isystemsautomation/HOMEMASTER/partner-kit/ENM-223-R1/specs.csv

characteristic | value
Specification Details Microcontroller | RP2350A dual-core microcontroller
Metering IC | ATM90E32AS (3-phase energy metering / power quality)
Storage | External QSPI Flash (W25Q32JV)
Power Input | 24 V DC nominal (V+ / 0V) with protection (reverse polarity diode, TVS, EMI filtering)
Voltage Inputs | 3 × L1/L2/L3-N + PE sensing, 85–265 V AC (mains measurement inputs)
Current Inputs | 3 × CT channels (external current-output CTs); secondary ≤ 60 mA RMS into a 6 Ω on-board burden. Full scale 120 / 60 / 30 mA at PGA ×1 / ×2 / ×4 (default ×2). Do not use 1 A or 5 A secondary CTs.
Measured quantities | RMS voltage L1/L2/L3 (V), RMS current L1/L2/L3 and neutral (A), active / reactive / apparent power per phase and total (W, var, VA), power factor per phase and total, line frequency (Hz), voltage–current angle L1/L2/L3 (°), THD L1/L2/L3 (%), active and reactive energy import/export per phase and total (Wh, varh), temperature (°C), sag / overvoltage / phase-loss / overcurrent / frequency / reverse-phase-sequence flags
Relay Outputs | 2 × SPDT dry-contact relays (NO / COM / NC). Rated load (system limit): 3 A @ 250 V AC (resistive contact rating). Max load: 750 VA @ 250 V AC, 90 W @ 30 V DC. Relay outputs are not internally fused ; external overcurrent protection is required.
RS-485 | RS-485 Modbus RTU (MAX485, half-duplex), non-isolated; TVS surge protection, PTC fuses, common-mode choke, fail-safe biasing
USB | USB-C (ESD protected), configuration and firmware upload
File System | LittleFS persistent configuration storage
User Interface | 4 buttons; 9 LEDs (power, 4 user LEDs, RX, TX, relay status)
Modbus Address Range | 1–247 (default is configurable; typically 3)
Modbus Baud Rate | 9600–115200 (default: 19200, 8N1)
Category Specification Details Terminal Specifications | Terminal type Pluggable screw terminal blocks, 5.08 mm pitch
Environmental Ratings | Operating temperature 0 °C to +40 °C
Mechanical &amp; Packaging | Product dimensions 71.5 × 90 × 59 mm (L × W × H)
File Description Link Field Board Schematic | Voltage sensing and CT front-end ENM-223-R1-FieldBoard.pdf
MCU Board Schematic | Controller, RS-485, USB, power conversion ENM-223-R1-MCUBoard.pdf
Relay Board Schematic | Relay output stage ENM-223-R1-RelayBoard.pdf
File Description Link EU Declaration of Conformity (DoC) | Signed EU Declaration of Conformity per Reg. (EC) 765/2008 and Decision 768/2008/EC DoC_ENM-223-R1.pdf
Datasheet | Technical specifications and electrical characteristics ENM-223-R1_Datasheet.pdf
