isystemsautomation/HOMEMASTER/partner-kit/MicroPLC/specs.csv

characteristic | value
Specification Details Microcontroller | ESP32-WROOM-32U-N16 (dual-core)
Flash Memory | 16 MB SPI flash
SRAM | 536 KB SRAM
Power Input | 24 V DC nominal (24VDC)
Digital Inputs | 1 × IEC 61131-2 compliant 24 V digital input (ISO1212 front-end), dry-contact (module-wetted), with PTC fuse, TVS surge and reverse-polarity protection
Relay Outputs | 1 × relay (HF115F-005-1ZS3), C and NC only (no NO) — functionally SPST-NC; closed when de-energised
Temperature Inputs | 1-Wire interface supported
User Interface | 1 button, status LEDs
Wi-Fi | Integrated Wi-Fi (ESP32)
Wi-Fi standard | IEEE 802.11 b/g/n (2.4 GHz)
RS-485 | RS-485 Modbus RTU (MAX485, half-duplex), non-isolated; TVS surge protection, PTC fuses, common-mode choke, fail-safe biasing
Storage | Internal ESP32 flash
USB | USB-C programming interface via CP2102N USB-UART bridge
RTC | PCF8563 RTC with CR2032 battery backup
Category Specification Details Terminal Specifications | Terminal type Pluggable screw terminal blocks, 5.08 mm pitch
Environmental Ratings | Operating temperature 0 °C to +40 °C
Mechanical &amp; Packaging | Product dimensions 35.5 × 91 × 67.3 mm (L × W × H)
File Description Link Schematic (MCU Board) | Main controller board schematic MCUBoard.pdf
Schematic (Relay Board) | Relay and power section schematic RelayBoard.pdf
File Description Link EU Declaration of Conformity (DoC) | Signed EU Declaration of Conformity per Reg. (EC) 765/2008 and Decision 768/2008/EC DoC_MicroPLC.pdf
Datasheet | Technical specifications and electrical characteristics MicroPLC_Datasheet.pdf
Resource Description Link Default ESPHome Config | Pre-configured YAML for Home Assistant microplc.yaml
