isystemsautomation/HOMEMASTER/AIO-422-R1/Images/AIO-FieldBoard.png

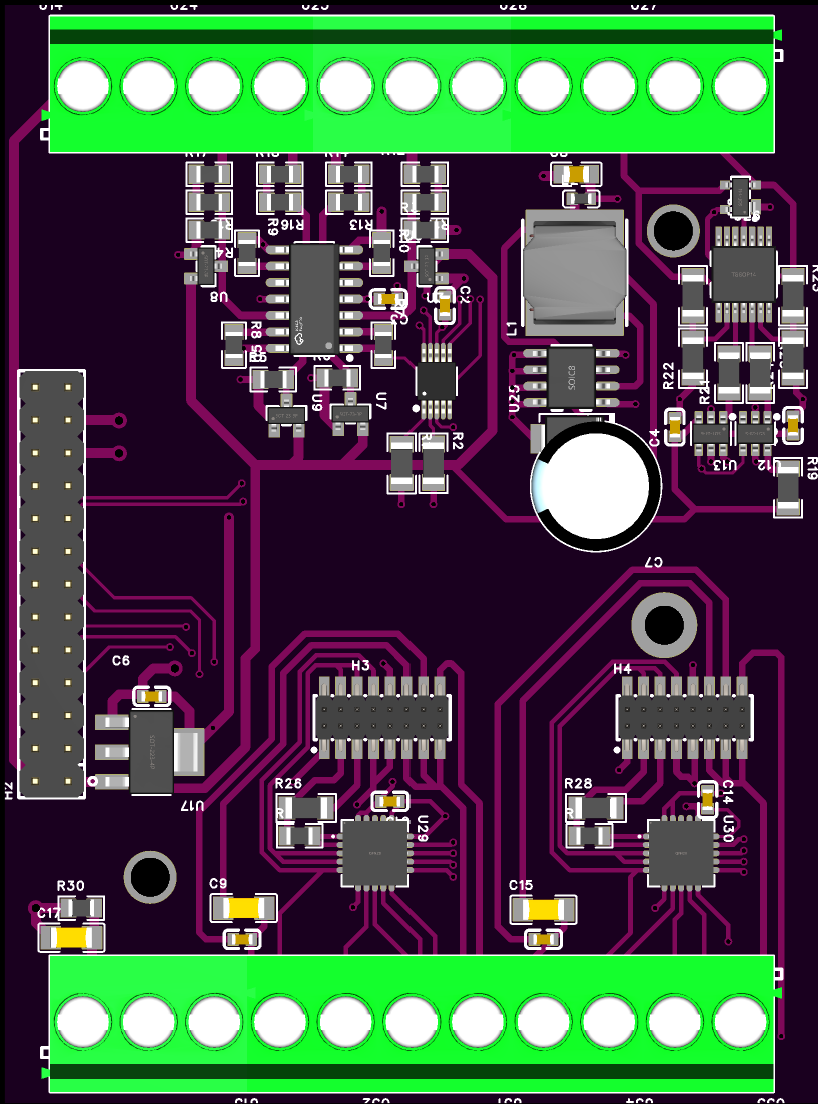
AIO-422-R1/Images/AIO-FieldBoard.png
