isystemsautomation/HOMEMASTER/AIO-422-R1/Images/AIO-MCUBoard.png

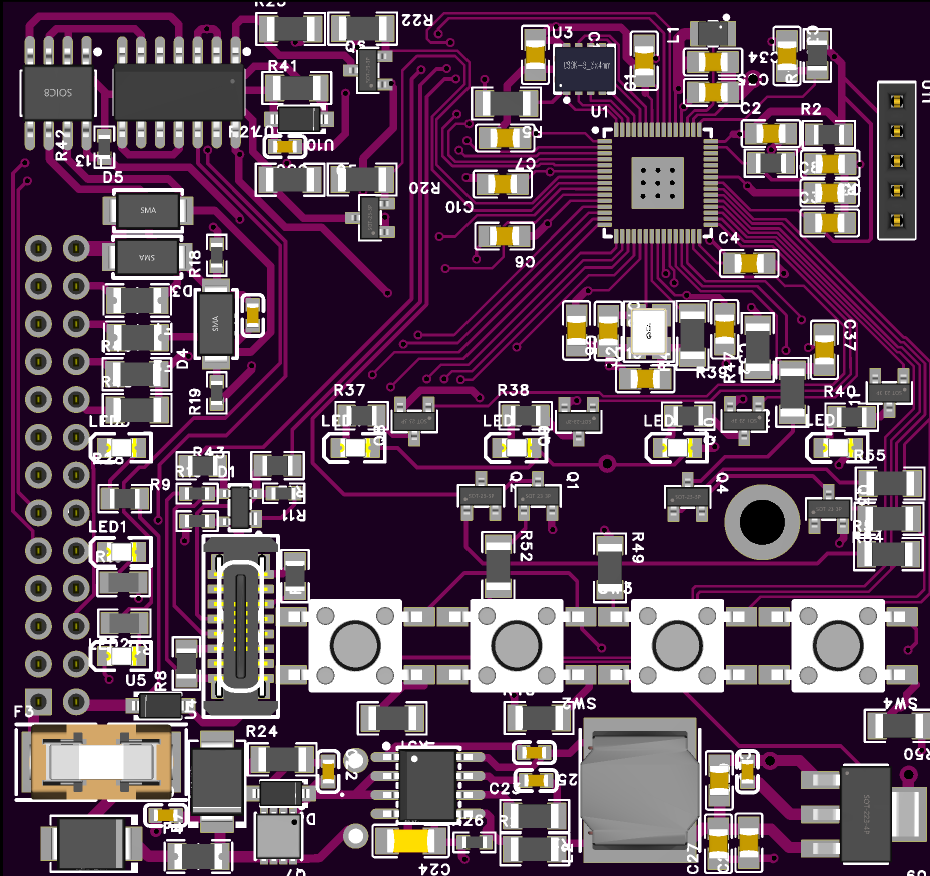
AIO-422-R1/Images/AIO-MCUBoard.png
