isystemsautomation/HOMEMASTER/AIO-422-R1/Images/AIO_AnalogInputs.png

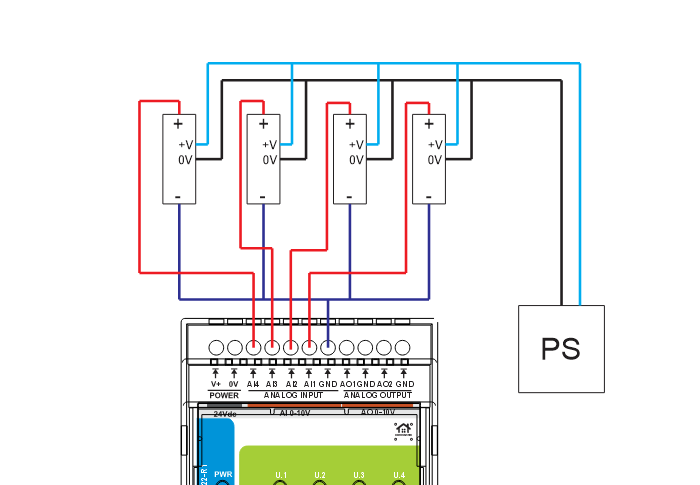
AIO-422-R1/Images/AIO_AnalogInputs.png
