isystemsautomation/HOMEMASTER/AIO-422-R1/Images/AIO_PowerSupply_Connection.png

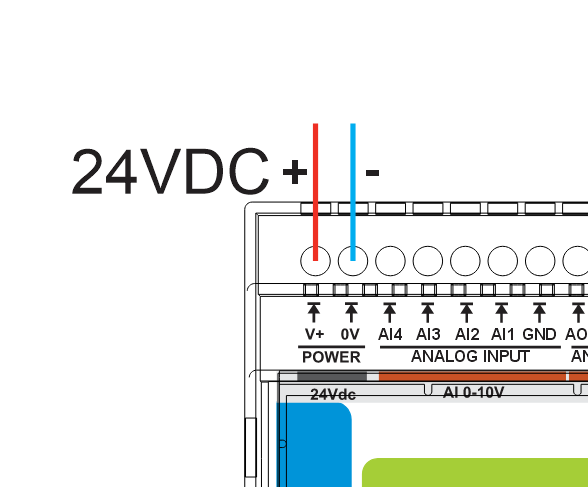
AIO-422-R1/Images/AIO_PowerSupply_Connection.png
