isystemsautomation/HOMEMASTER/AIO-422-R1/Images/AIO_RS485Connection.png

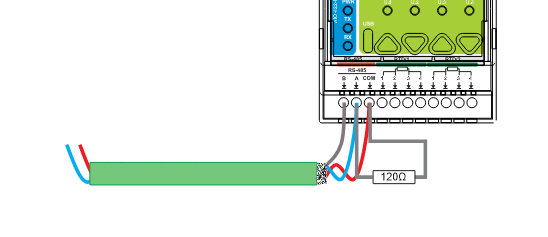
AIO-422-R1/Images/AIO_RS485Connection.png
