isystemsautomation/HOMEMASTER/AIO-422-R1/Images/AIO_RTD_Connection.png

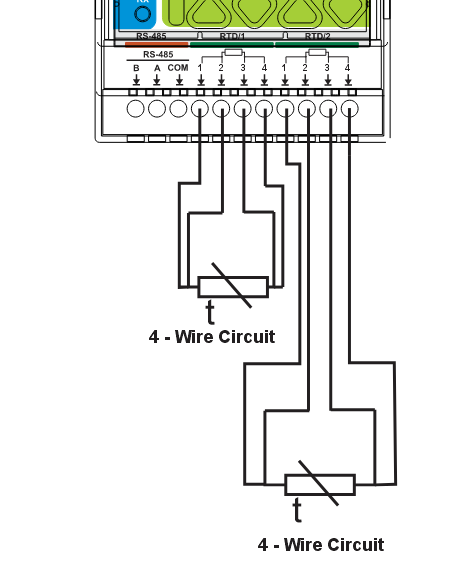
AIO-422-R1/Images/AIO_RTD_Connection.png
