isystemsautomation/HOMEMASTER/AIO-422-R1/Images/AIO_SystemBlockDiagram.png

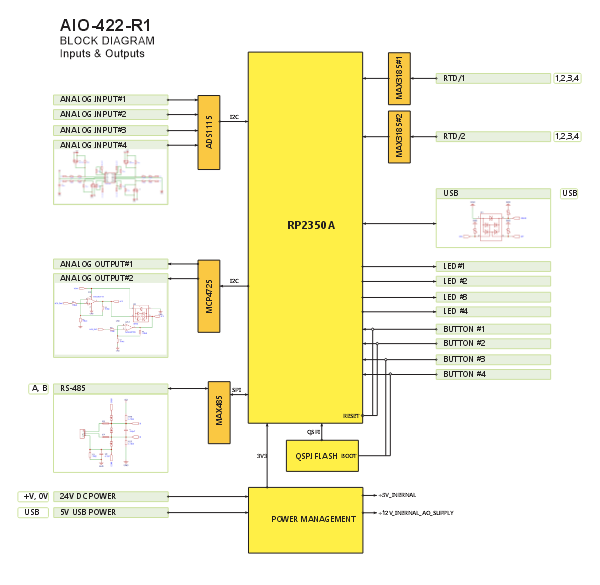
AIO-422-R1/Images/AIO_SystemBlockDiagram.png
