isystemsautomation/HOMEMASTER/AIO-422-R1/Images/DIO Dimensions.png

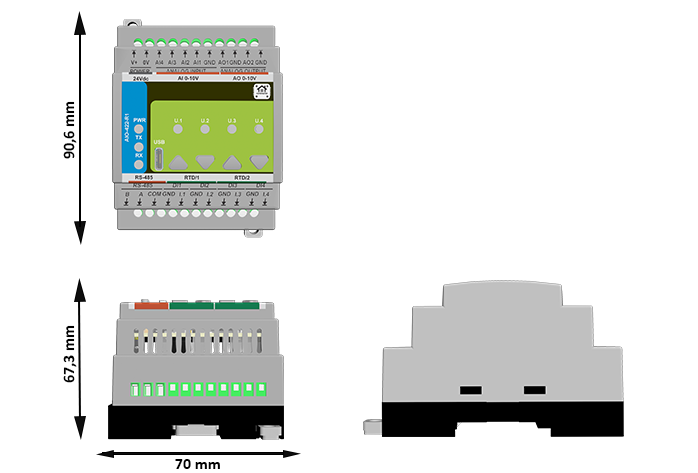
AIO-422-R1/Images/DIO Dimensions.png
