isystemsautomation/HOMEMASTER/AIO-422-R1/Images/FieldBoard_Diagram.png

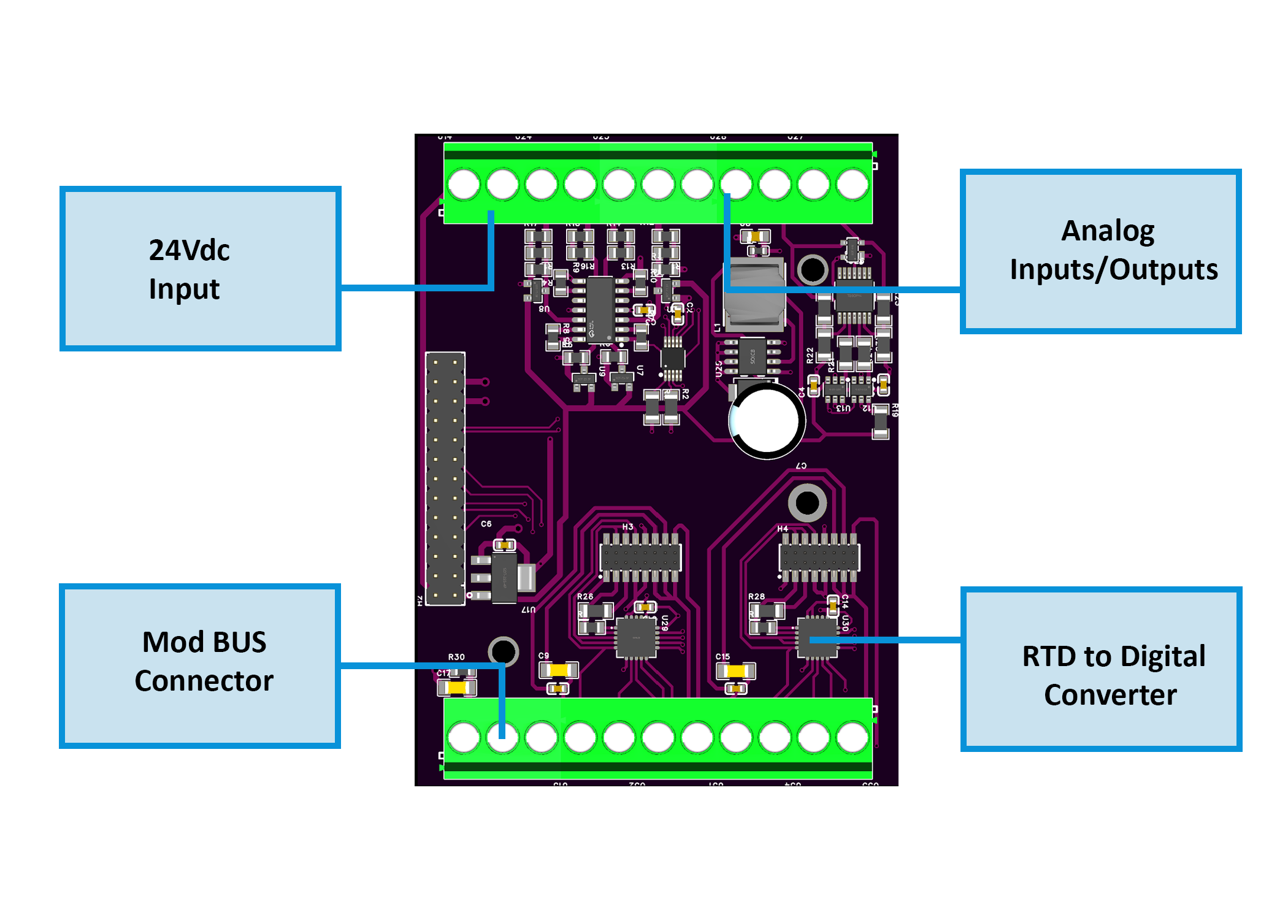
AIO-422-R1/Images/FieldBoard_Diagram.png
