isystemsautomation/HOMEMASTER/AIO-422-R1/Images/photo3.png

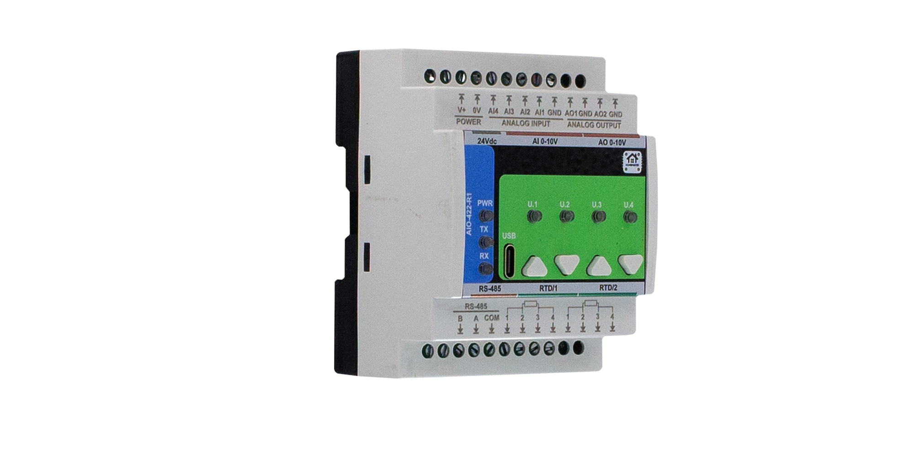
AIO-422-R1/Images/photo3.png
