isystemsautomation/HOMEMASTER/AIO-422-R1/Images/RS-485 Connection.png

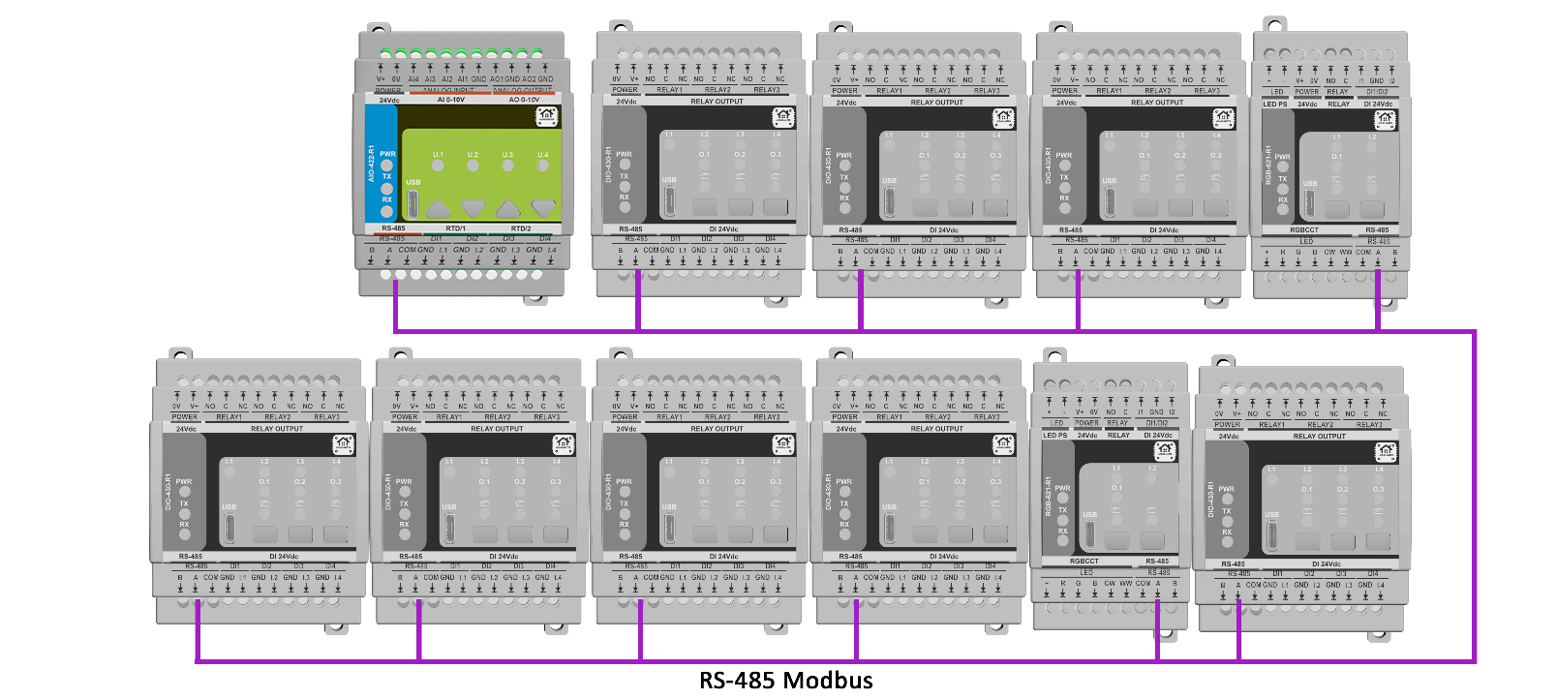
AIO-422-R1/Images/RS-485 Connection.png
