isystemsautomation/HOMEMASTER/ALM-173-R1/Images/photo3.png

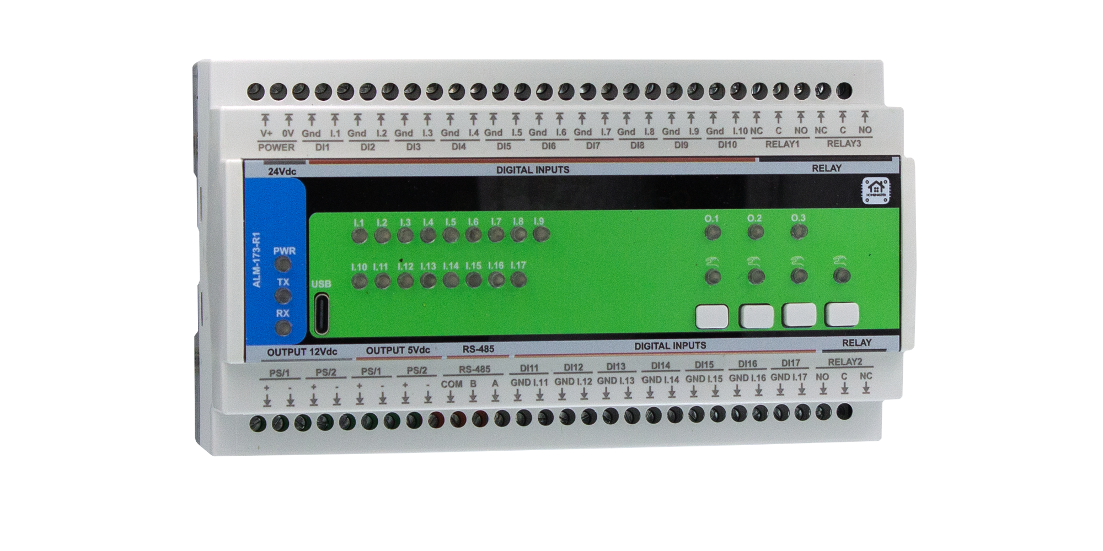
ALM-173-R1/Images/photo3.png
