isystemsautomation/HOMEMASTER/DIM-420-R1/Images/DIM_LN_Connection.png

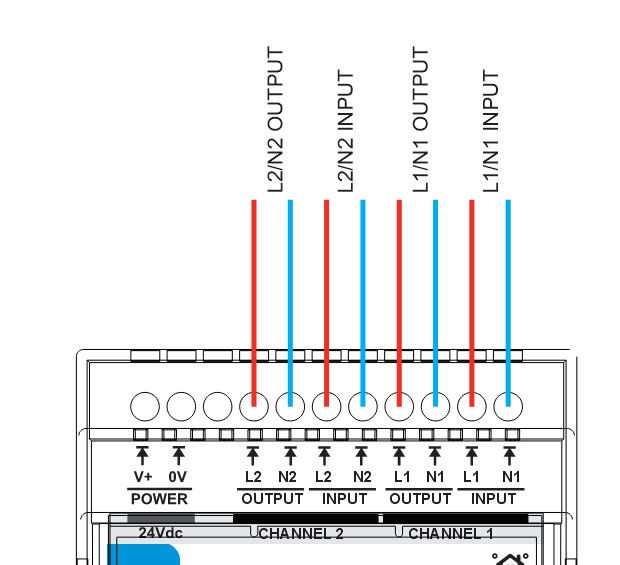
DIM-420-R1/Images/DIM_LN_Connection.png
