isystemsautomation/HOMEMASTER/DIM-420-R1/Images/DIM_SystemBlockDiagram.png

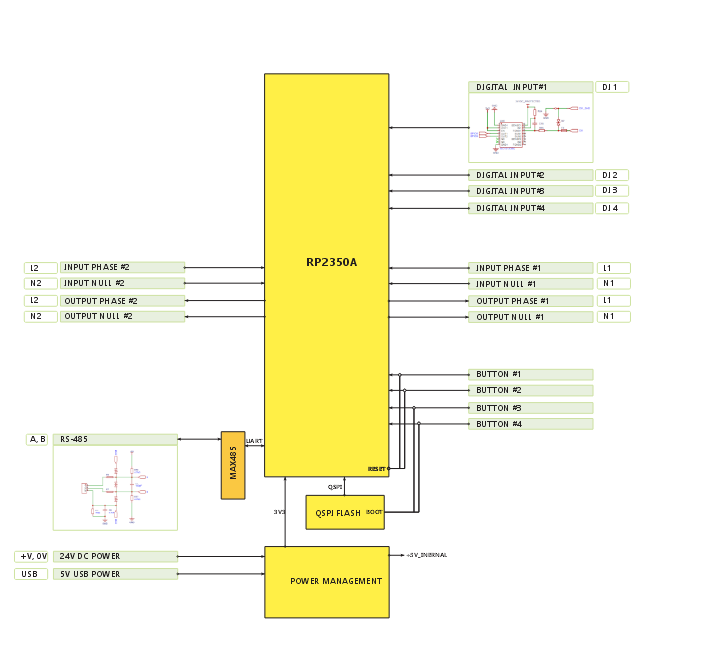
DIM-420-R1/Images/DIM_SystemBlockDiagram.png
