isystemsautomation/HOMEMASTER/ENM-223-R1/Images/ENM_24Vdc.png

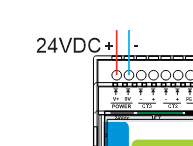
ENM-223-R1/Images/ENM_24Vdc.png
