isystemsautomation/HOMEMASTER/ENM-223-R1/Images/ENM_CTConnection.png

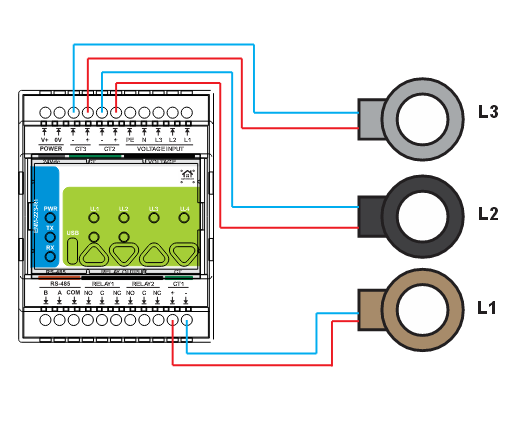
ENM-223-R1/Images/ENM_CTConnection.png
