isystemsautomation/HOMEMASTER/ENM-223-R1/Images/ENM_PhaseConnection.png

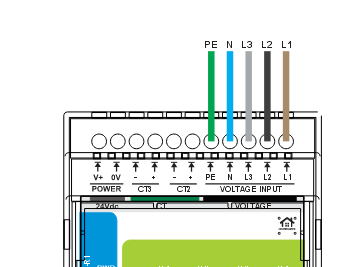
ENM-223-R1/Images/ENM_PhaseConnection.png
