isystemsautomation/HOMEMASTER/ENM-223-R1/Images/ENM_RelayConnection.png

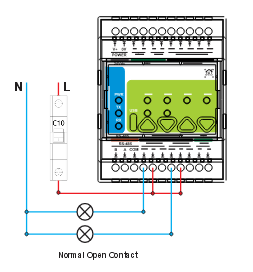
ENM-223-R1/Images/ENM_RelayConnection.png
