isystemsautomation/HOMEMASTER/ENM-223-R1/Images/photo3.png

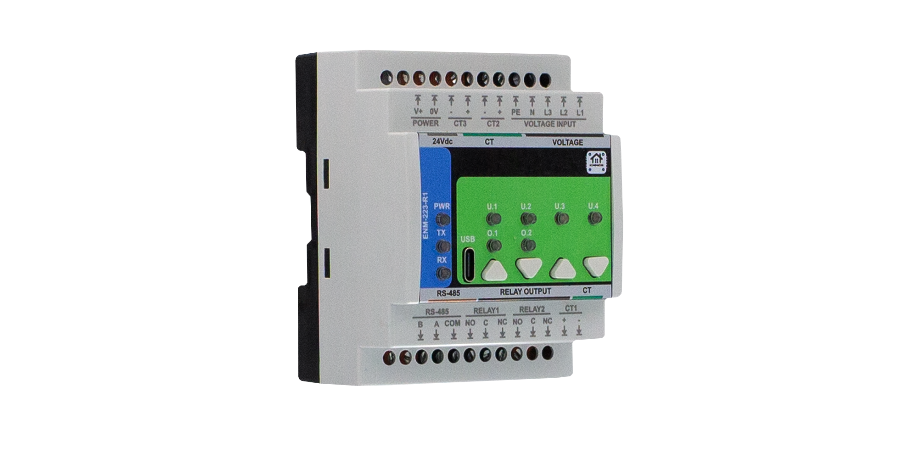
ENM-223-R1/Images/photo3.png
