isystemsautomation/HOMEMASTER/MicroPLC/Images/dimensions.png

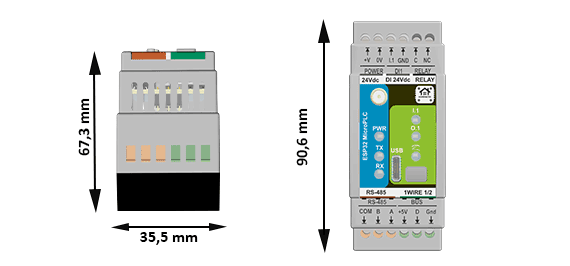
MicroPLC/Images/dimensions.png
