isystemsautomation/HOMEMASTER/MiniPLC/Images/Photo1.png

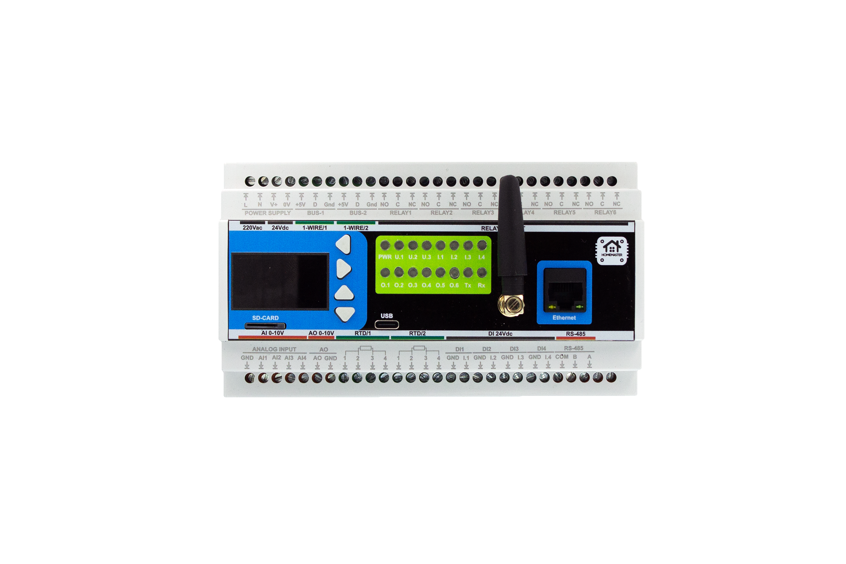
MiniPLC/Images/Photo1.png
