isystemsautomation/HOMEMASTER/OpenthermGateway/Images/description3.png

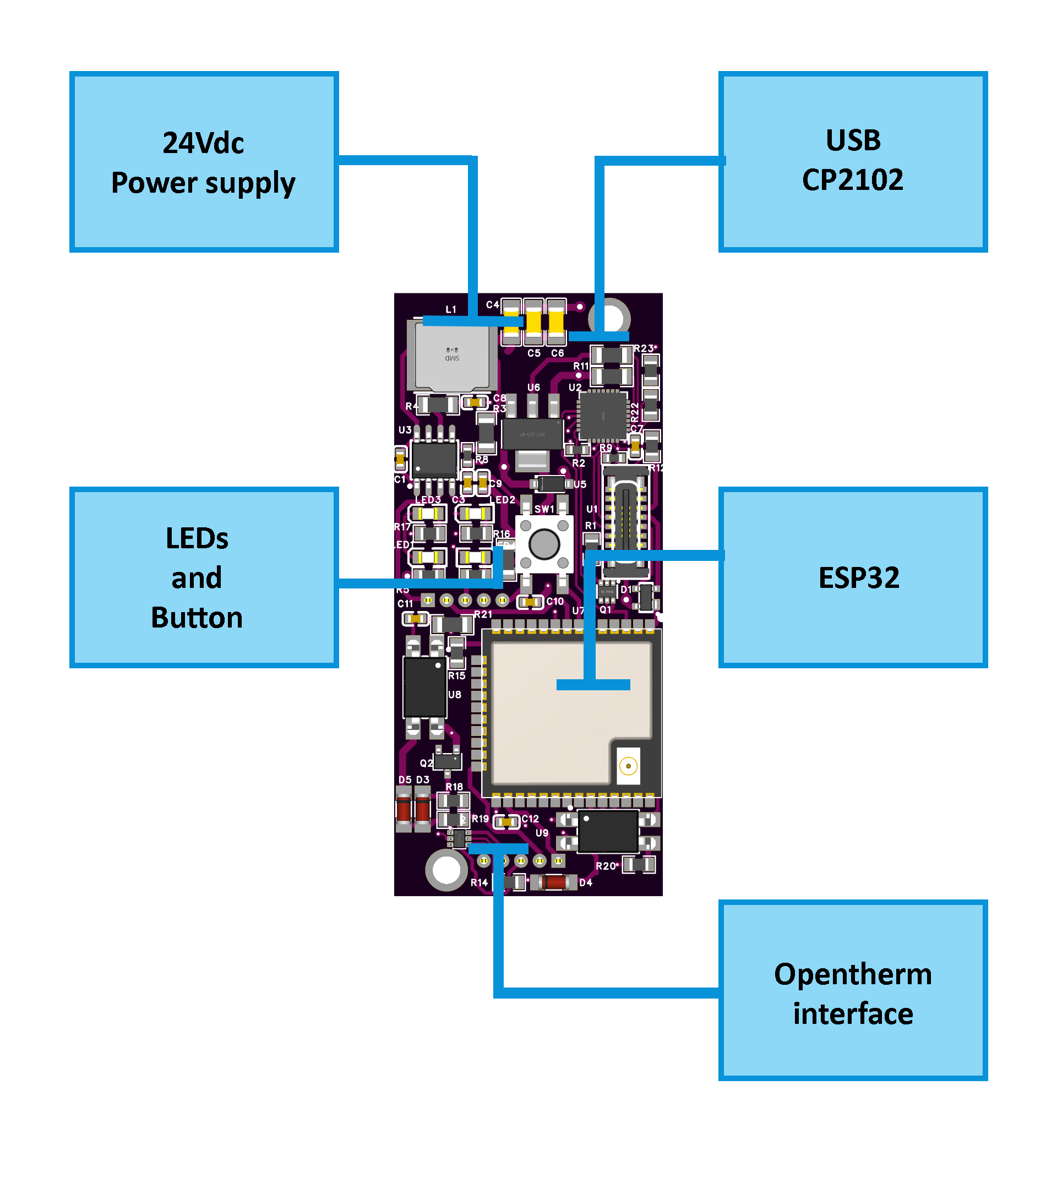
OpenthermGateway/Images/description3.png
