isystemsautomation/HOMEMASTER/OpenthermGateway/Images/description4.png

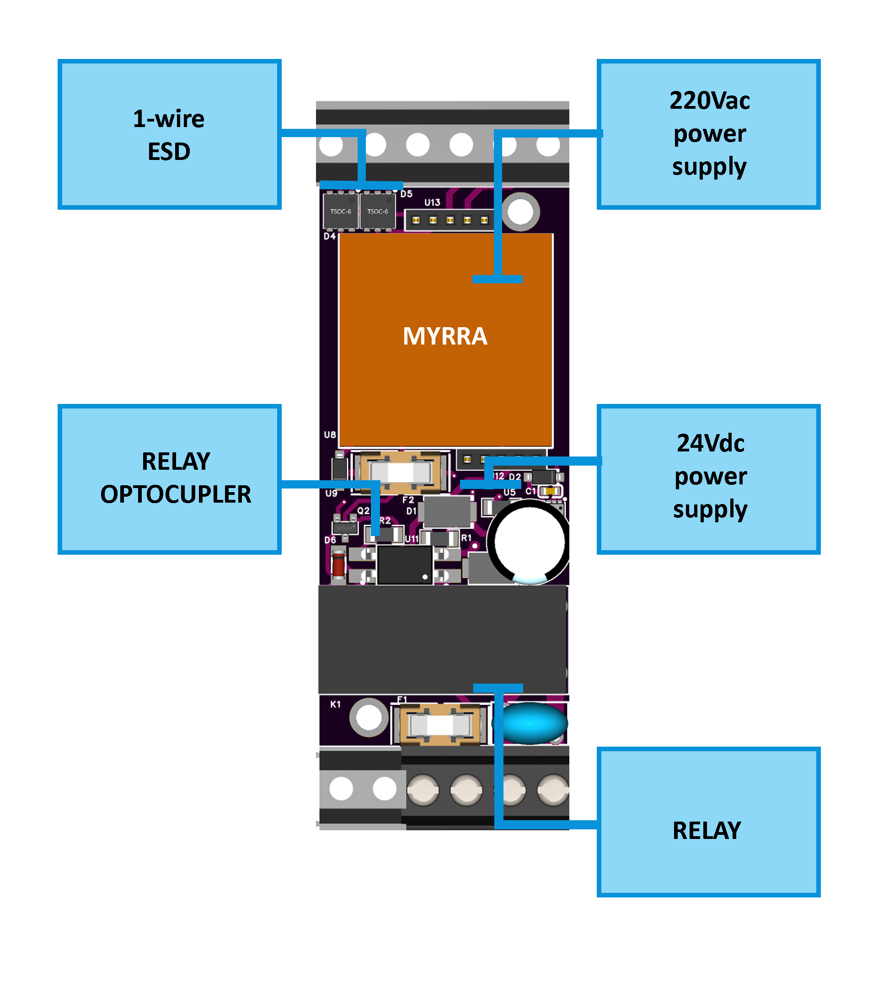
OpenthermGateway/Images/description4.png
