isystemsautomation/HOMEMASTER/OpenthermGateway/Images/OpenTherm_SystemBlock.png

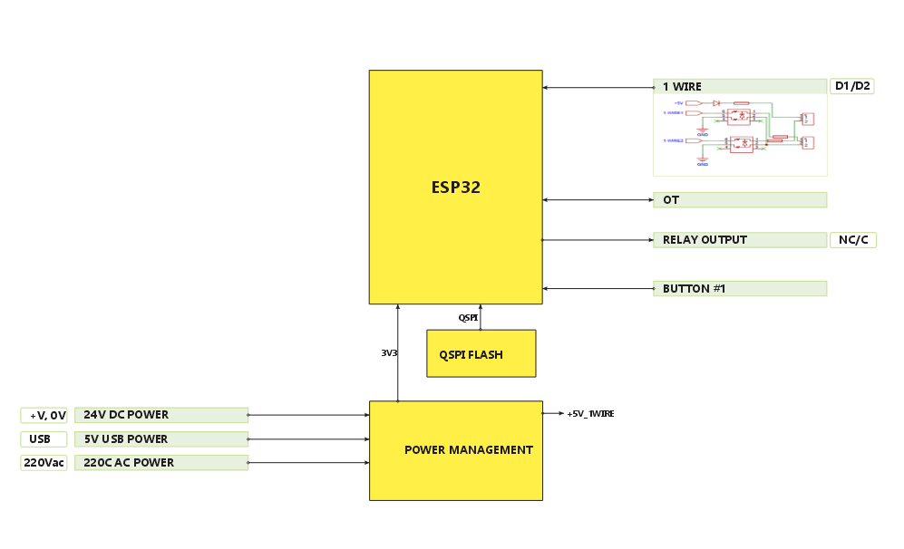
OpenthermGateway/Images/OpenTherm_SystemBlock.png
