isystemsautomation/HOMEMASTER/OpenthermGateway/photo2.png

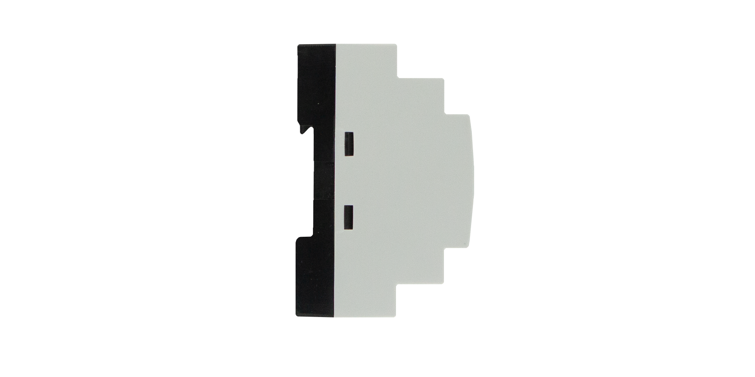
OpenthermGateway/photo2.png
