isystemsautomation/HOMEMASTER/partner-kit/AIO-422-R1/images/01-main.webp

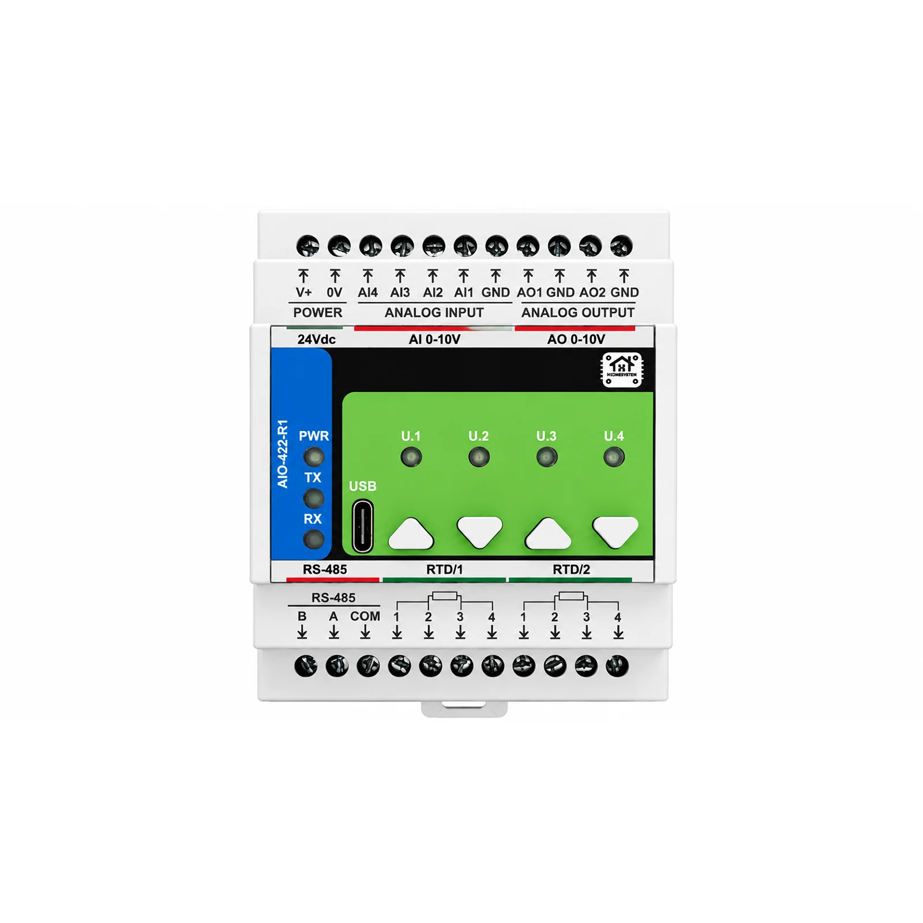
partner-kit/AIO-422-R1/images/01-main.webp
