isystemsautomation/HOMEMASTER/partner-kit/AIO-422-R1/images/02-listing-1.webp

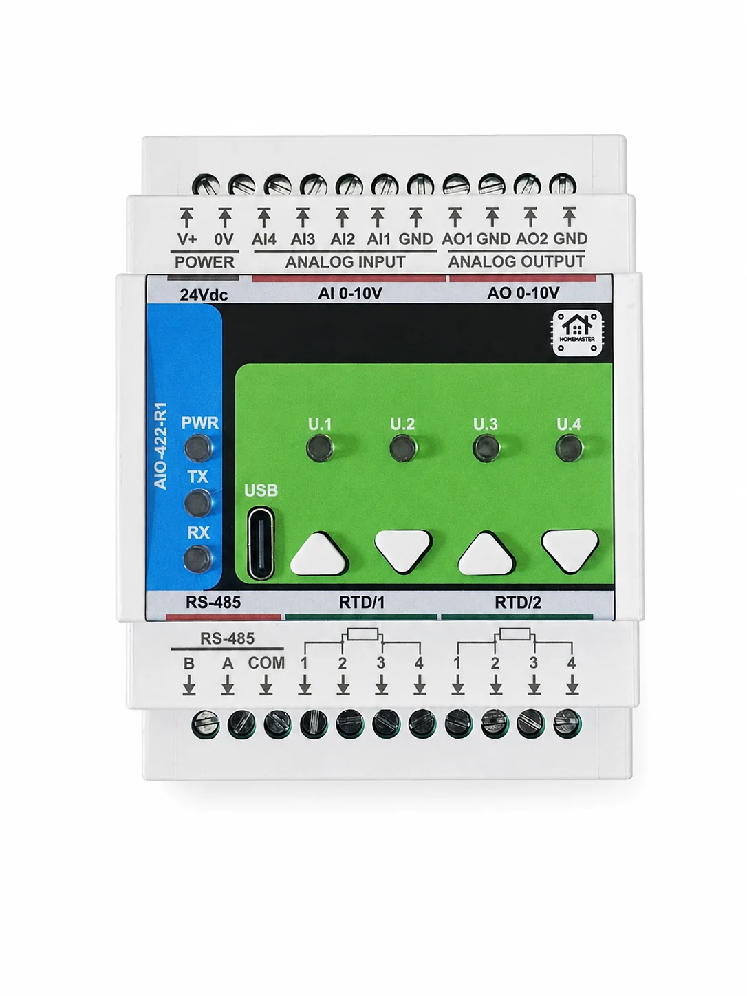
partner-kit/AIO-422-R1/images/02-listing-1.webp
