isystemsautomation/HOMEMASTER/partner-kit/AIO-422-R1/images/03-listing-2.webp

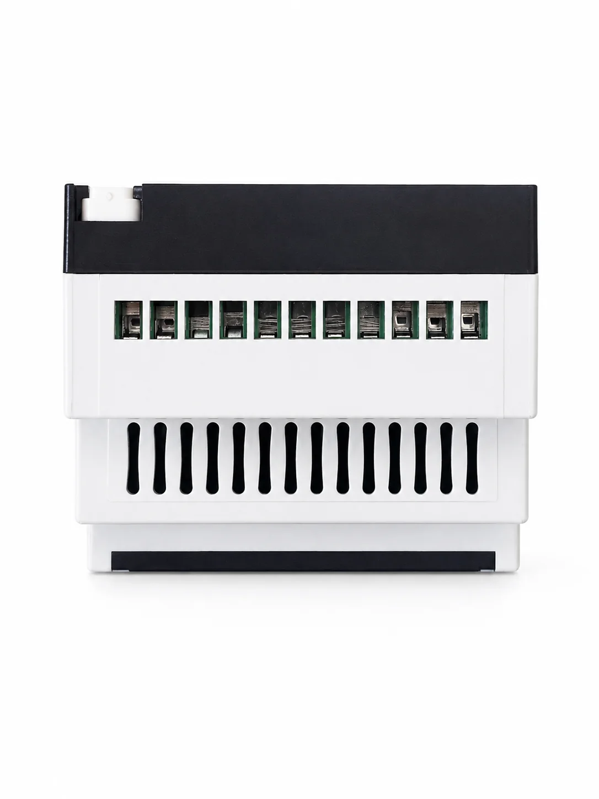
partner-kit/AIO-422-R1/images/03-listing-2.webp
