isystemsautomation/HOMEMASTER/partner-kit/AIO-422-R1/images/04-listing-3.webp

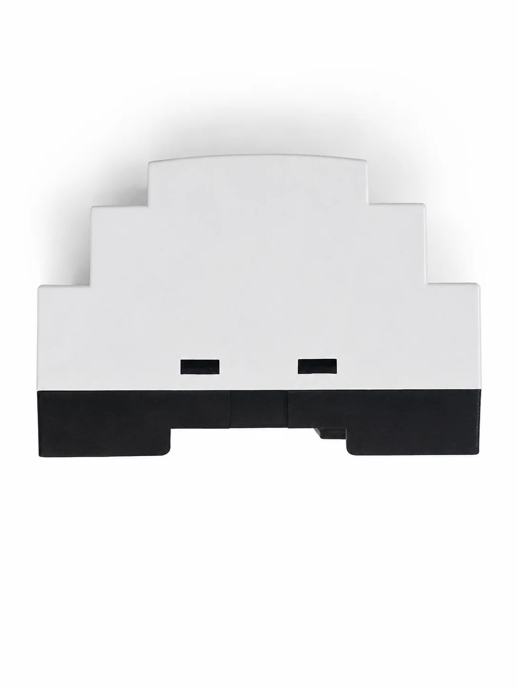
partner-kit/AIO-422-R1/images/04-listing-3.webp
