isystemsautomation/HOMEMASTER/partner-kit/AIO-422-R1/images/05-package.webp

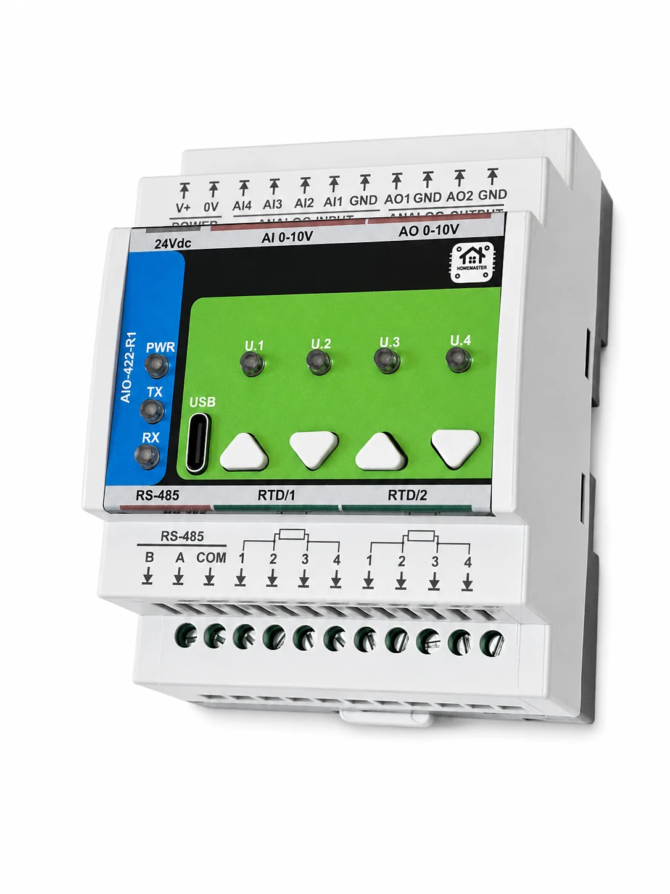
partner-kit/AIO-422-R1/images/05-package.webp
