isystemsautomation/HOMEMASTER/partner-kit/ALM-173-R1/images/01-main.webp

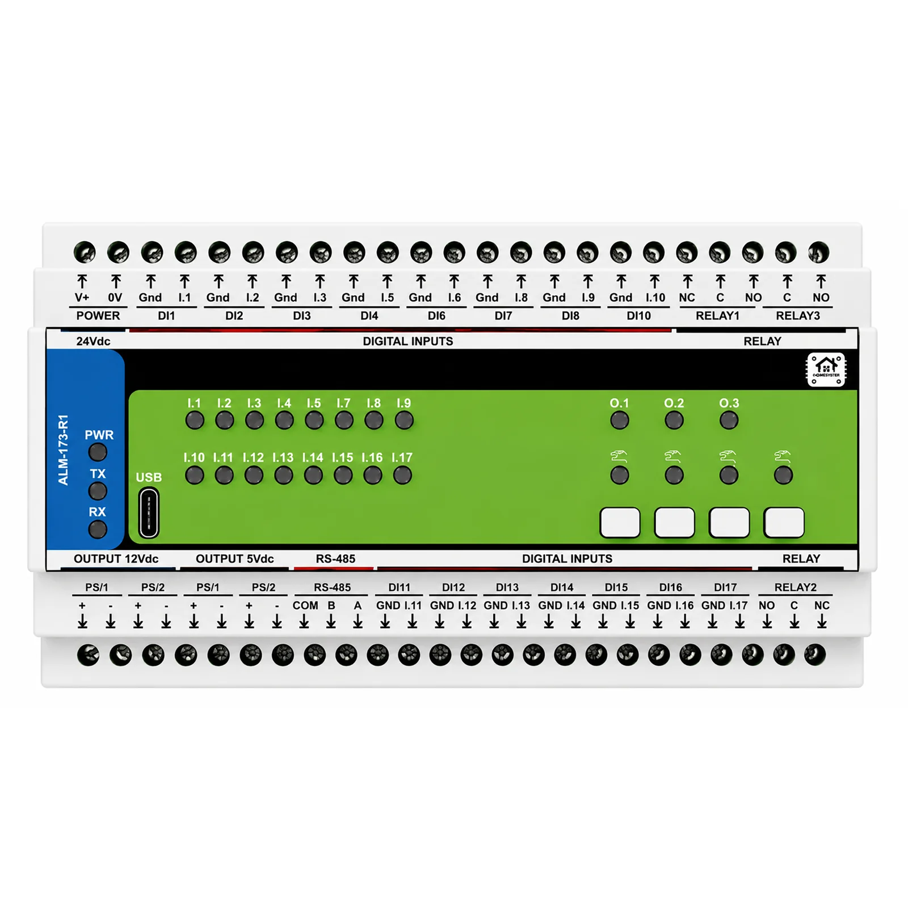
partner-kit/ALM-173-R1/images/01-main.webp
