isystemsautomation/HOMEMASTER/partner-kit/ALM-173-R1/images/02-listing-1.webp

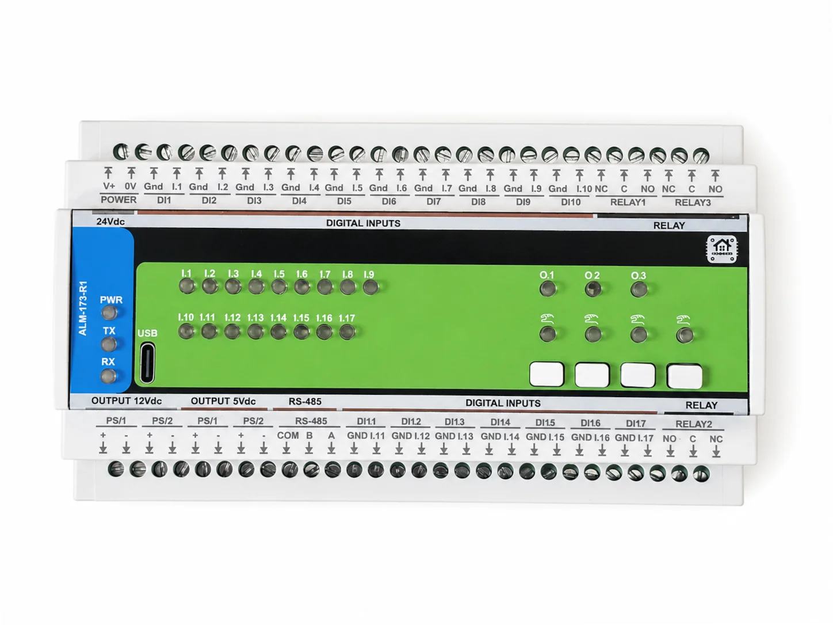
partner-kit/ALM-173-R1/images/02-listing-1.webp
