isystemsautomation/HOMEMASTER/partner-kit/ALM-173-R1/images/03-listing-2.webp

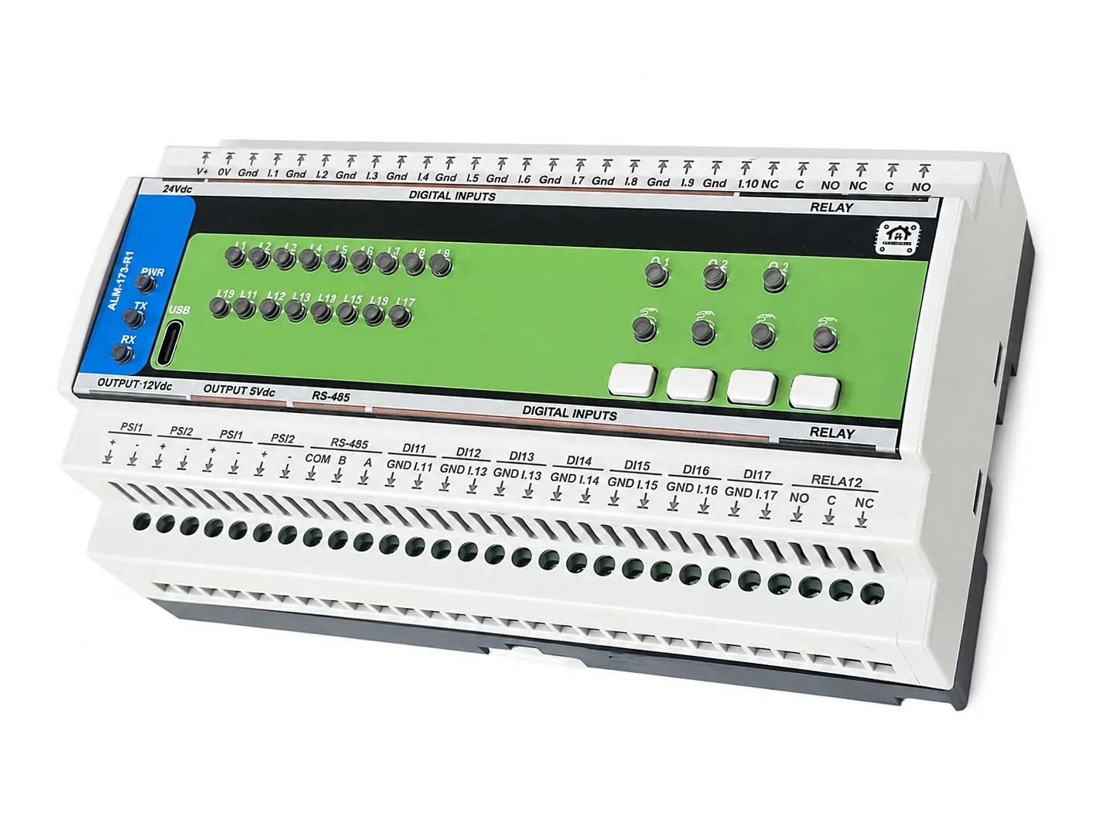
partner-kit/ALM-173-R1/images/03-listing-2.webp
