isystemsautomation/HOMEMASTER/partner-kit/ALM-173-R1/images/04-listing-3.webp

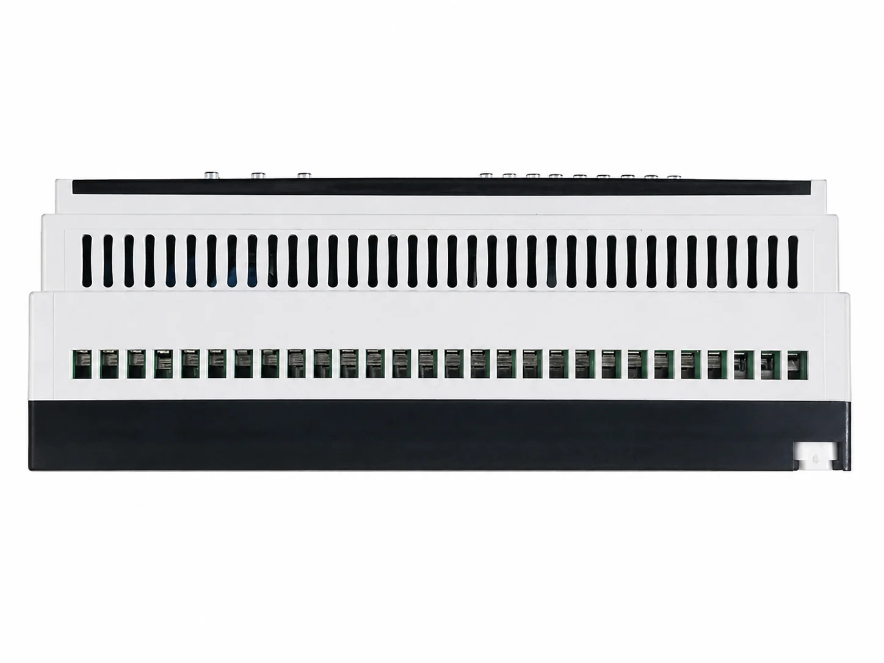
partner-kit/ALM-173-R1/images/04-listing-3.webp
