isystemsautomation/HOMEMASTER/partner-kit/DIM-420-R1/images/01-main.webp

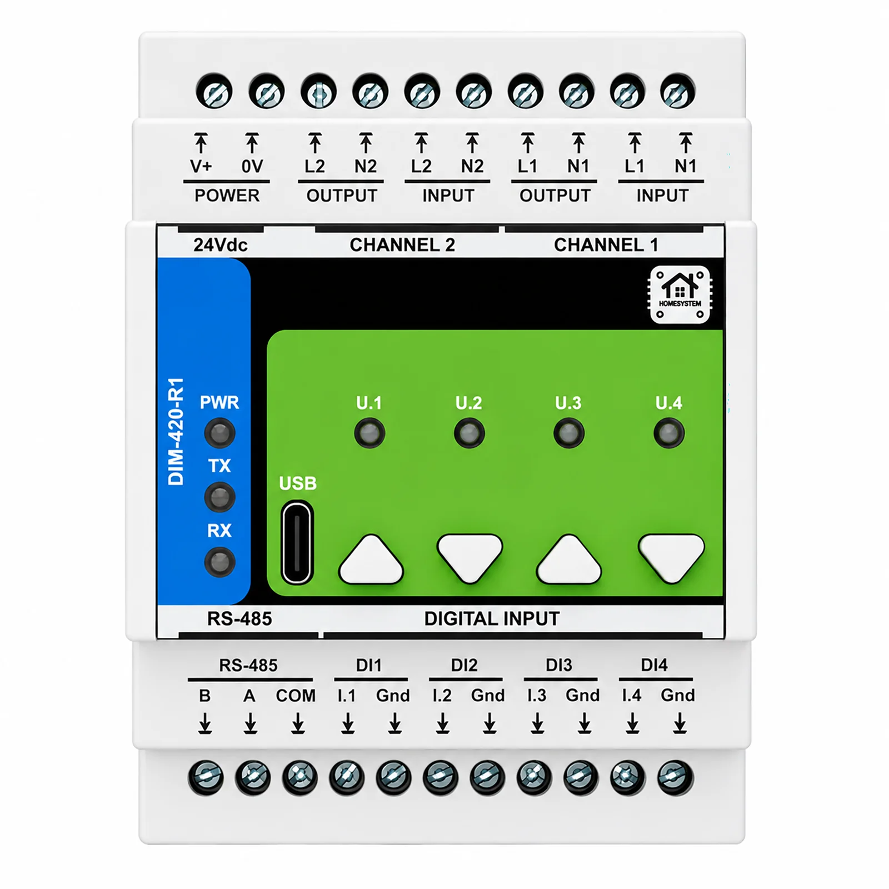
partner-kit/DIM-420-R1/images/01-main.webp
