isystemsautomation/HOMEMASTER/partner-kit/DIM-420-R1/images/06-dimensions.webp

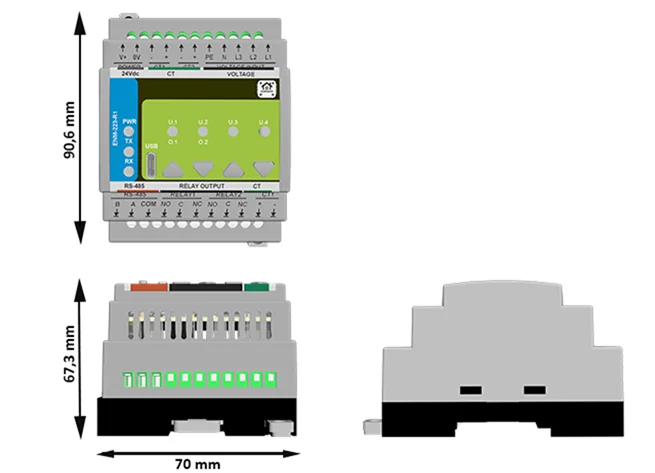
partner-kit/DIM-420-R1/images/06-dimensions.webp
