isystemsautomation/HOMEMASTER/partner-kit/DIO-430-R1/images/01-main.webp

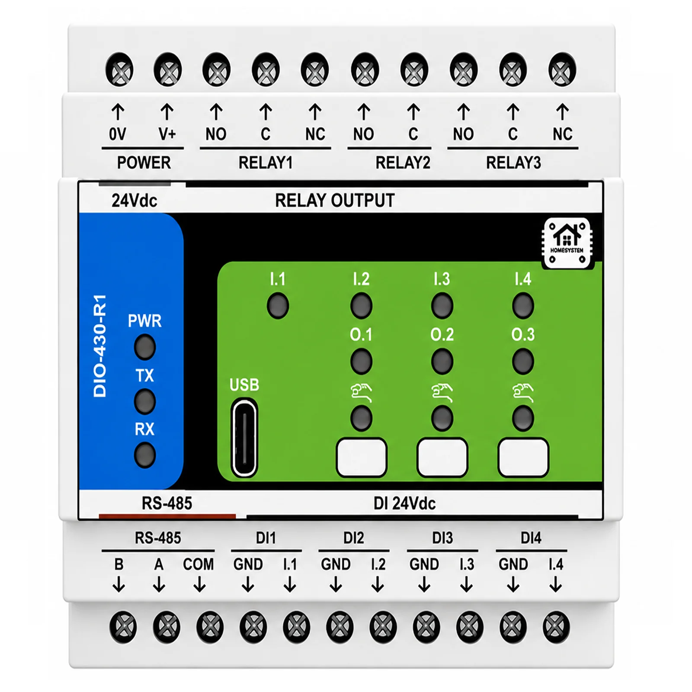
partner-kit/DIO-430-R1/images/01-main.webp
