isystemsautomation/HOMEMASTER/partner-kit/DIO-430-R1/images/02-listing-1.webp

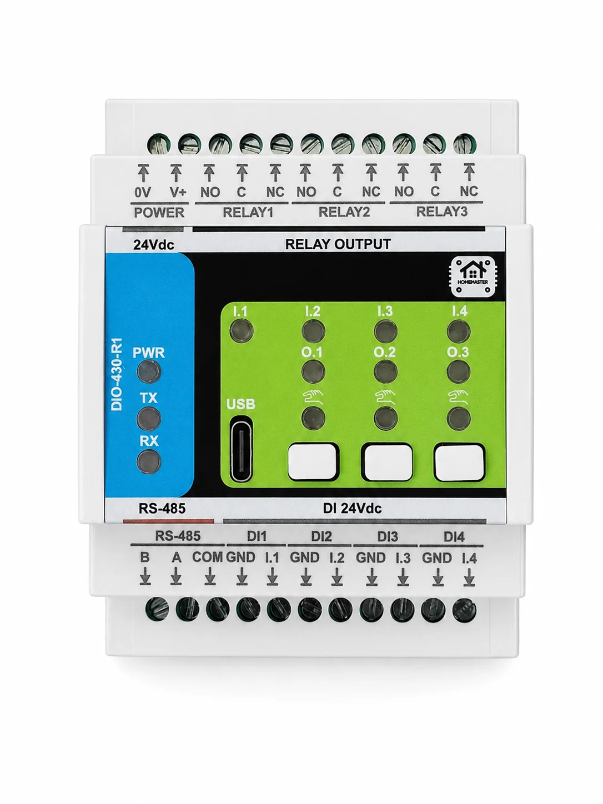
partner-kit/DIO-430-R1/images/02-listing-1.webp
