isystemsautomation/HOMEMASTER/partner-kit/DIO-430-R1/images/05-package.webp

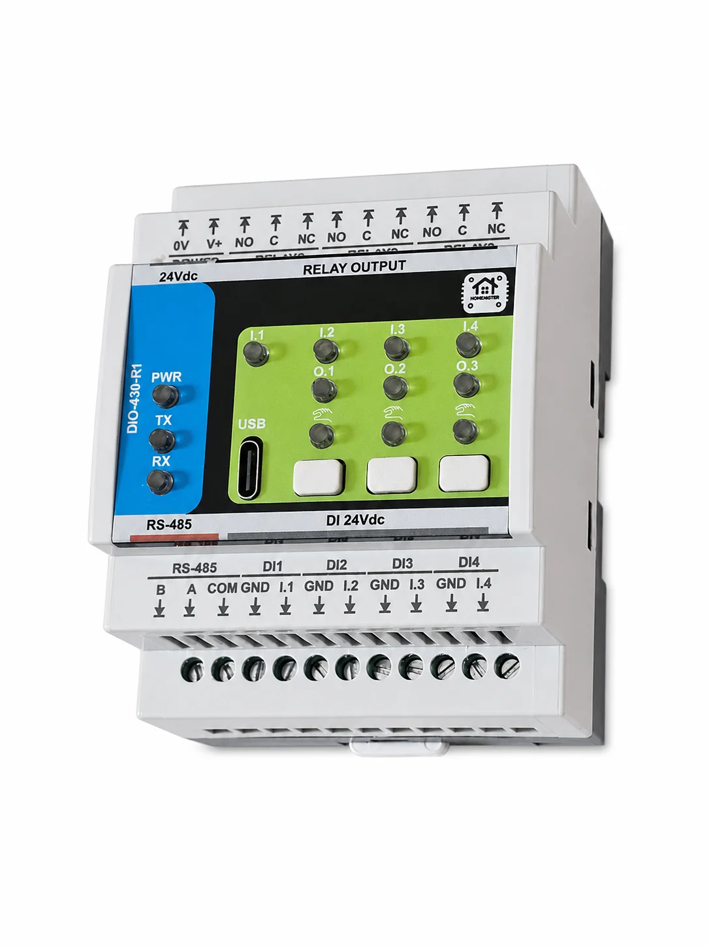
partner-kit/DIO-430-R1/images/05-package.webp
