isystemsautomation/HOMEMASTER/partner-kit/ENM-223-R1/images/01-main.webp

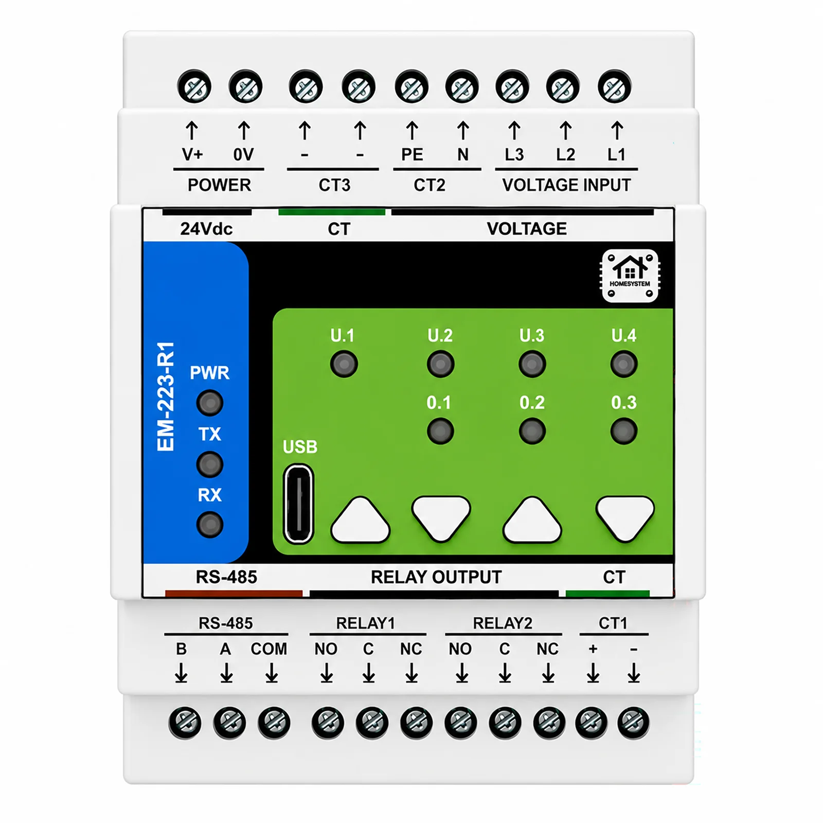
partner-kit/ENM-223-R1/images/01-main.webp
