isystemsautomation/HOMEMASTER/partner-kit/ENM-223-R1/images/02-listing-1.webp

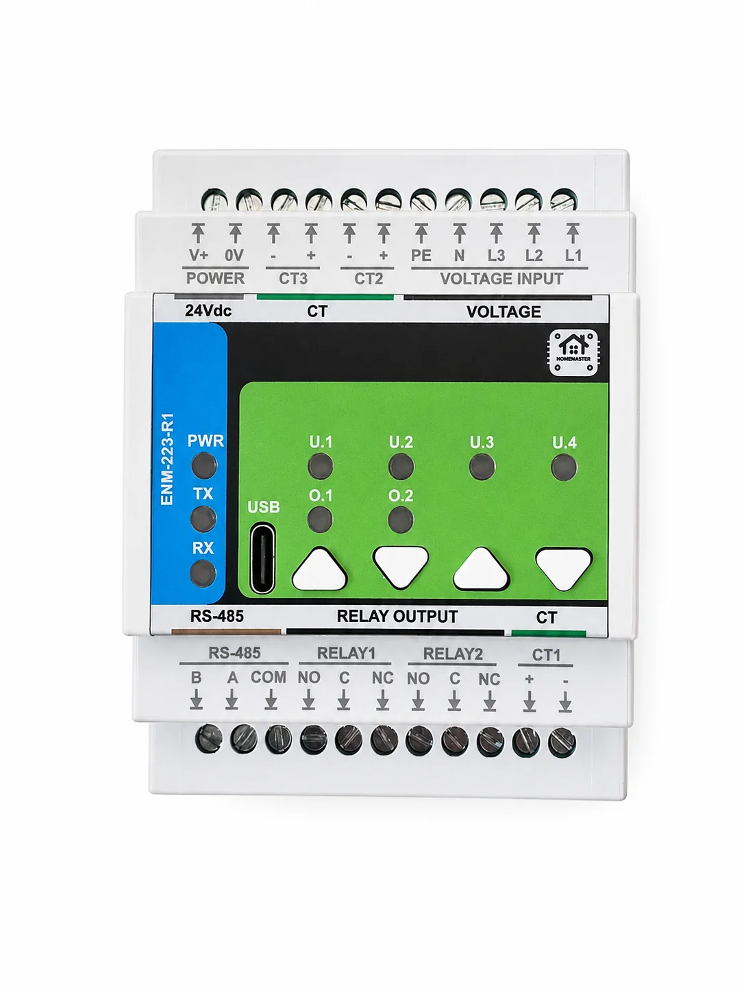
partner-kit/ENM-223-R1/images/02-listing-1.webp
