isystemsautomation/HOMEMASTER/partner-kit/ENM-223-R1/images/05-package.webp

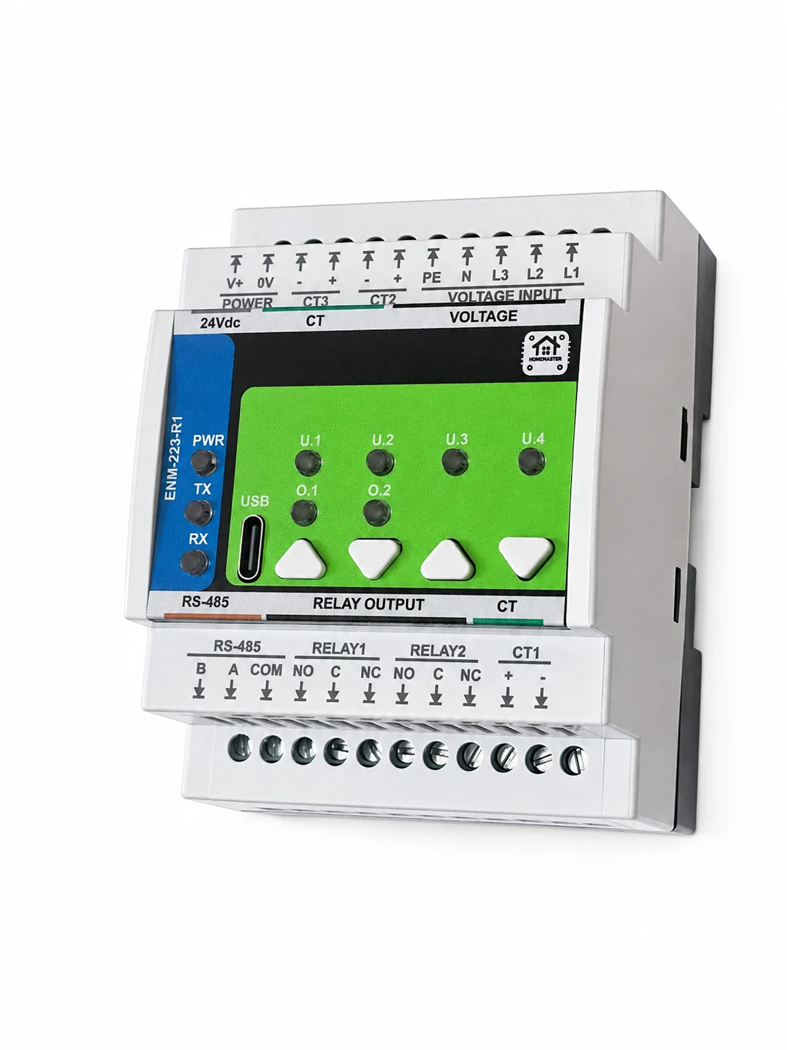
partner-kit/ENM-223-R1/images/05-package.webp
