isystemsautomation/HOMEMASTER/partner-kit/MicroPLC/images/01-main.webp

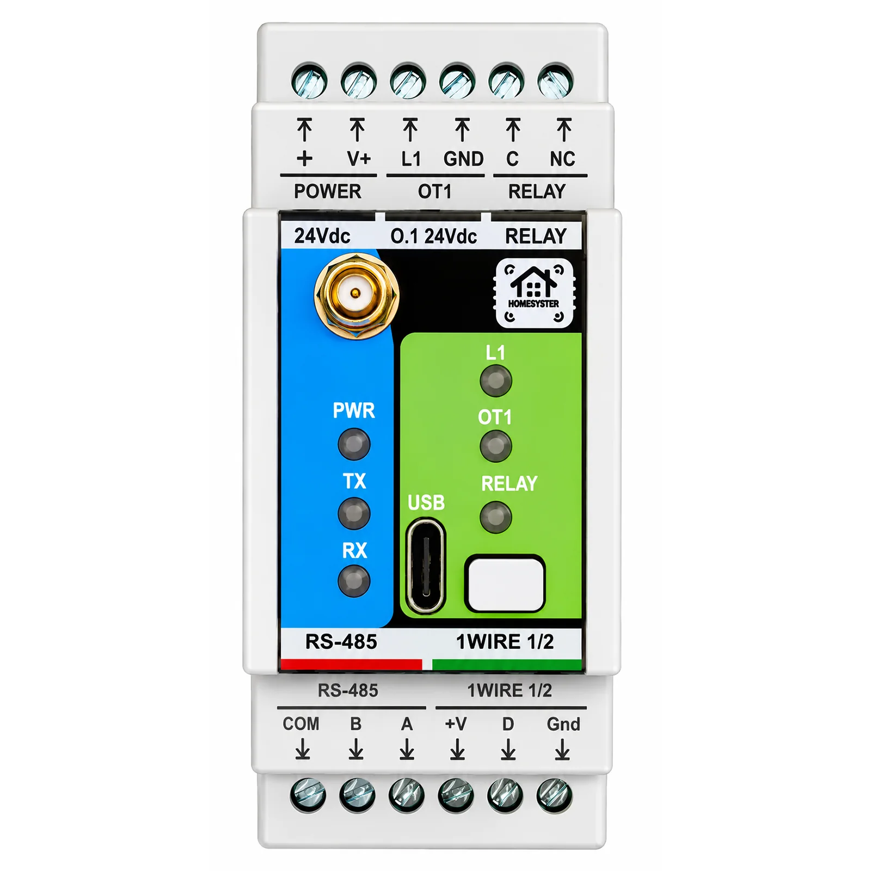
partner-kit/MicroPLC/images/01-main.webp
