isystemsautomation/HOMEMASTER/partner-kit/MicroPLC/images/02-listing-1.webp

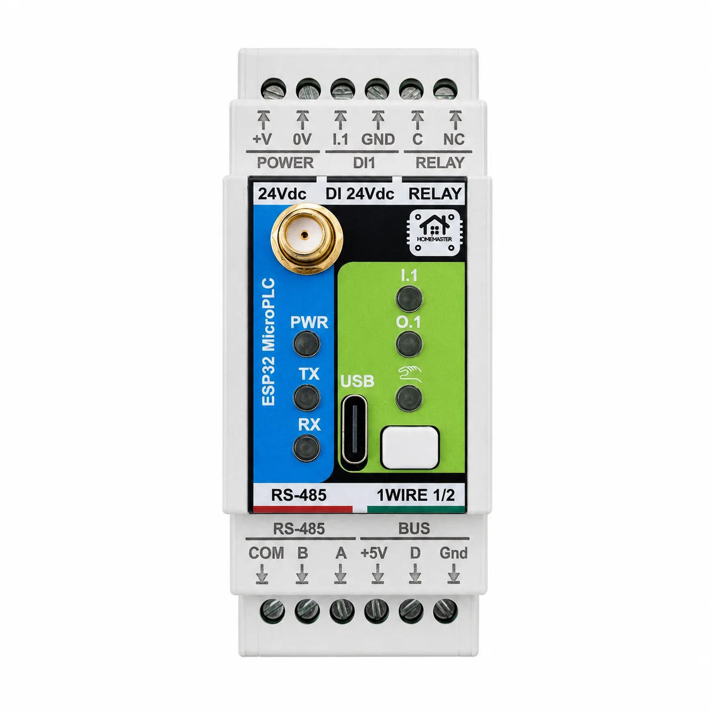
partner-kit/MicroPLC/images/02-listing-1.webp
