isystemsautomation/HOMEMASTER/partner-kit/MicroPLC/images/03-listing-2.webp

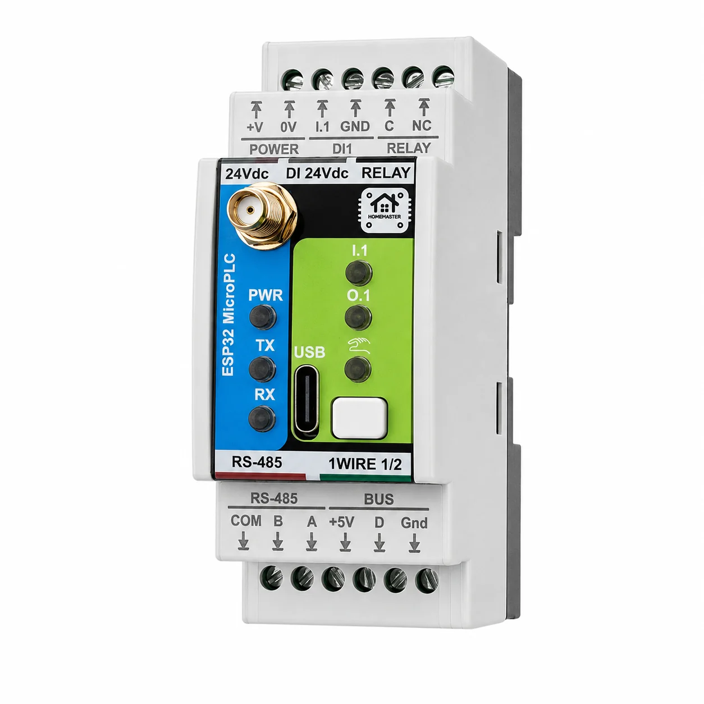
partner-kit/MicroPLC/images/03-listing-2.webp
