isystemsautomation/HOMEMASTER/partner-kit/MicroPLC/images/04-listing-3.webp

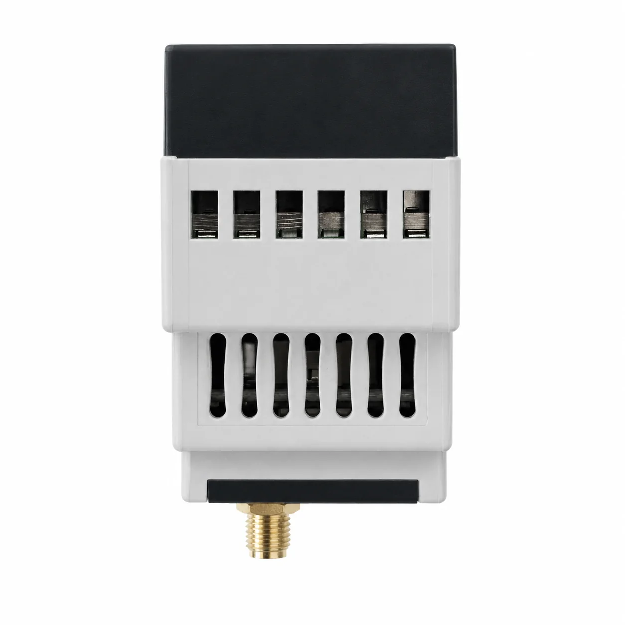
partner-kit/MicroPLC/images/04-listing-3.webp
