isystemsautomation/HOMEMASTER/partner-kit/MiniPLC/images/01-main.webp

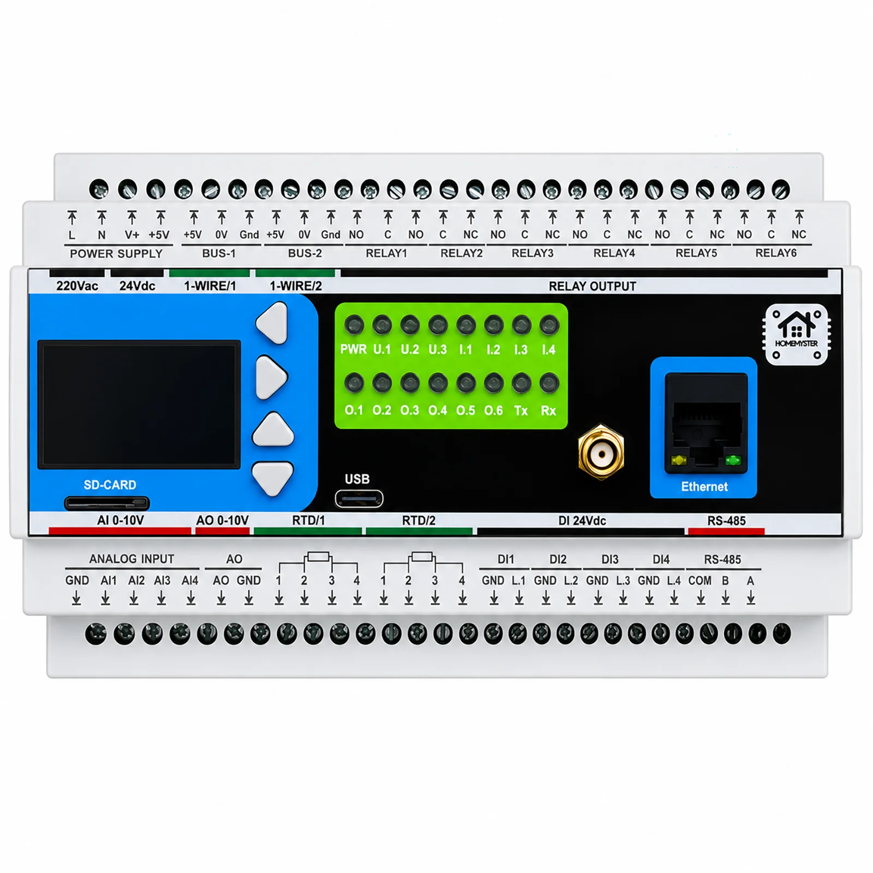
partner-kit/MiniPLC/images/01-main.webp
