isystemsautomation/HOMEMASTER/partner-kit/MiniPLC/images/02-listing-1.webp

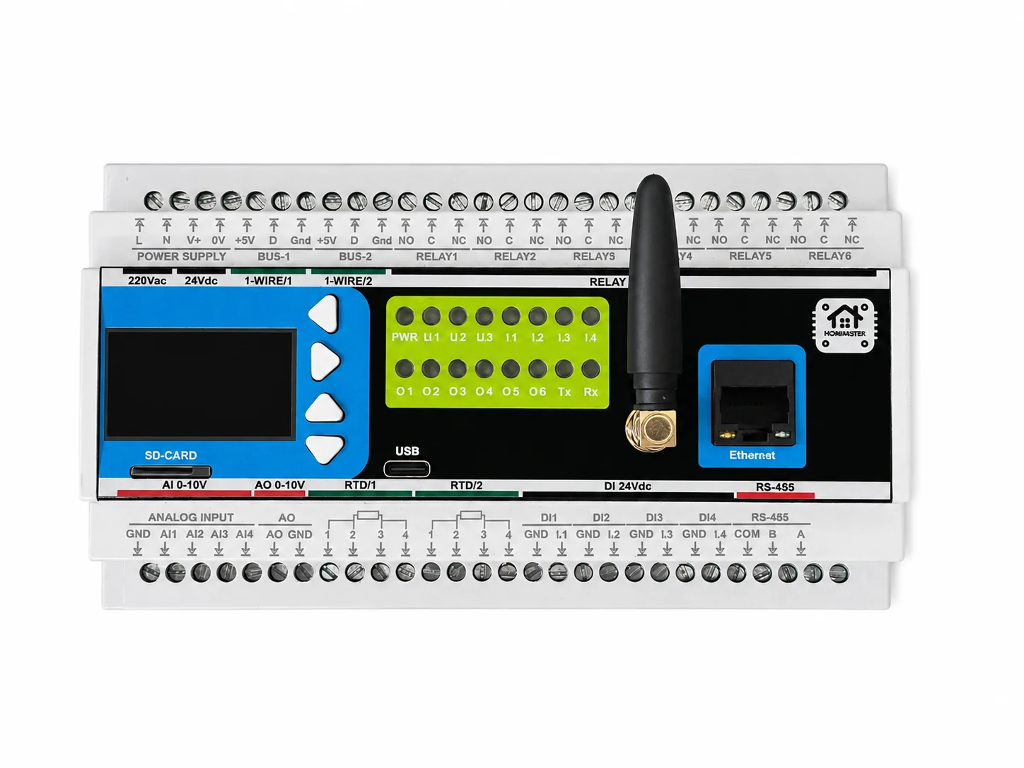
partner-kit/MiniPLC/images/02-listing-1.webp
