isystemsautomation/HOMEMASTER/partner-kit/MiniPLC/images/03-listing-2.webp

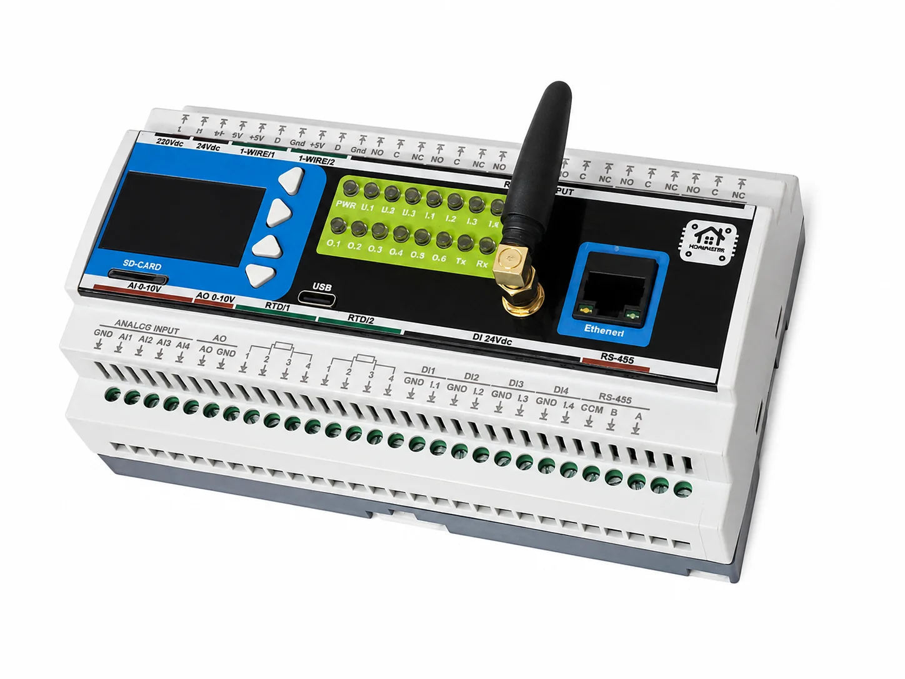
partner-kit/MiniPLC/images/03-listing-2.webp
