isystemsautomation/HOMEMASTER/partner-kit/MiniPLC/images/04-listing-3.webp

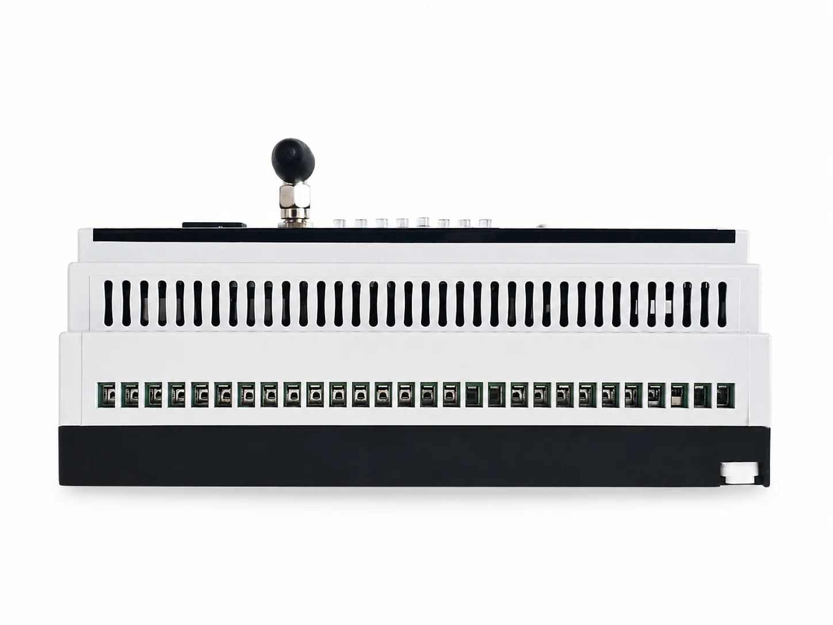
partner-kit/MiniPLC/images/04-listing-3.webp
