isystemsautomation/HOMEMASTER/partner-kit/OpenthermGateway/images/01-main.webp

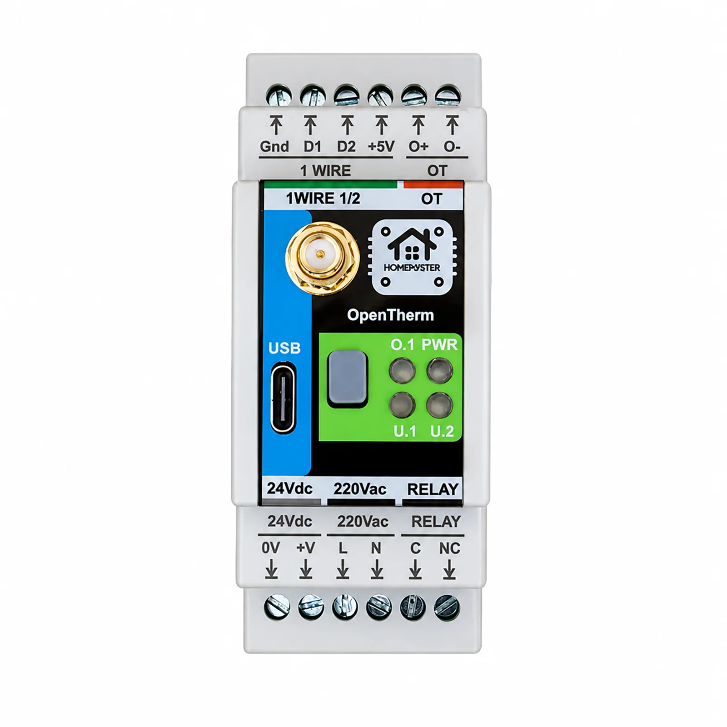
partner-kit/OpenthermGateway/images/01-main.webp
