isystemsautomation/HOMEMASTER/partner-kit/OpenthermGateway/images/02-listing-1.webp

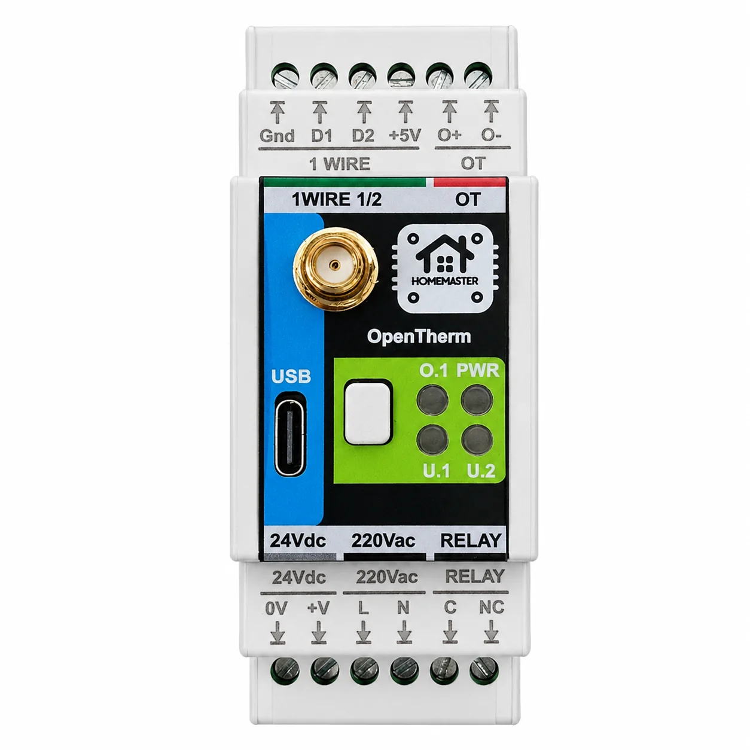
partner-kit/OpenthermGateway/images/02-listing-1.webp
