isystemsautomation/HOMEMASTER/partner-kit/OpenthermGateway/images/03-listing-2.webp

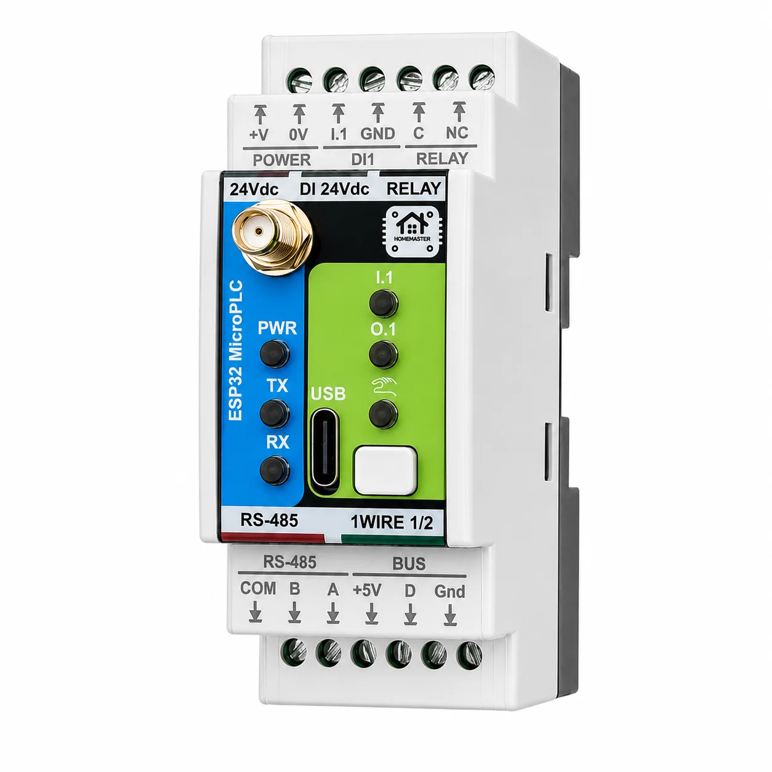
partner-kit/OpenthermGateway/images/03-listing-2.webp
