isystemsautomation/HOMEMASTER/partner-kit/OpenthermGateway/images/04-listing-3.webp

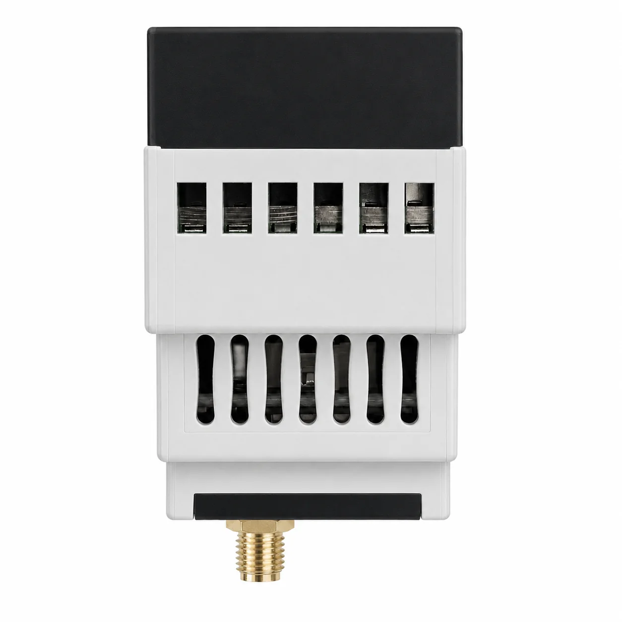
partner-kit/OpenthermGateway/images/04-listing-3.webp
