isystemsautomation/HOMEMASTER/partner-kit/RGB-621-R1/images/01-main.webp

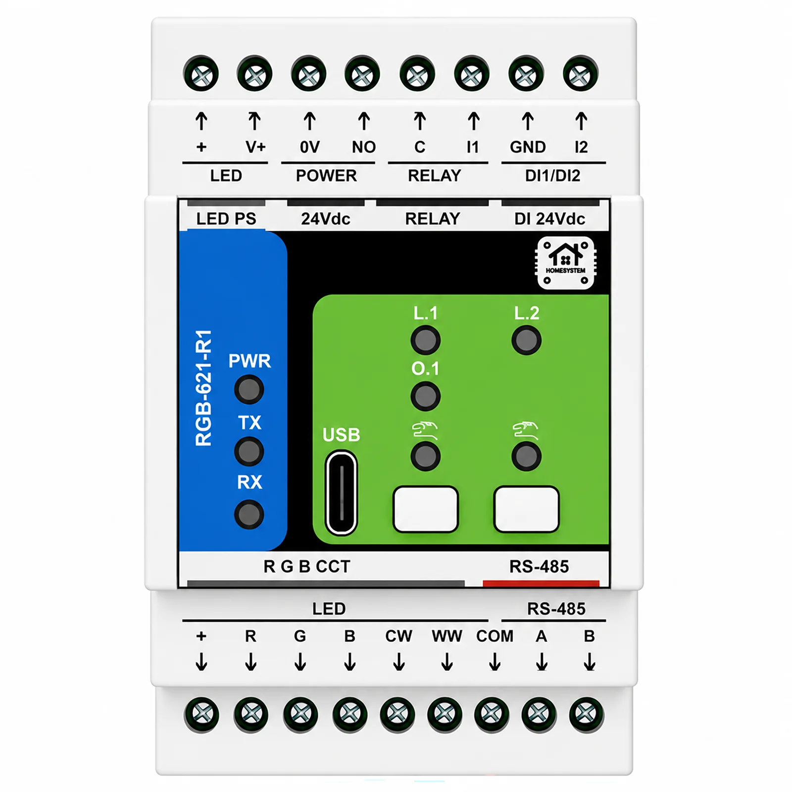
partner-kit/RGB-621-R1/images/01-main.webp
