isystemsautomation/HOMEMASTER/partner-kit/RGB-621-R1/images/06-dimensions.webp

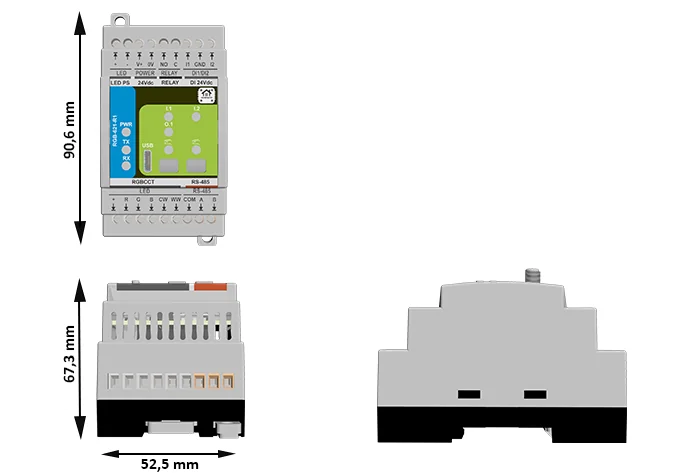
partner-kit/RGB-621-R1/images/06-dimensions.webp
