isystemsautomation/HOMEMASTER/partner-kit/STR-3221-R1/images/02-listing-1.webp

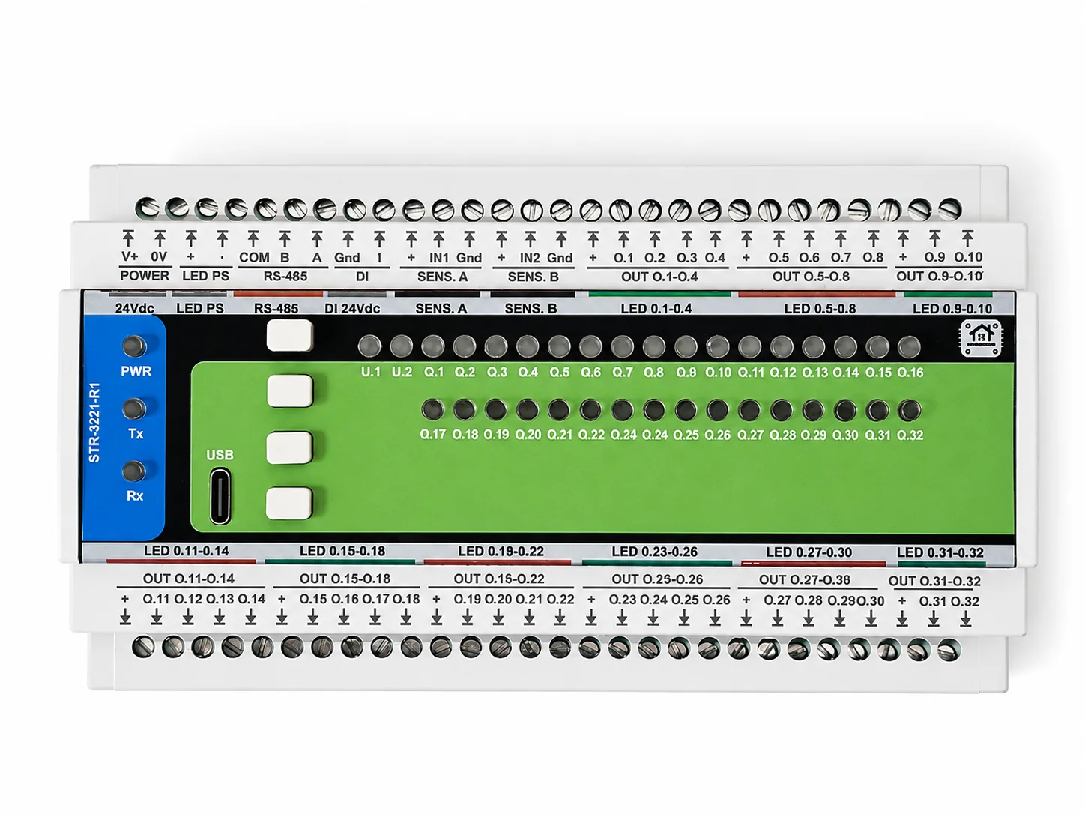
partner-kit/STR-3221-R1/images/02-listing-1.webp
