isystemsautomation/HOMEMASTER/partner-kit/STR-3221-R1/images/03-listing-2.webp

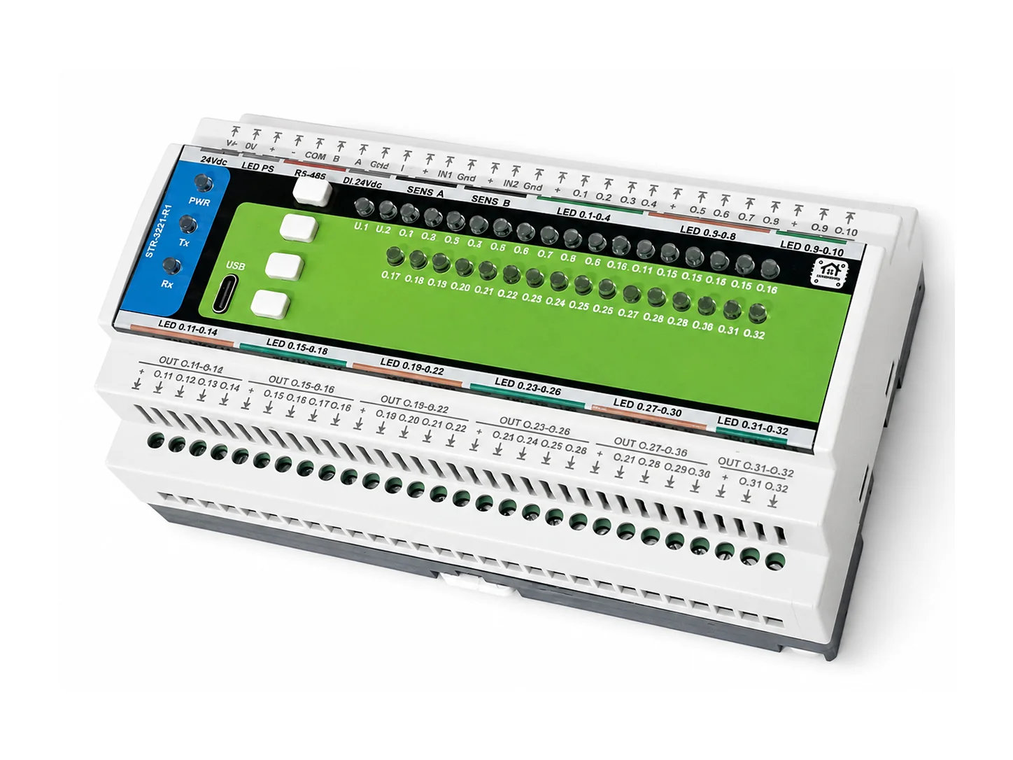
partner-kit/STR-3221-R1/images/03-listing-2.webp
