isystemsautomation/HOMEMASTER/partner-kit/STR-3221-R1/images/04-listing-3.webp

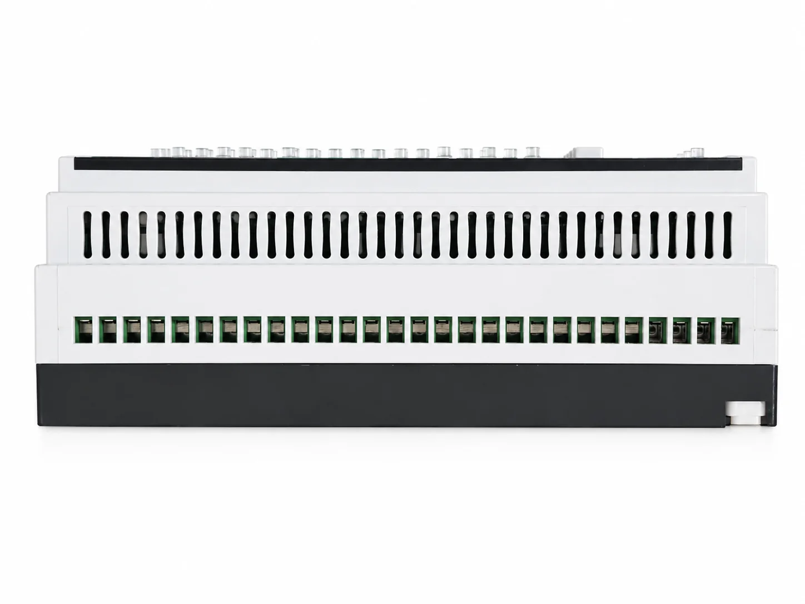
partner-kit/STR-3221-R1/images/04-listing-3.webp
