isystemsautomation/HOMEMASTER/partner-kit/STR-3221-R1/images/06-dimensions.webp

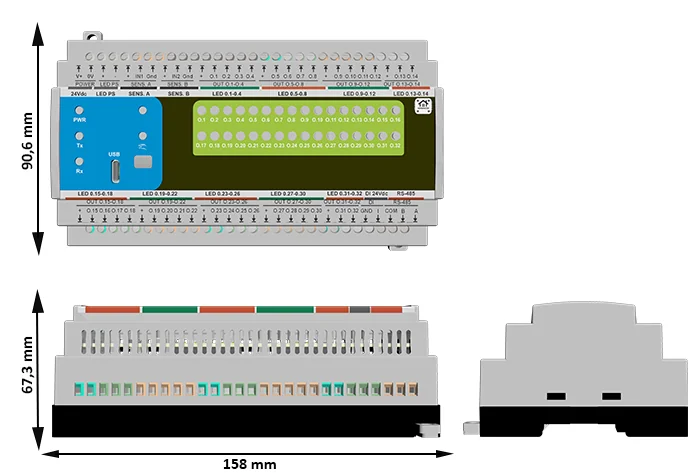
partner-kit/STR-3221-R1/images/06-dimensions.webp
