isystemsautomation/HOMEMASTER/partner-kit/WLD-521-R1/images/02-listing-1.webp

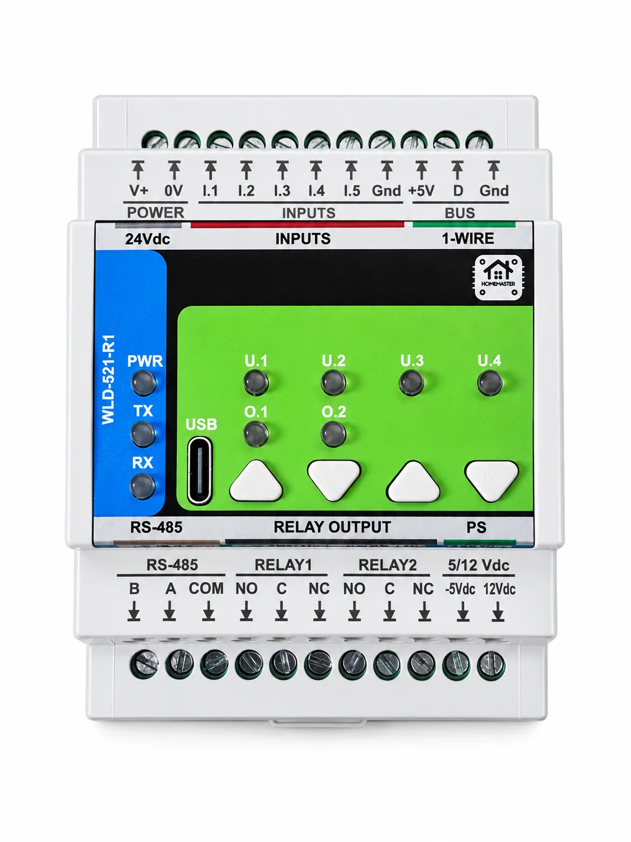
partner-kit/WLD-521-R1/images/02-listing-1.webp
