isystemsautomation/HOMEMASTER/partner-kit/WLD-521-R1/images/05-package.webp

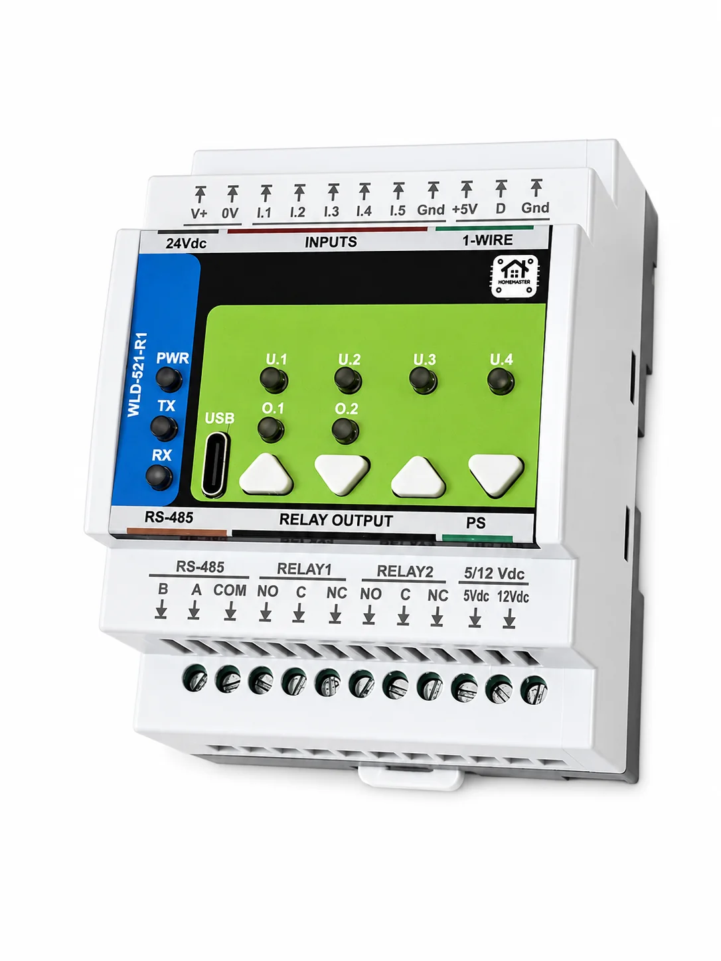
partner-kit/WLD-521-R1/images/05-package.webp
