isystemsautomation/HOMEMASTER/partner-kit/WLD-521-R1/images/07-block-diagram.webp

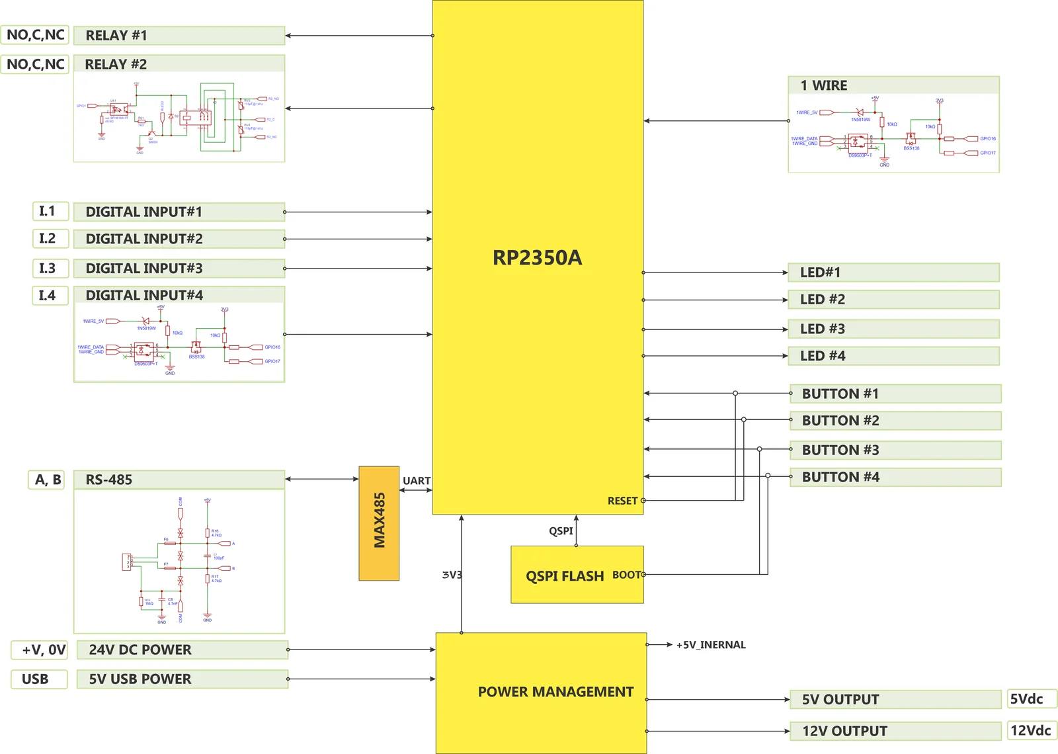
partner-kit/WLD-521-R1/images/07-block-diagram.webp
