isystemsautomation/HOMEMASTER/STR-3221-R1/Images/photo3.png

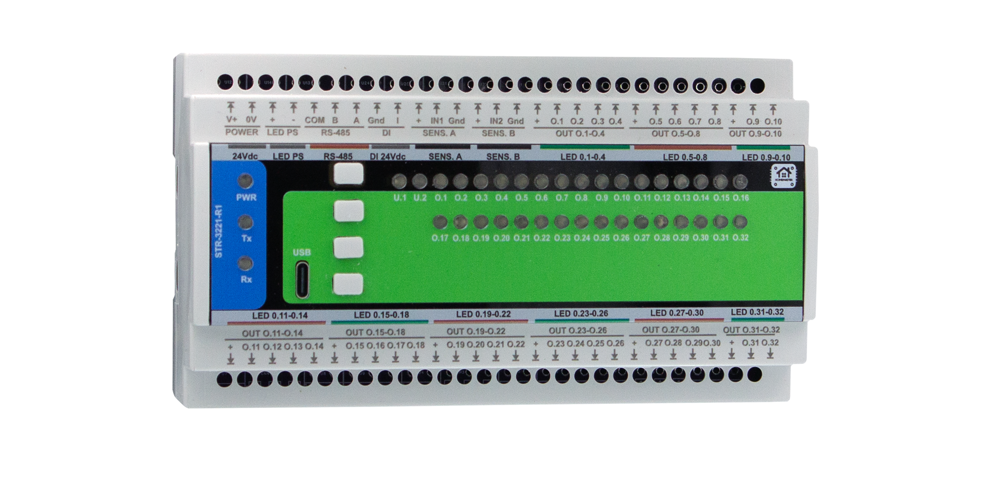
STR-3221-R1/Images/photo3.png
