isystemsautomation/HOMEMASTER/STR-3221-R1/Images/photo4.jpg

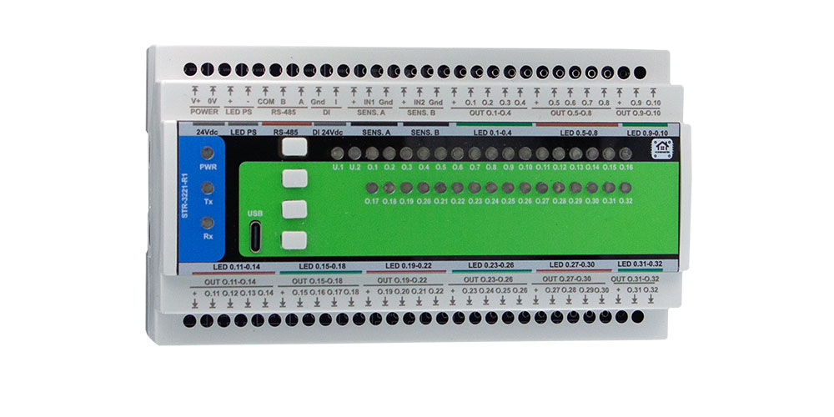
STR-3221-R1/Images/photo4.jpg
