isystemsautomation/HOMEMASTER/WLD-521-R1/Images/buttons1.png

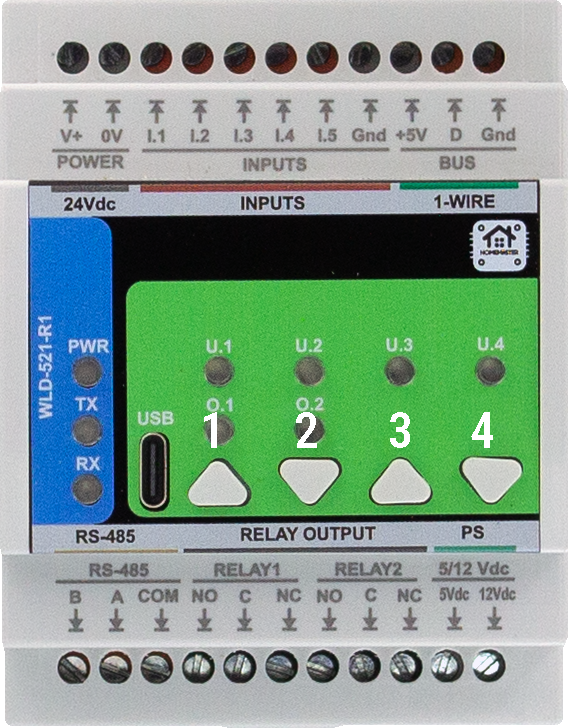
WLD-521-R1/Images/buttons1.png
