isystemsautomation/HOMEMASTER/WLD-521-R1/Images/photo3.png

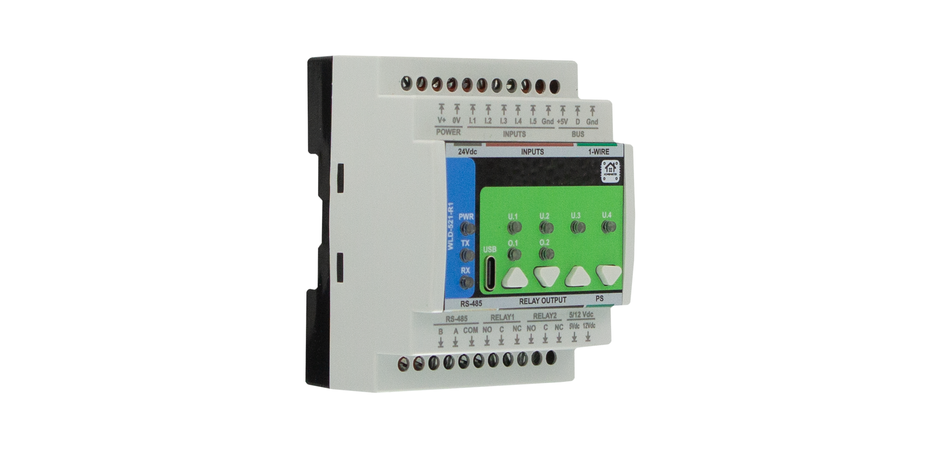
WLD-521-R1/Images/photo3.png
