isystemsautomation/HOMEMASTER/WLD-521-R1/Images/webconfig2.png

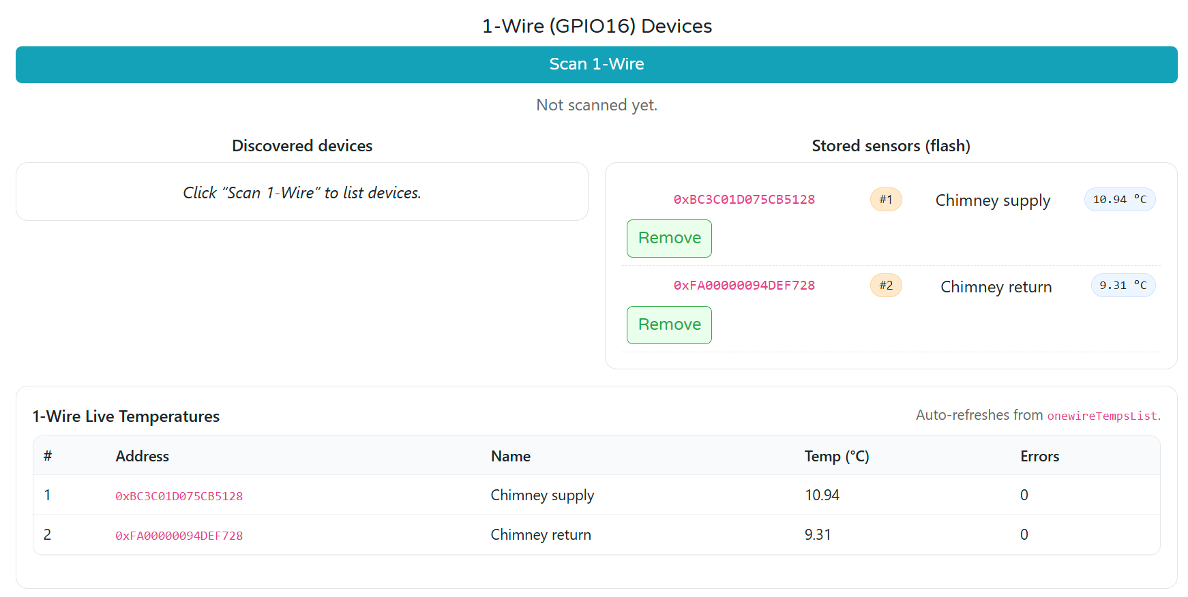
WLD-521-R1/Images/webconfig2.png
