isystemsautomation/HOMEMASTER/WLD-521-R1/Images/webconfig7.png

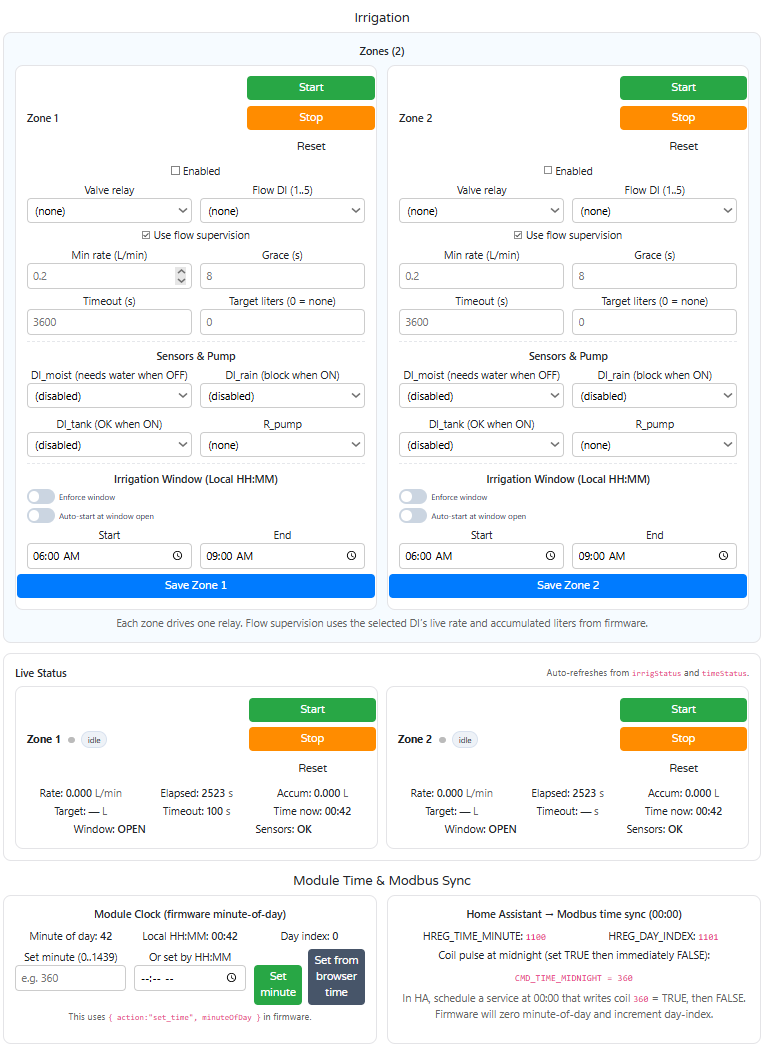
WLD-521-R1/Images/webconfig7.png
