isystemsautomation/HOMEMASTER/WLD-521-R1/Images/WLD_1WireConnection.png

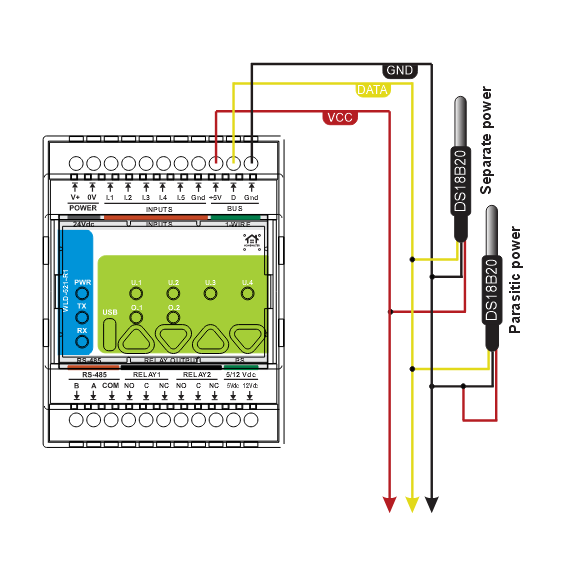
WLD-521-R1/Images/WLD_1WireConnection.png
