isystemsautomation/HOMEMASTER/WLD-521-R1/Images/WLD_24Vdc.png

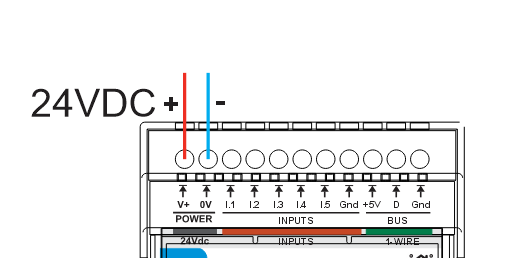
WLD-521-R1/Images/WLD_24Vdc.png
