isystemsautomation/HOMEMASTER/WLD-521-R1/Images/WLD_FlowmeterConnection.png

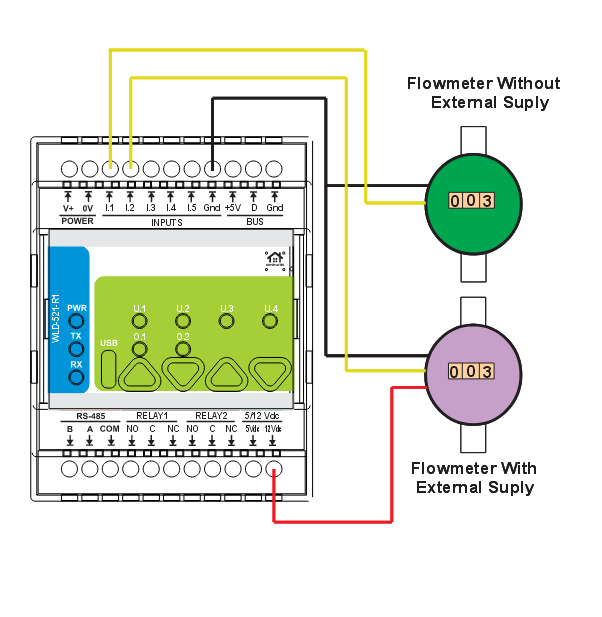
WLD-521-R1/Images/WLD_FlowmeterConnection.png
