isystemsautomation/HOMEMASTER/WLD-521-R1/Images/WLD_RelayConnections.png

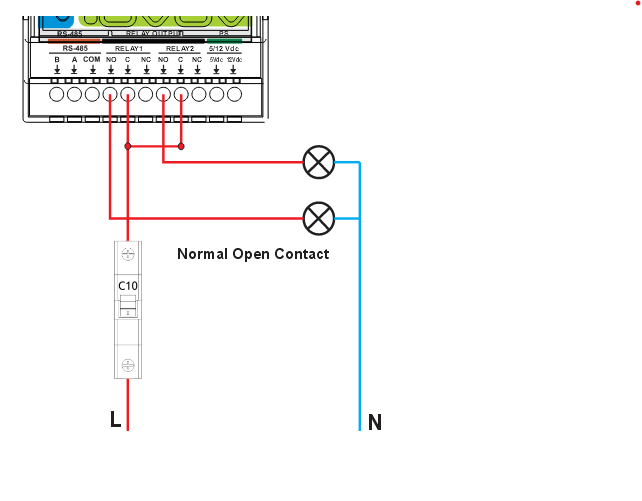
WLD-521-R1/Images/WLD_RelayConnections.png
