isystemsautomation/HOMEMASTER/MicroPLC/Images/wiring_1wire2.png

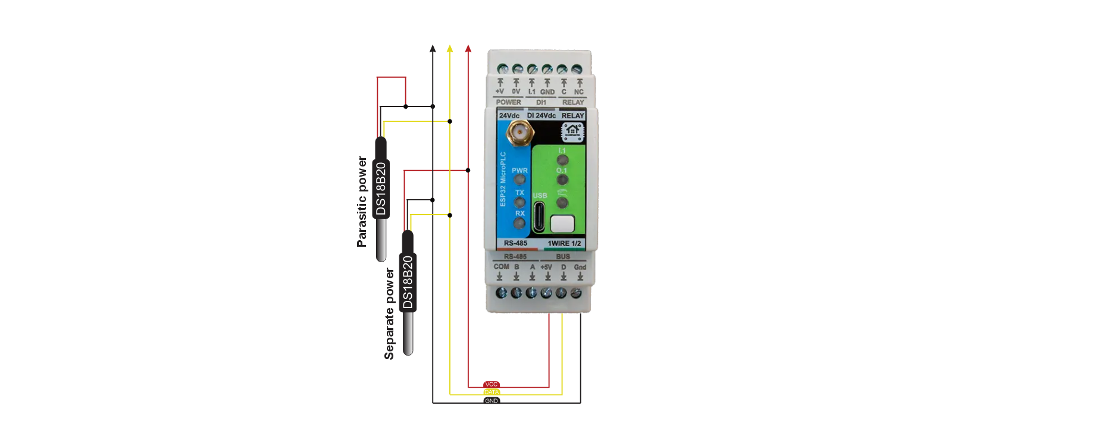
MicroPLC/Images/wiring_1wire2.png
