isystemsautomation/HOMEMASTER/MicroPLC/Images/wiring_relays1.png

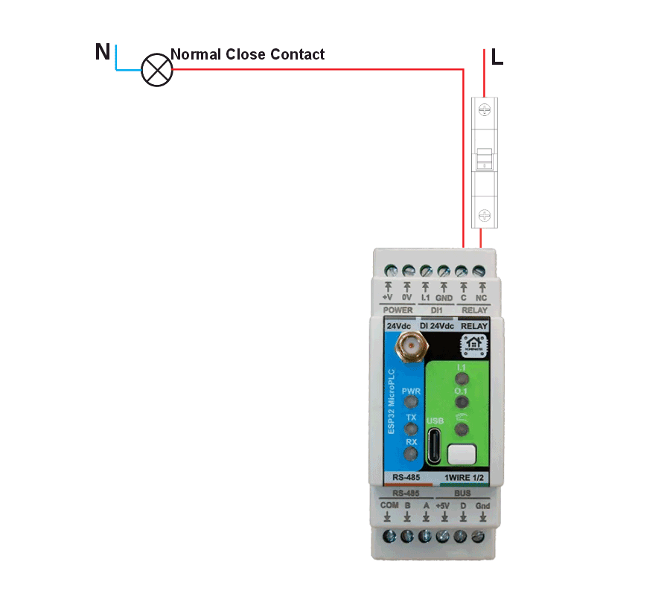
MicroPLC/Images/wiring_relays1.png
