isystemsautomation/HOMEMASTER/MicroPLC/Images/wiring_rs485_1.png

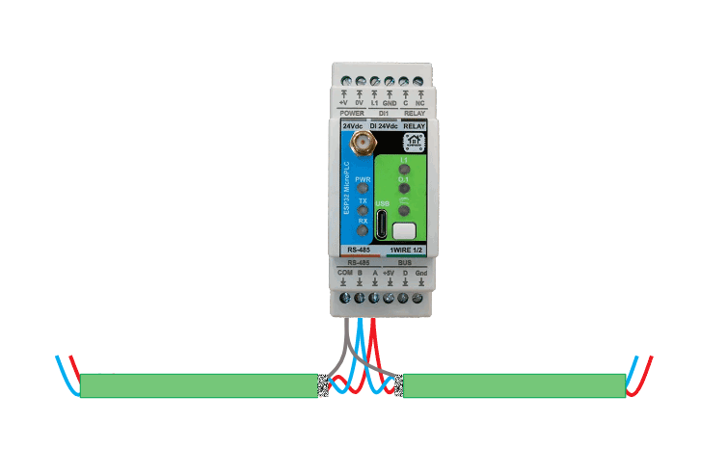
MicroPLC/Images/wiring_rs485_1.png
