isystemsautomation/HOMEMASTER/MicroPLC/Images/wiring_rs485_2.png

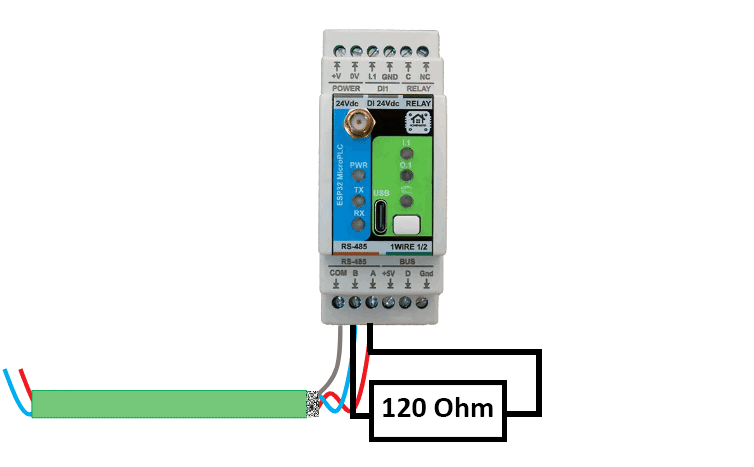
MicroPLC/Images/wiring_rs485_2.png
