isystemsautomation/HOMEMASTER/MiniPLC/Images/wiring_1wire1.png

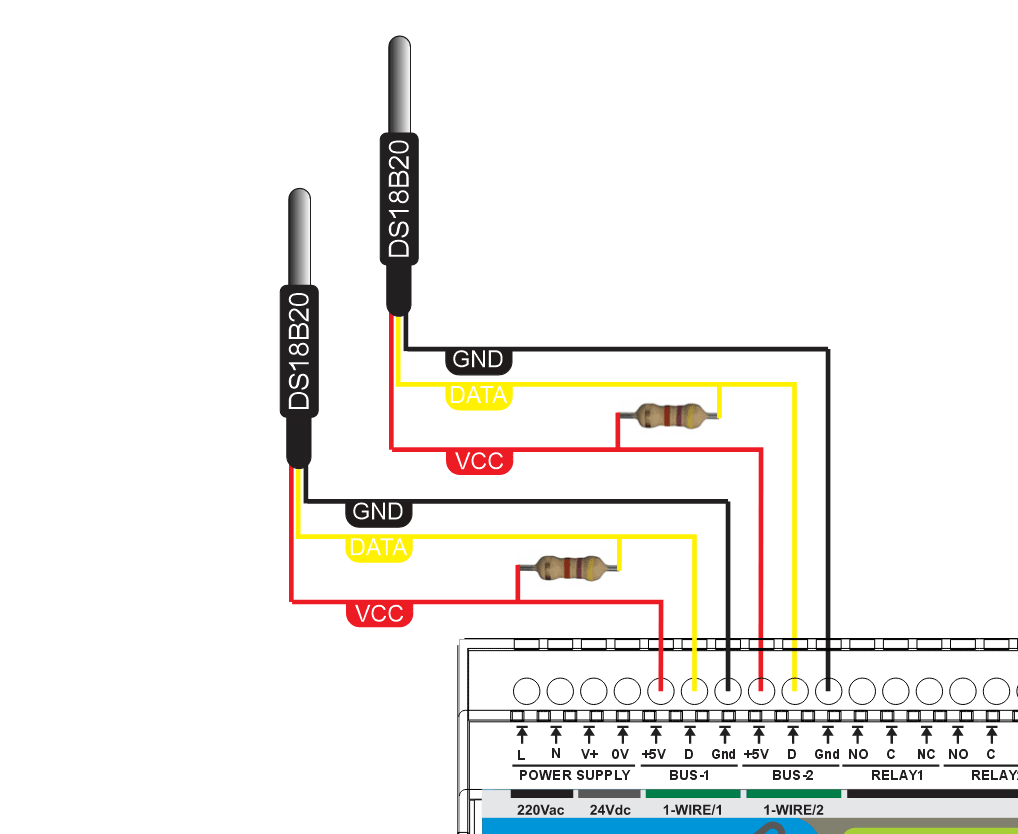
MiniPLC/Images/wiring_1wire1.png
