isystemsautomation/HOMEMASTER/WLD-521-R1/Images/WLD_FloodmeterWiringConnections.png

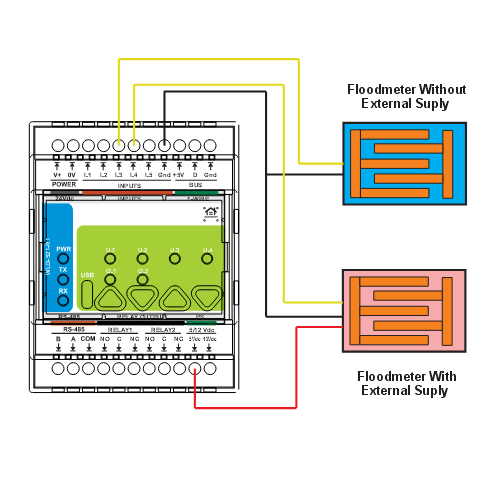
WLD-521-R1/Images/WLD_FloodmeterWiringConnections.png
