isystemsautomation/HOMEMASTER/partner-kit/CHANGELOG.md

# Partner kit changelog

## 2026.09

- Initial public partner kit: eleven HomeMaster modules.
- Product descriptions, specification tables, WebP images, EU DoC and datasheets.
- Download archive: `homemaster-partner-kit-2026.09.zip`.
