isystemsautomation/HOMEMASTER/AIO-422-R1/Schematics/AIO-422-R1-FieldBoard.pdf

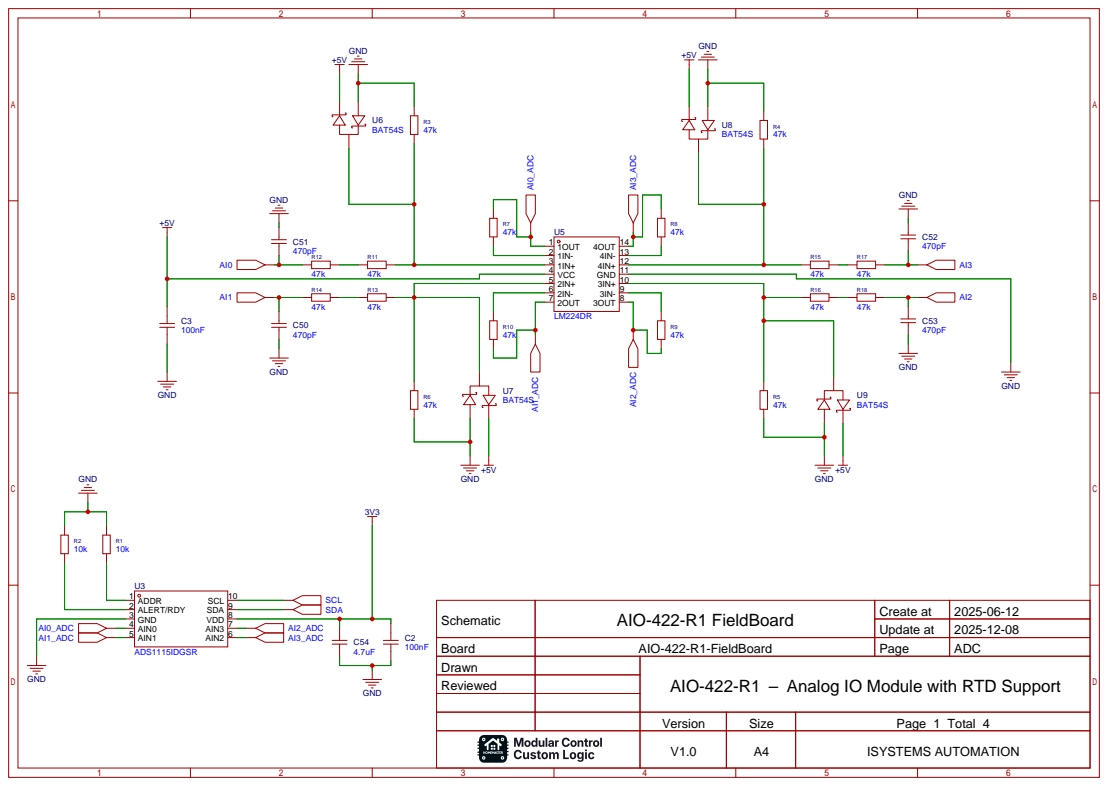
[picture p242: page 1]

Schematic | AIO-422-R1 FieldBoard | Create at | 2025-06-12

Update at | 2025-12-08

Board | AIO-422-R1-FieldBoard | Page | ADC
Drawn | | AIO-422-R1 Analog IO Module with RTD Support
Reviewed

Version | Size | Page 1 Total 4
V1.0 | A4 | ISYSTEMS AUTOMATION

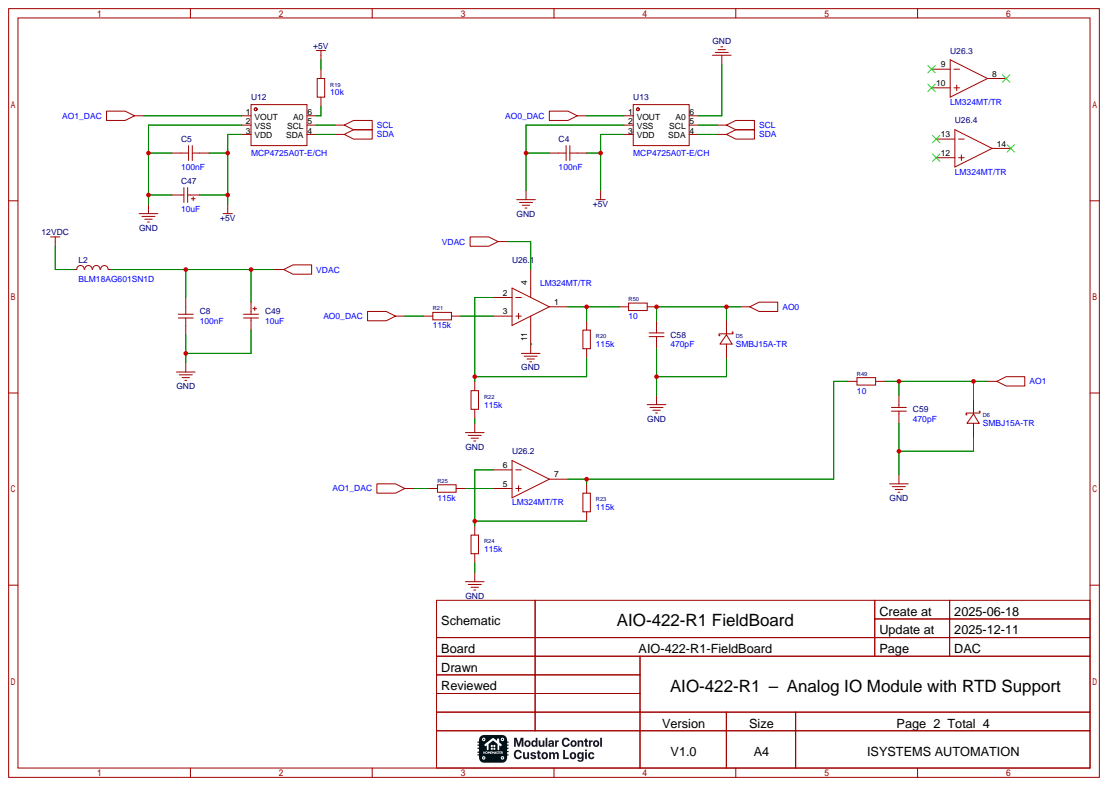
[picture p243: page 2]

Schematic | AIO-422-R1 FieldBoard | Create at | 2025-06-18

Update at | 2025-12-11

Board | AIO-422-R1-FieldBoard | Page | DAC
Drawn | | AIO-422-R1 Analog IO Module with RTD Support
Reviewed

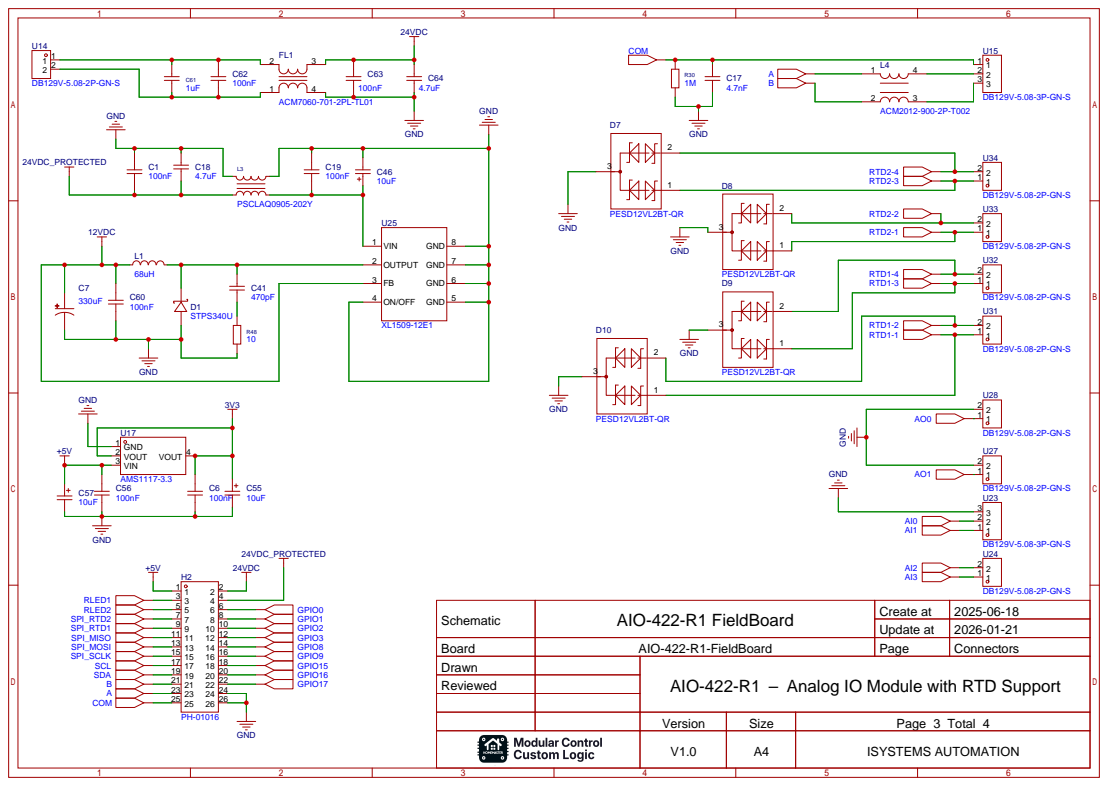
[picture p244: page 3]

Schematic | AIO-422-R1 FieldBoard | Create at | 2025-06-18

Update at | 2026-01-21

Board | AIO-422-R1-FieldBoard | Page | Connectors
Drawn | | AIO-422-R1 Analog IO Module with RTD Support
Reviewed

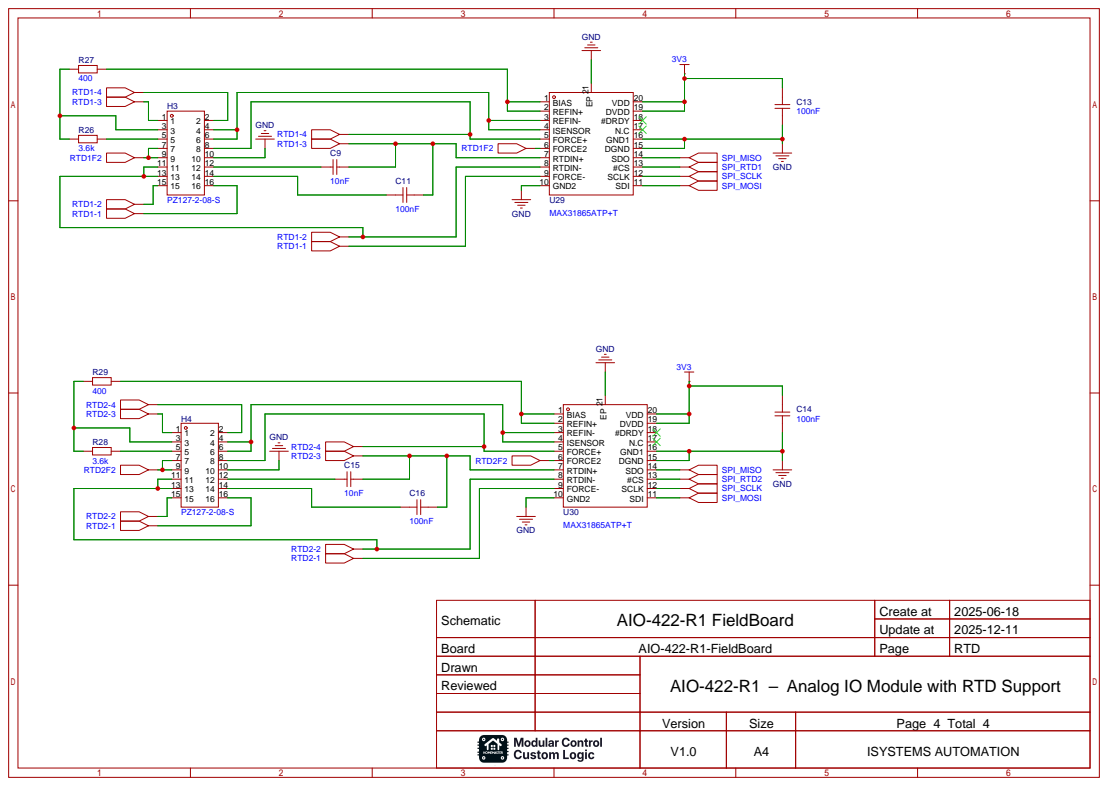
[picture p245: page 4]

Schematic | AIO-422-R1 FieldBoard | Create at | 2025-06-18

Update at | 2025-12-11

Board | AIO-422-R1-FieldBoard | Page | RTD
Drawn | | AIO-422-R1 Analog IO Module with RTD Support
Reviewed
