isystemsautomation/HOMEMASTER/AIO-422-R1/Schematics/AIO-422-R1-MCUBoard.pdf

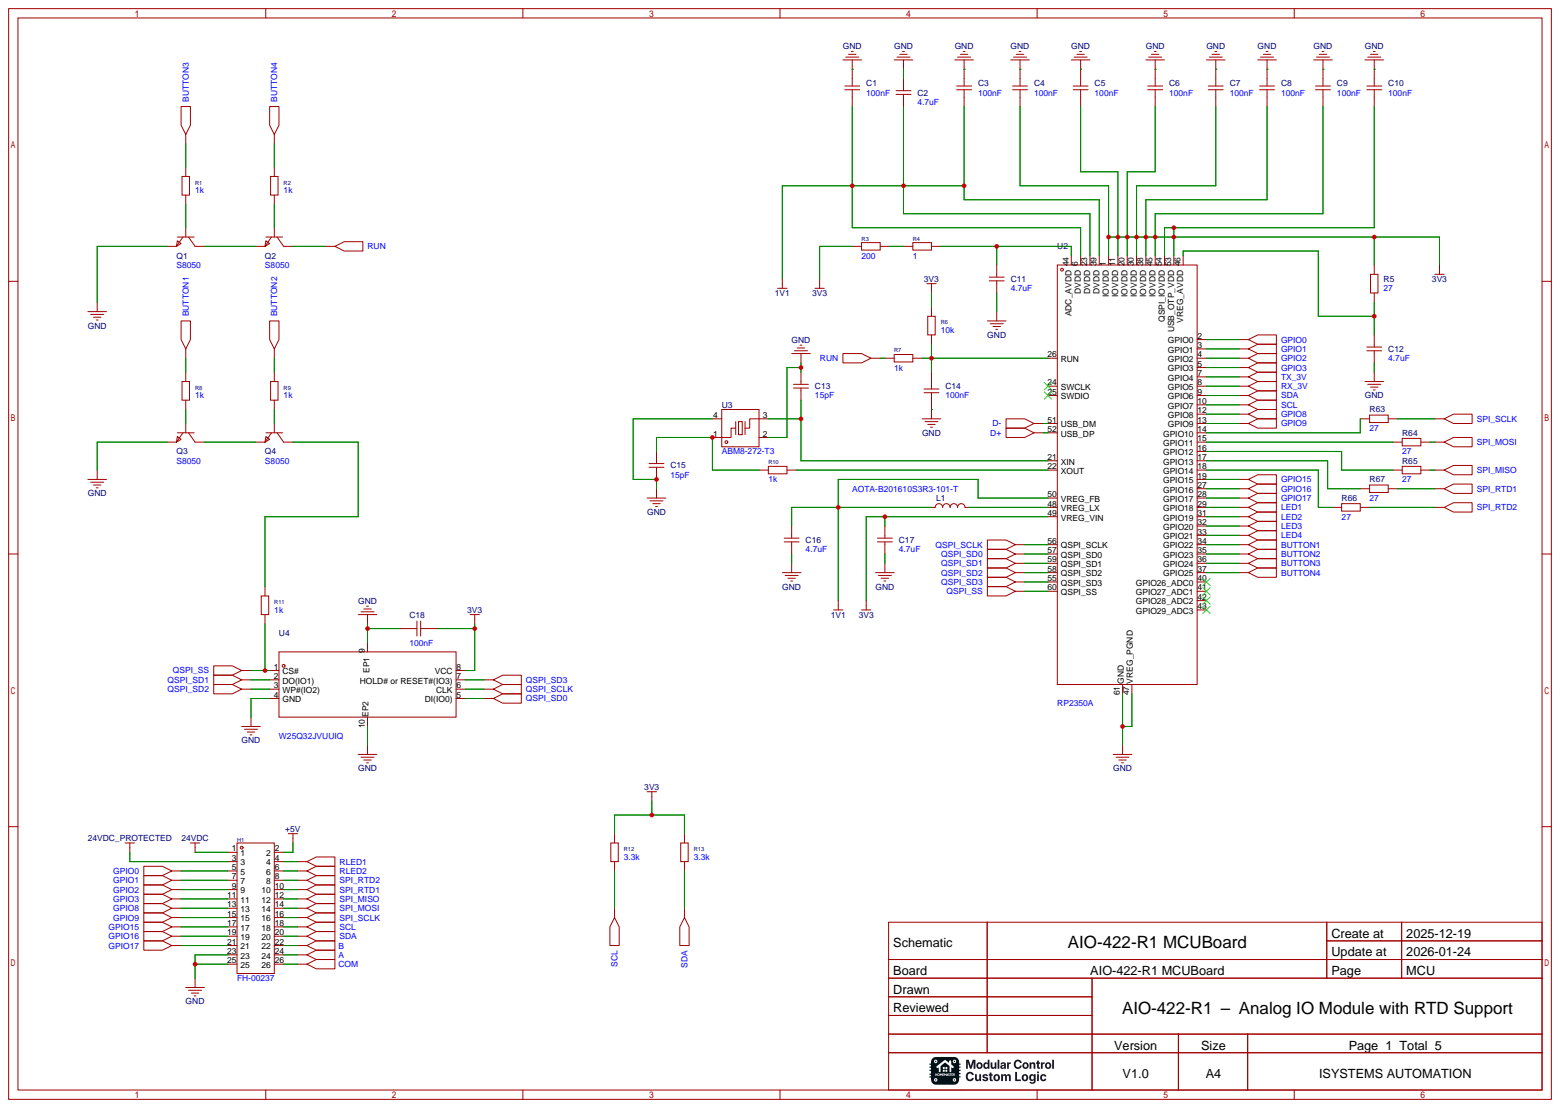
[picture p246: page 1]

Schematic | AIO-422-R1 MCUBoard | Create at | 2025-12-19

Update at | 2026-01-24

Board | AIO-422-R1 MCUBoard | Page | MCU
Drawn | | AIO-422-R1 Analog IO Module with RTD Support
Reviewed

Version | Size | Page 1 Total 5
V1.0 | A4 | ISYSTEMS AUTOMATION

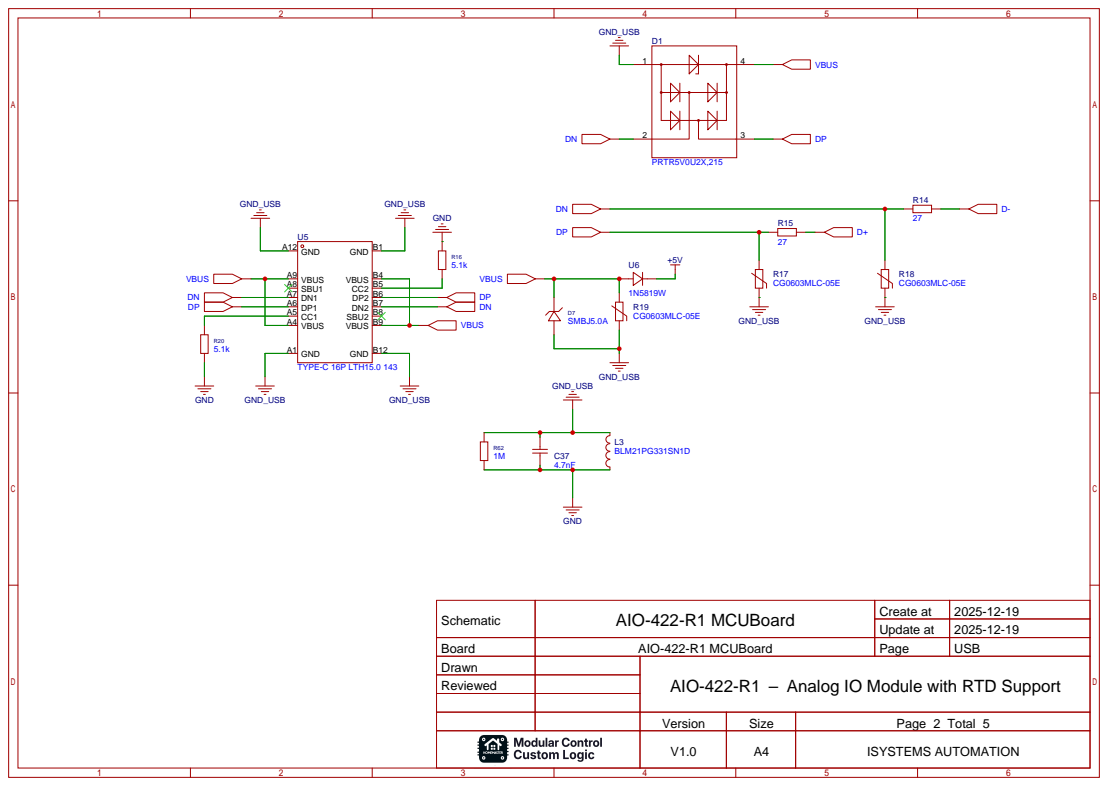
[picture p247: page 2]

Schematic | AIO-422-R1 MCUBoard | Create at | 2025-12-19

Update at | 2025-12-19

Board | AIO-422-R1 MCUBoard | Page | USB
Drawn | | AIO-422-R1 Analog IO Module with RTD Support
Reviewed

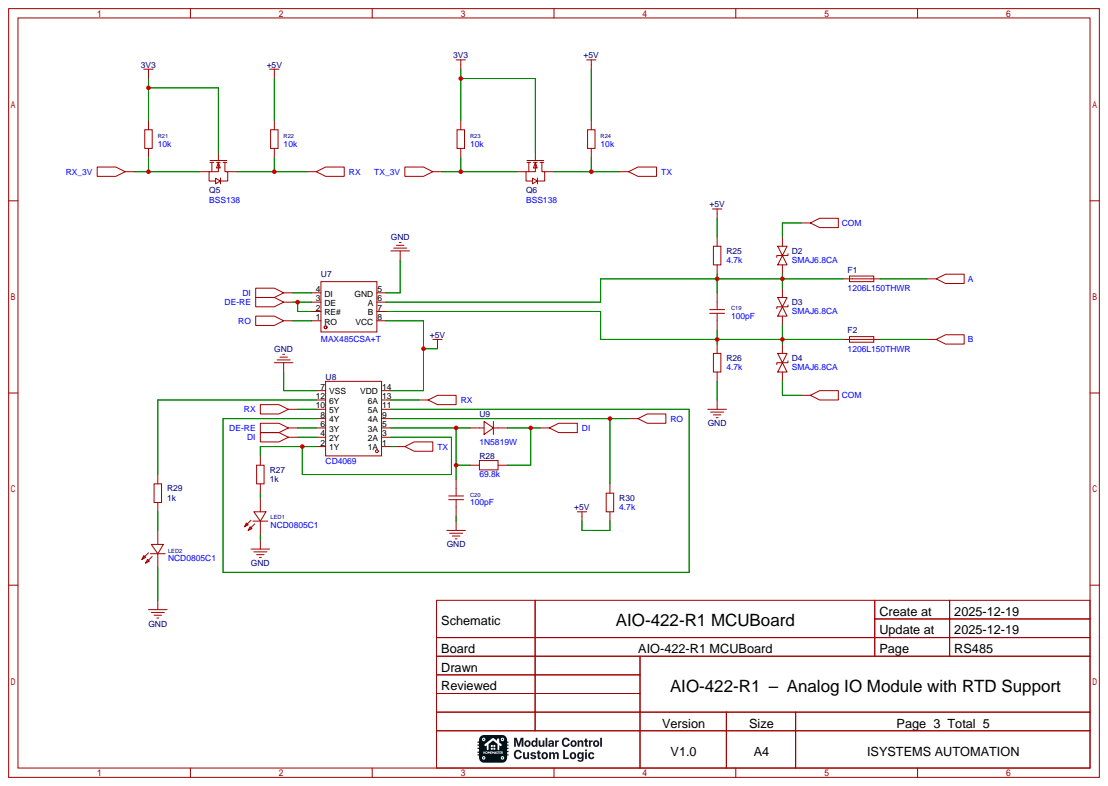
[picture p248: page 3]

Schematic | AIO-422-R1 MCUBoard | Create at | 2025-12-19

Update at | 2025-12-19

Board | AIO-422-R1 MCUBoard | Page | RS485
Drawn | | AIO-422-R1 Analog IO Module with RTD Support
Reviewed

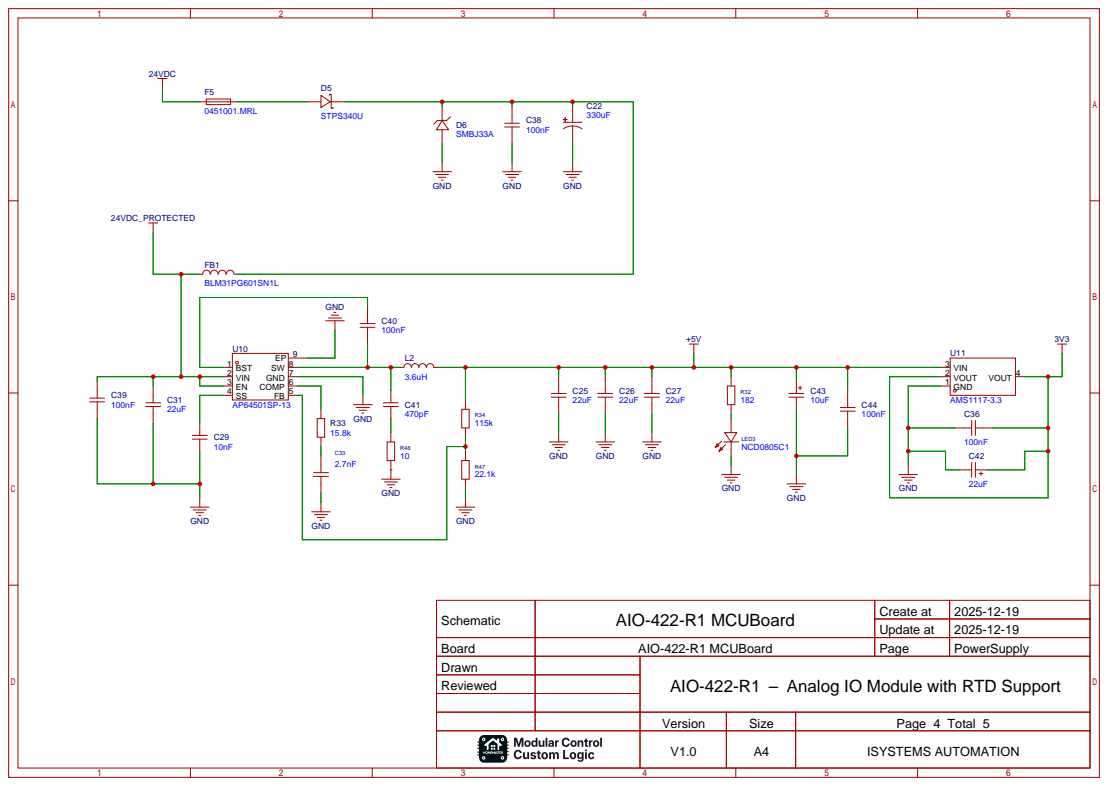
[picture p249: page 4]

Schematic | AIO-422-R1 MCUBoard | Create at | 2025-12-19

Update at | 2025-12-19

Board | AIO-422-R1 MCUBoard | Page | PowerSupply
Drawn | | AIO-422-R1 Analog IO Module with RTD Support
Reviewed

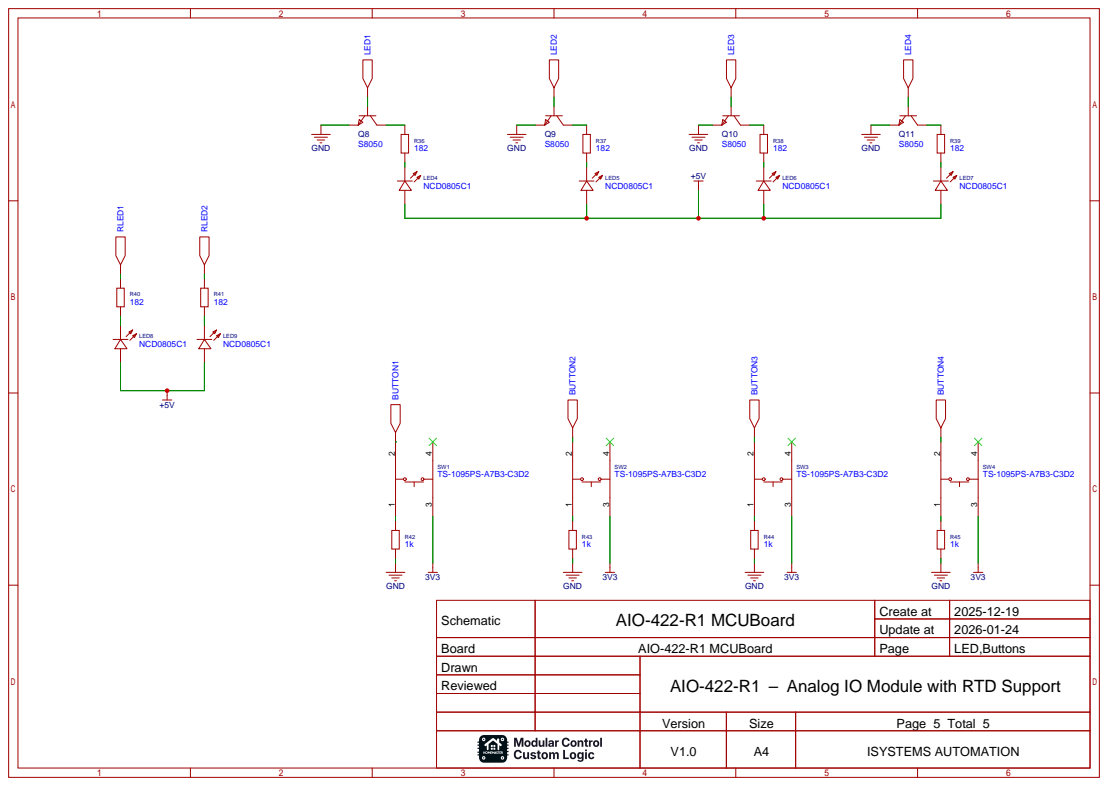
[picture p250: page 5]

Schematic | AIO-422-R1 MCUBoard | Create at | 2025-12-19

Update at | 2026-01-24

Board | AIO-422-R1 MCUBoard | Page | LED,Buttons
Drawn | | AIO-422-R1 Analog IO Module with RTD Support
Reviewed
