isystemsautomation/HOMEMASTER/ALM-173-R1/Schematics/ALM-173-R1-FieldBoard.pdf

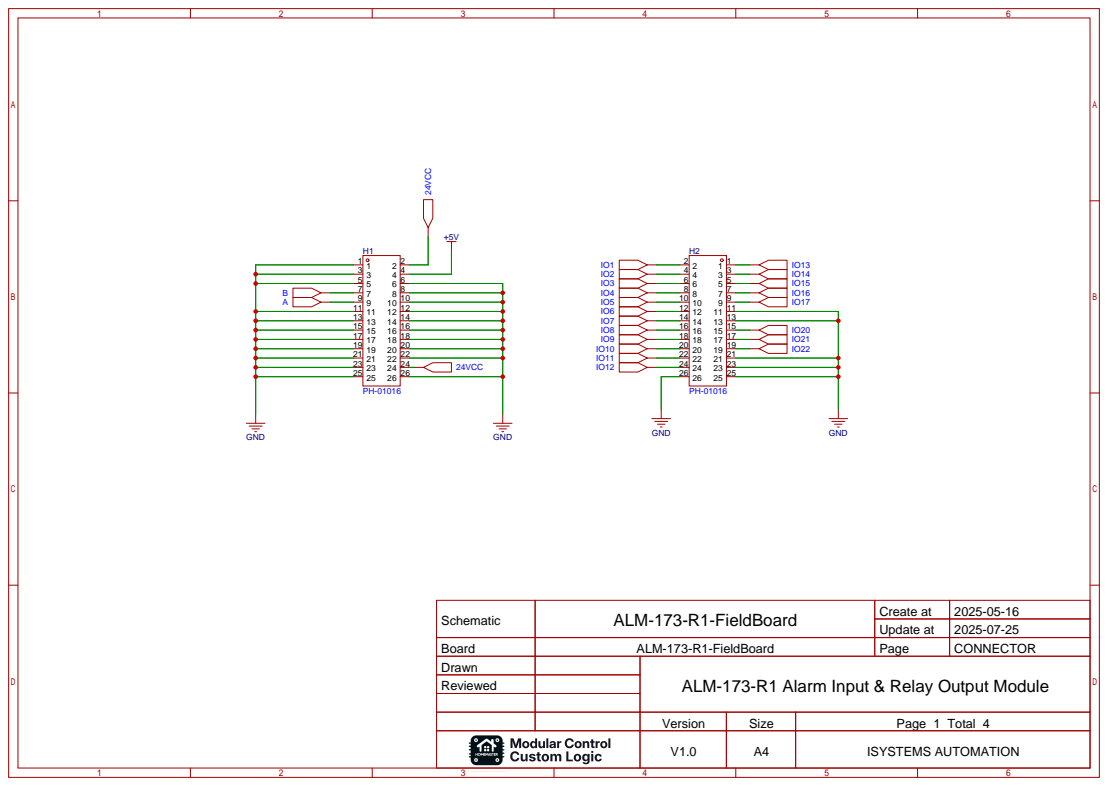
[picture p251: page 1]

Schematic | ALM-173-R1-FieldBoard | Create at | 2025-05-16

Update at | 2025-07-25

Board | ALM-173-R1-FieldBoard | Page | CONNECTOR
Drawn | | ALM-173-R1 Alarm Input & Relay Output Module
Reviewed

Version | Size | Page 1 Total 4
V1.0 | A4 | ISYSTEMS AUTOMATION

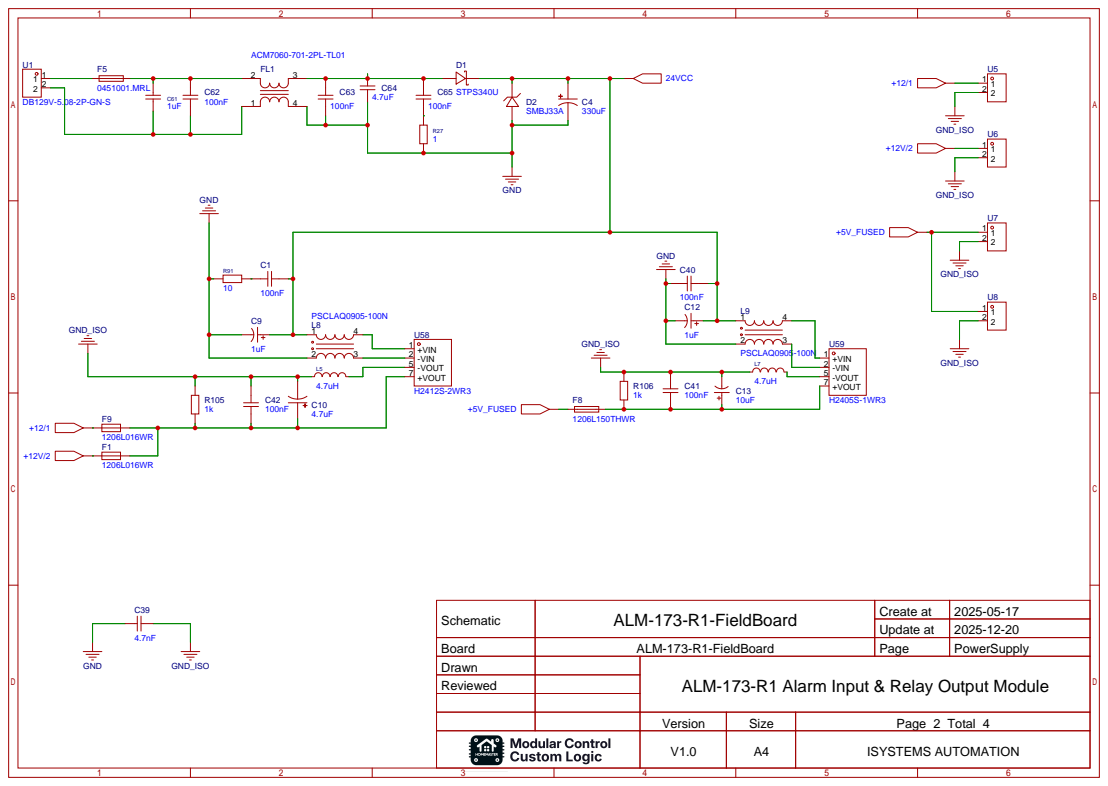
[picture p252: page 2]

Schematic | ALM-173-R1-FieldBoard | Create at | 2025-05-17

Update at | 2025-12-20

Board | ALM-173-R1-FieldBoard | Page | PowerSupply
Drawn | | ALM-173-R1 Alarm Input & Relay Output Module
Reviewed

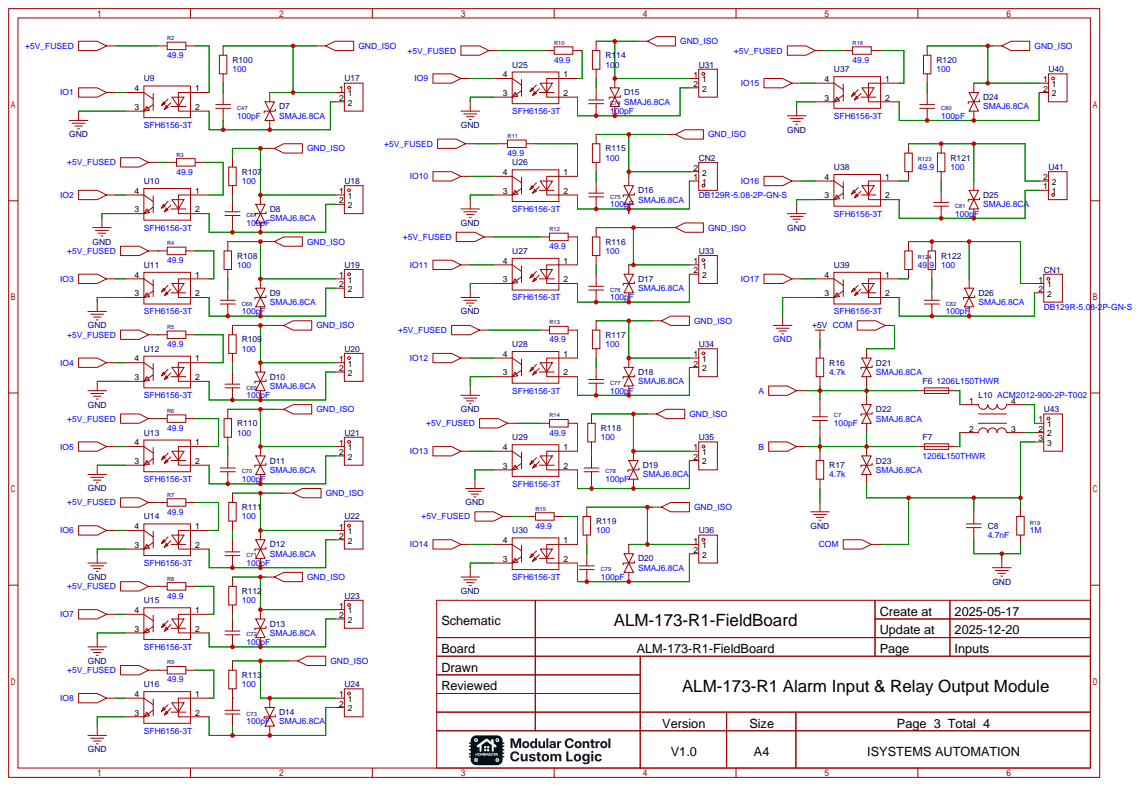
[picture p253: page 3]

Schematic | ALM-173-R1-FieldBoard | Create at | 2025-05-17

Update at | 2025-12-20

Board | ALM-173-R1-FieldBoard | Page | Inputs
Drawn | | ALM-173-R1 Alarm Input & Relay Output Module
Reviewed

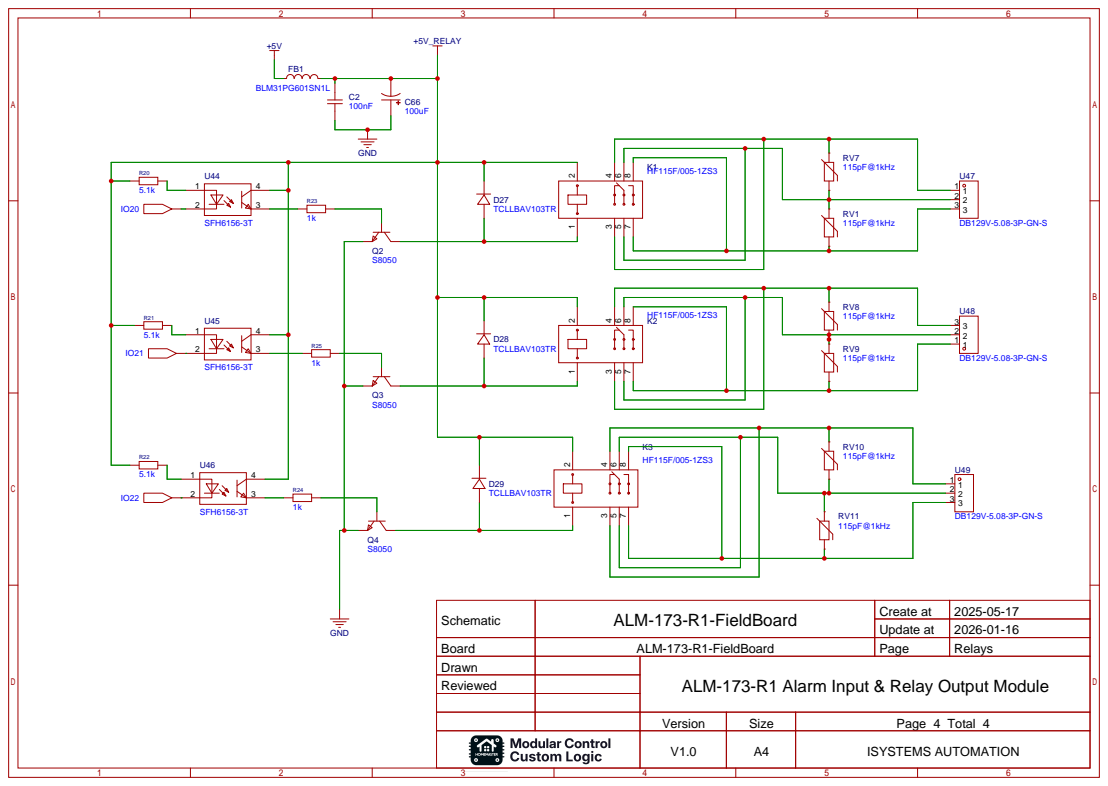
[picture p254: page 4]

Schematic | ALM-173-R1-FieldBoard | Create at | 2025-05-17

Update at | 2026-01-16

Board | ALM-173-R1-FieldBoard | Page | Relays
Drawn | | ALM-173-R1 Alarm Input & Relay Output Module
Reviewed
