isystemsautomation/HOMEMASTER/ALM-173-R1/Schematics/ALM-173-R1-MCUBoard.pdf

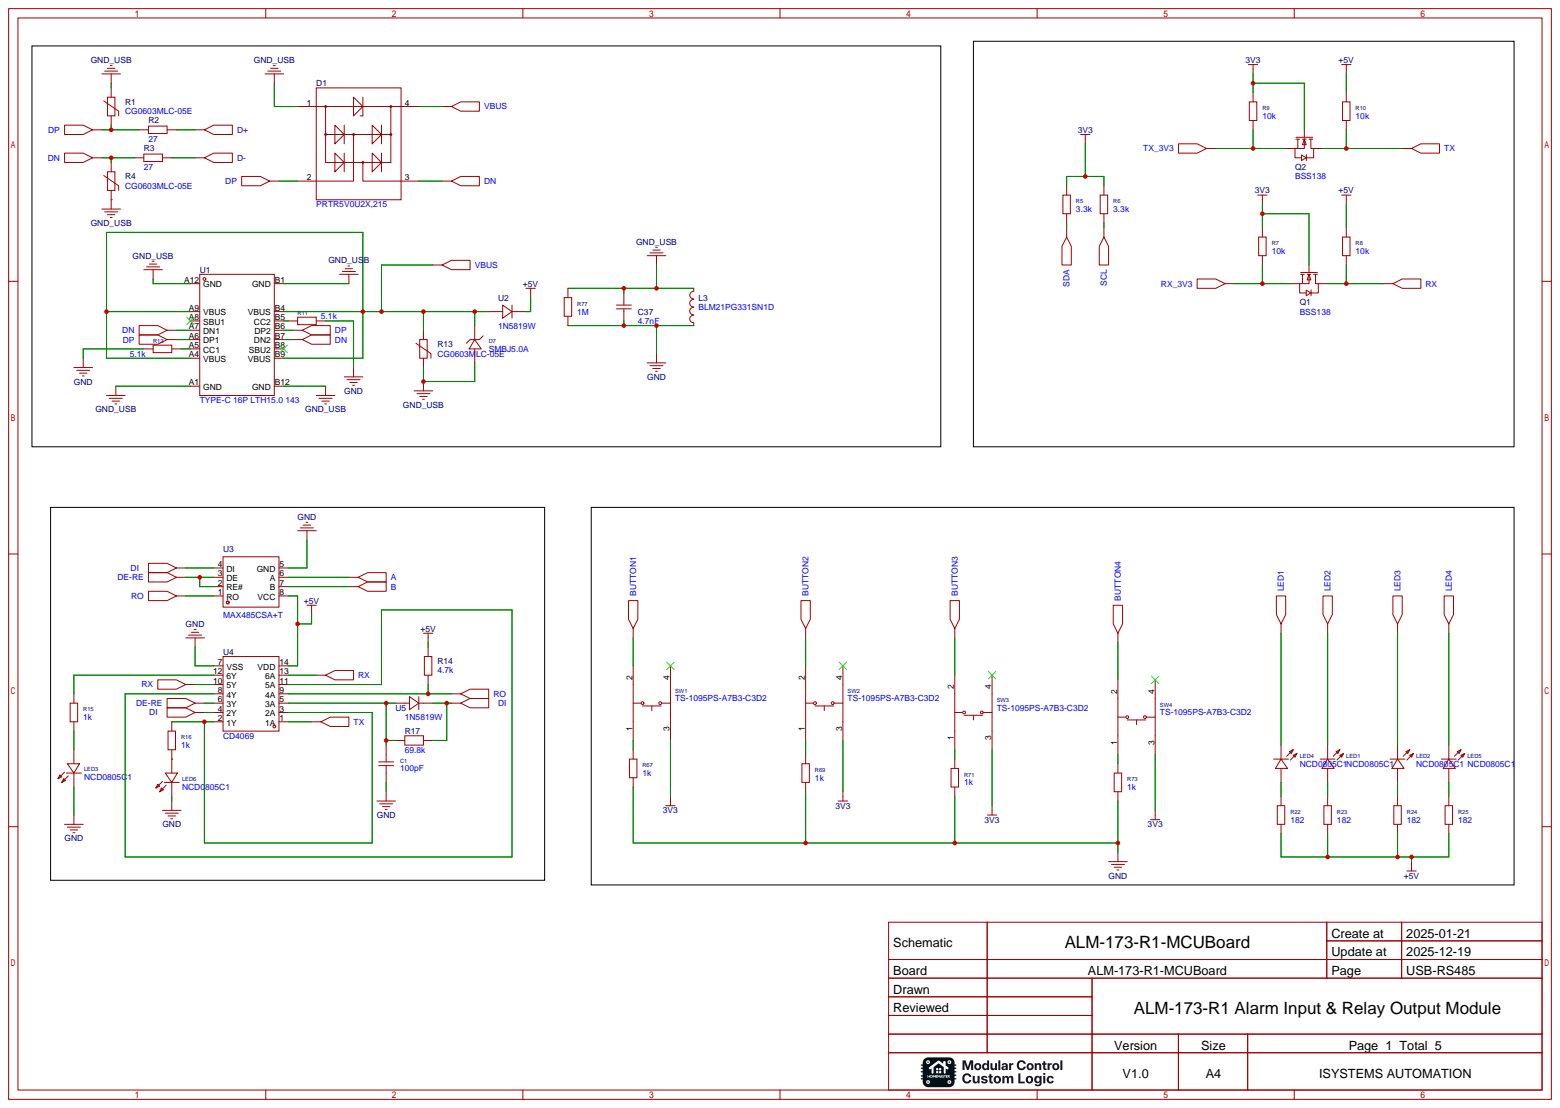
[picture p255: page 1]

Schematic | ALM-173-R1-MCUBoard | Create at | 2025-01-21

Update at | 2025-12-19

Board | ALM-173-R1-MCUBoard | Page | USB-RS485
Drawn | | ALM-173-R1 Alarm Input & Relay Output Module
Reviewed

Version | Size | Page 1 Total 5
V1.0 | A4 | ISYSTEMS AUTOMATION

# S8050 BUTTON³

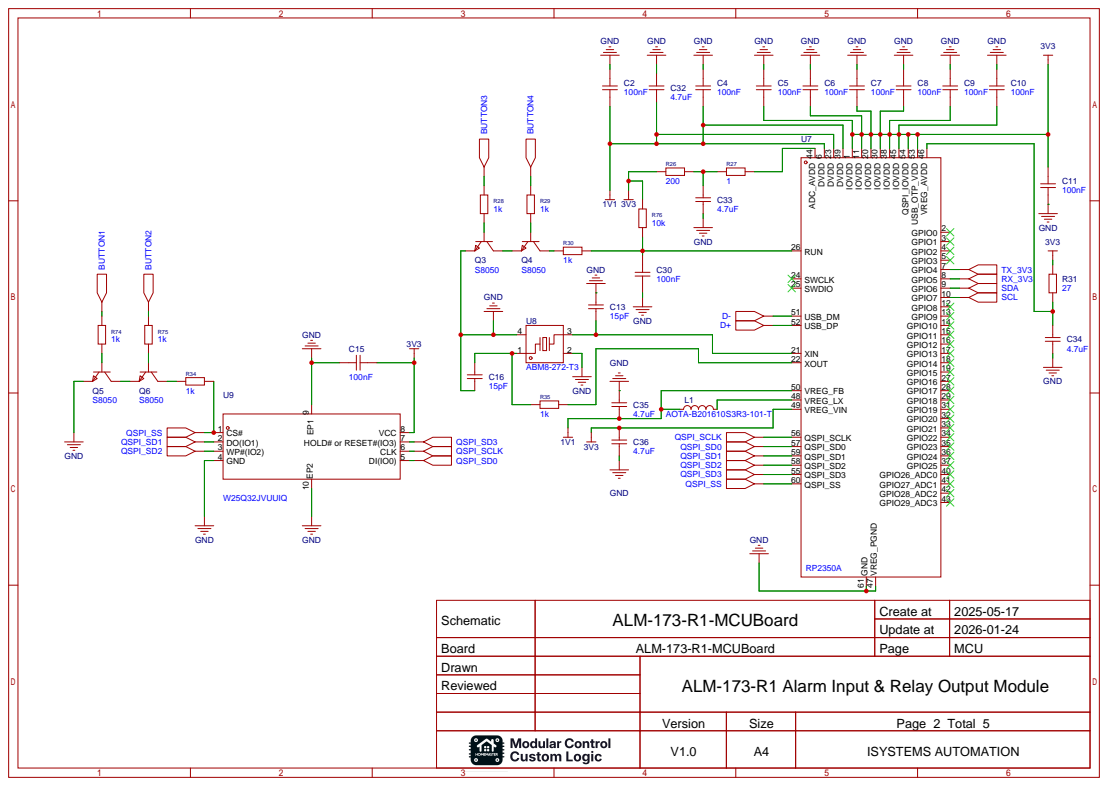
[picture p256: page 2]

Schematic | ALM-173-R1-MCUBoard | Create at | 2025-05-17

Update at | 2026-01-24

Board | ALM-173-R1-MCUBoard | Page | MCU
Drawn | | ALM-173-R1 Alarm Input & Relay Output Module
Reviewed

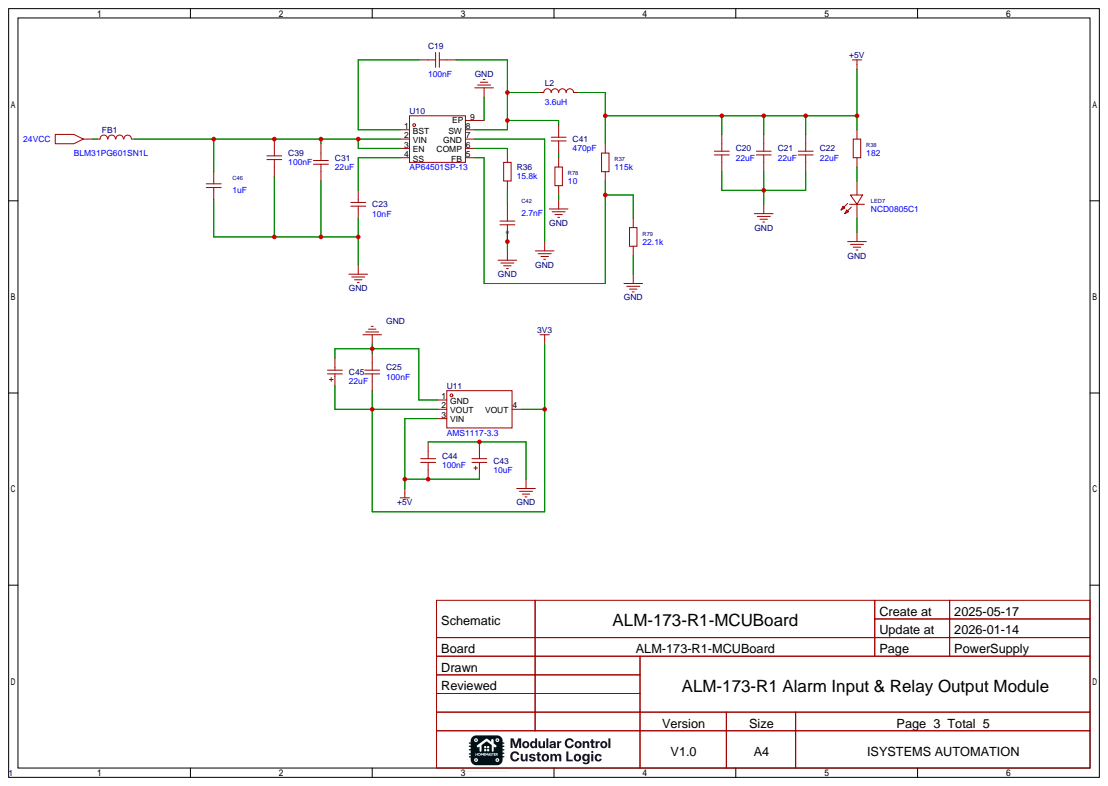
[picture p257: page 3]

Schematic | ALM-173-R1-MCUBoard | Create at | 2025-05-17

Update at | 2026-01-14

Board | ALM-173-R1-MCUBoard | Page | PowerSupply
Drawn | | ALM-173-R1 Alarm Input & Relay Output Module
Reviewed

# P5 10 P6 11 P7 12 INT# 13 SCL 14 SDA 15 VCC 16

# P5 10 P6 11 P7 12 INT# 13 SCL 14 SDA 15 VCC 16

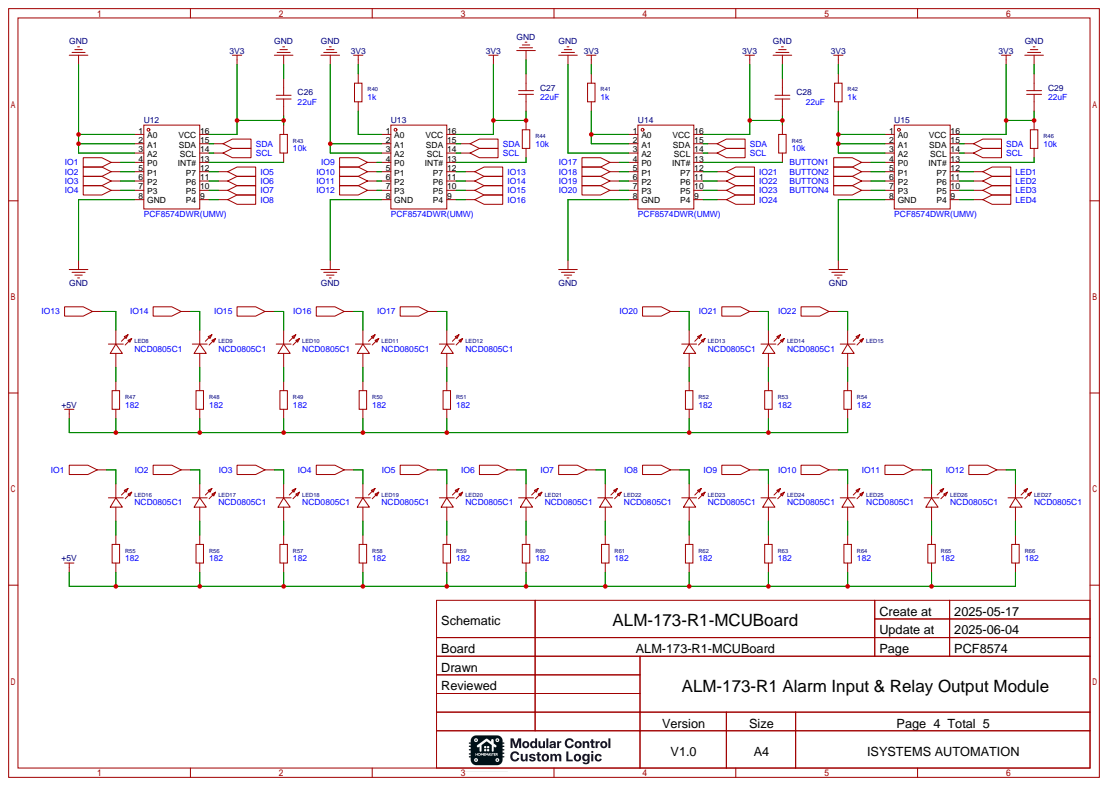
[picture p258: page 4]

Schematic | ALM-173-R1-MCUBoard | Create at | 2025-05-17

Update at | 2025-06-04

Board | ALM-173-R1-MCUBoard | Page | PCF8574
Drawn | | ALM-173-R1 Alarm Input & Relay Output Module
Reviewed

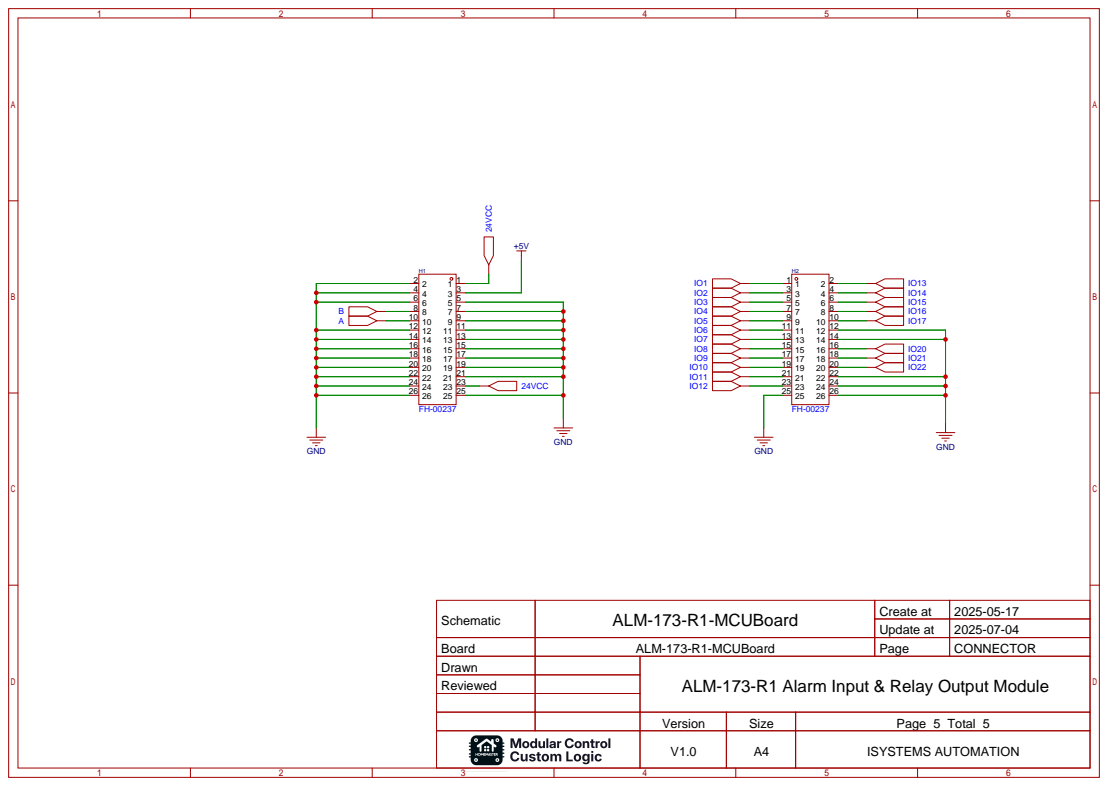
[picture p259: page 5]

Schematic | ALM-173-R1-MCUBoard | Create at | 2025-05-17

Update at | 2025-07-04

Board | ALM-173-R1-MCUBoard | Page | CONNECTOR
Drawn | | ALM-173-R1 Alarm Input & Relay Output Module
Reviewed
