isystemsautomation/HOMEMASTER/DIM-420-R1/Schematics/DIM-420-R1-FieldBoard.pdf

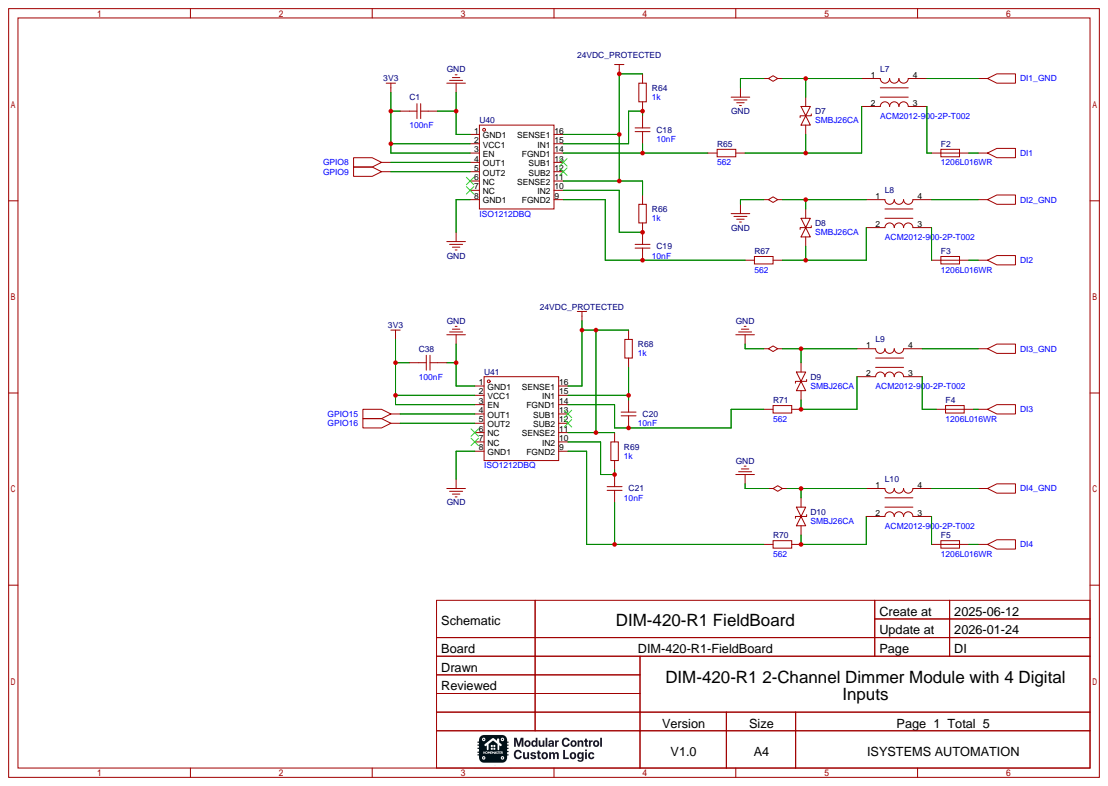
[picture p260: page 1]

Schematic | DIM-420-R1 FieldBoard | Create at | 2025-06-12

Update at | 2026-01-24

Board | DIM-420-R1-FieldBoard | Page | DI
Drawn | | DIM-420-R1 2-Channel Dimmer Module with 4 Digital Inputs Reviewed

Version | Size | Page 1 Total 5
V1.0 | A4 | ISYSTEMS AUTOMATION

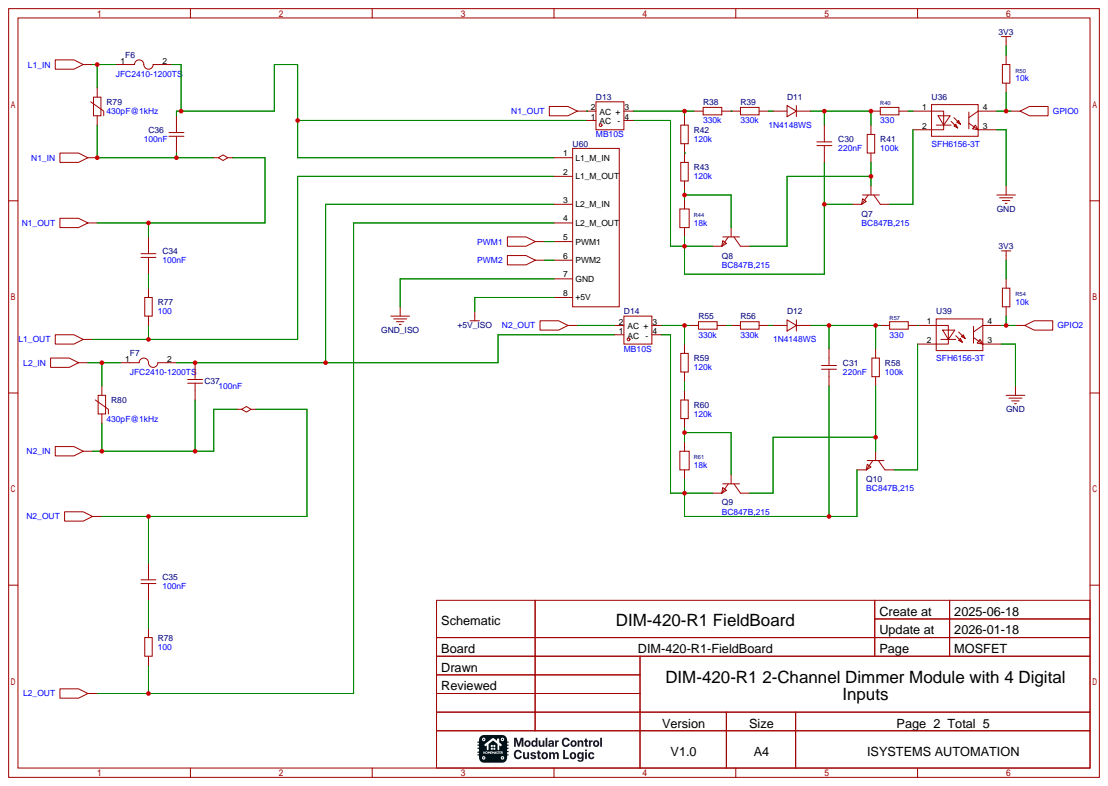
[picture p261: page 2]

Schematic | DIM-420-R1 FieldBoard | Create at | 2025-06-18

Update at | 2026-01-18

Board | DIM-420-R1-FieldBoard | Page | MOSFET
Drawn | | DIM-420-R1 2-Channel Dimmer Module with 4 Digital Inputs Reviewed

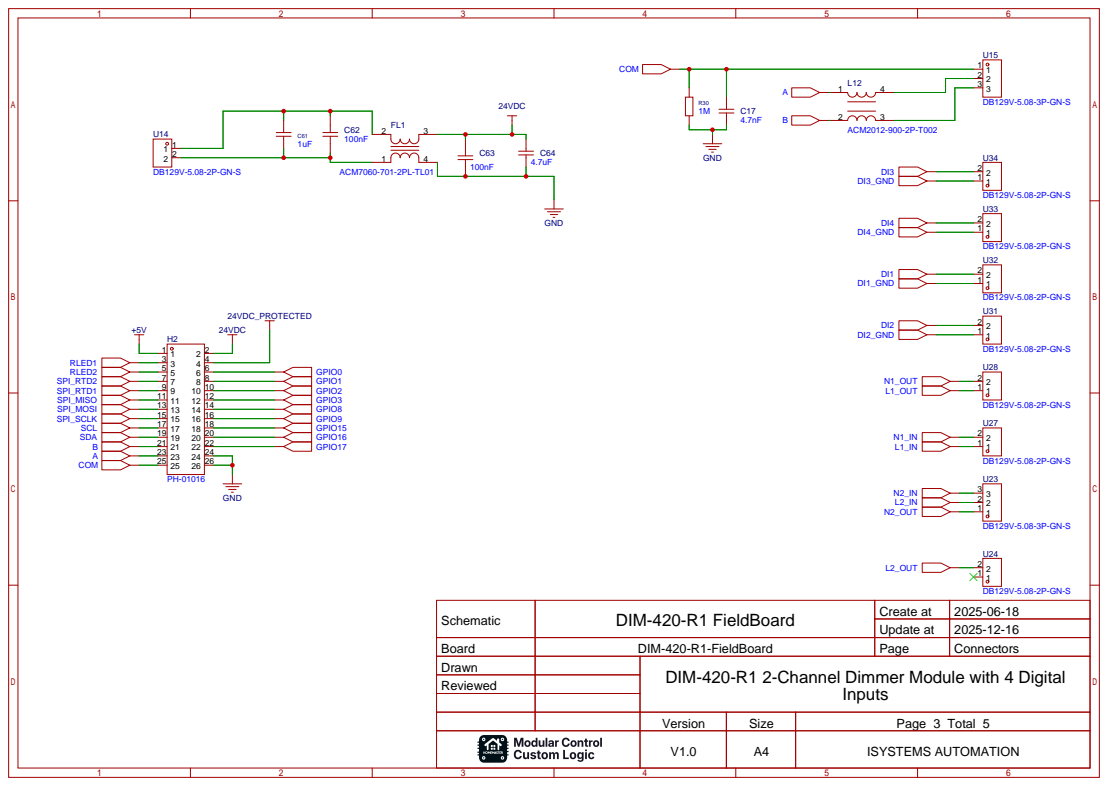
[picture p262: page 3]

Schematic | DIM-420-R1 FieldBoard | Create at | 2025-06-18

Update at | 2025-12-16

Board | DIM-420-R1-FieldBoard | Page | Connectors
Drawn | | DIM-420-R1 2-Channel Dimmer Module with 4 Digital Inputs Reviewed

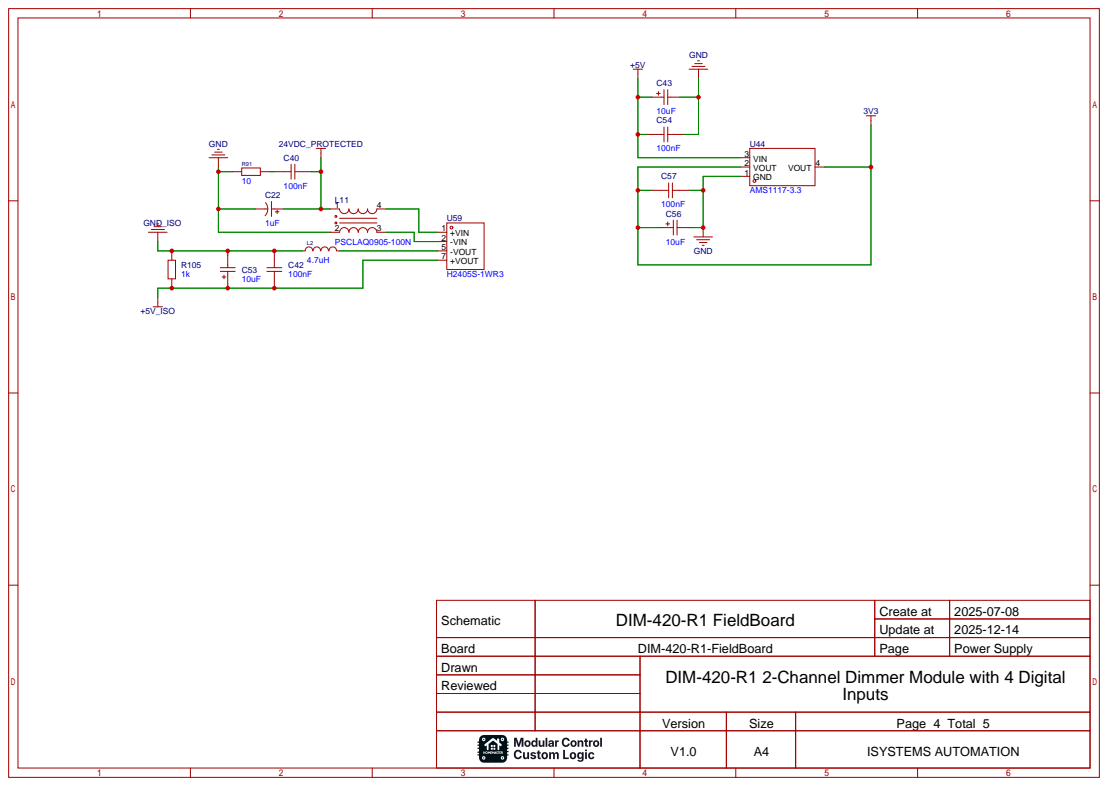
[picture p263: page 4]

Schematic | DIM-420-R1 FieldBoard | Create at | 2025-07-08

Update at | 2025-12-14

Board | DIM-420-R1-FieldBoard | Page | Power Supply
Drawn | | DIM-420-R1 2-Channel Dimmer Module with 4 Digital Inputs Reviewed

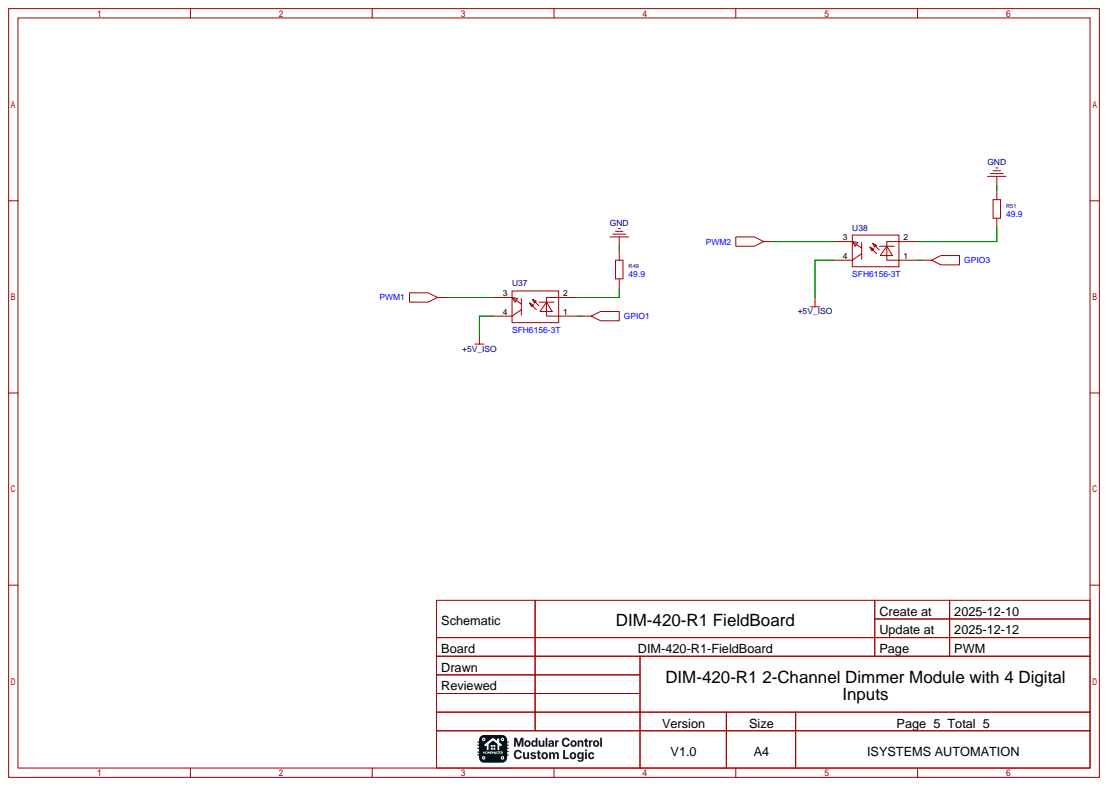
[picture p264: page 5]

Schematic | DIM-420-R1 FieldBoard | Create at | 2025-12-10

Update at | 2025-12-12

Board | DIM-420-R1-FieldBoard | Page | PWM
Drawn | | DIM-420-R1 2-Channel Dimmer Module with 4 Digital Inputs Reviewed
