isystemsautomation/HOMEMASTER/DIM-420-R1/Schematics/DIM-420-R1-MCUBoard.pdf

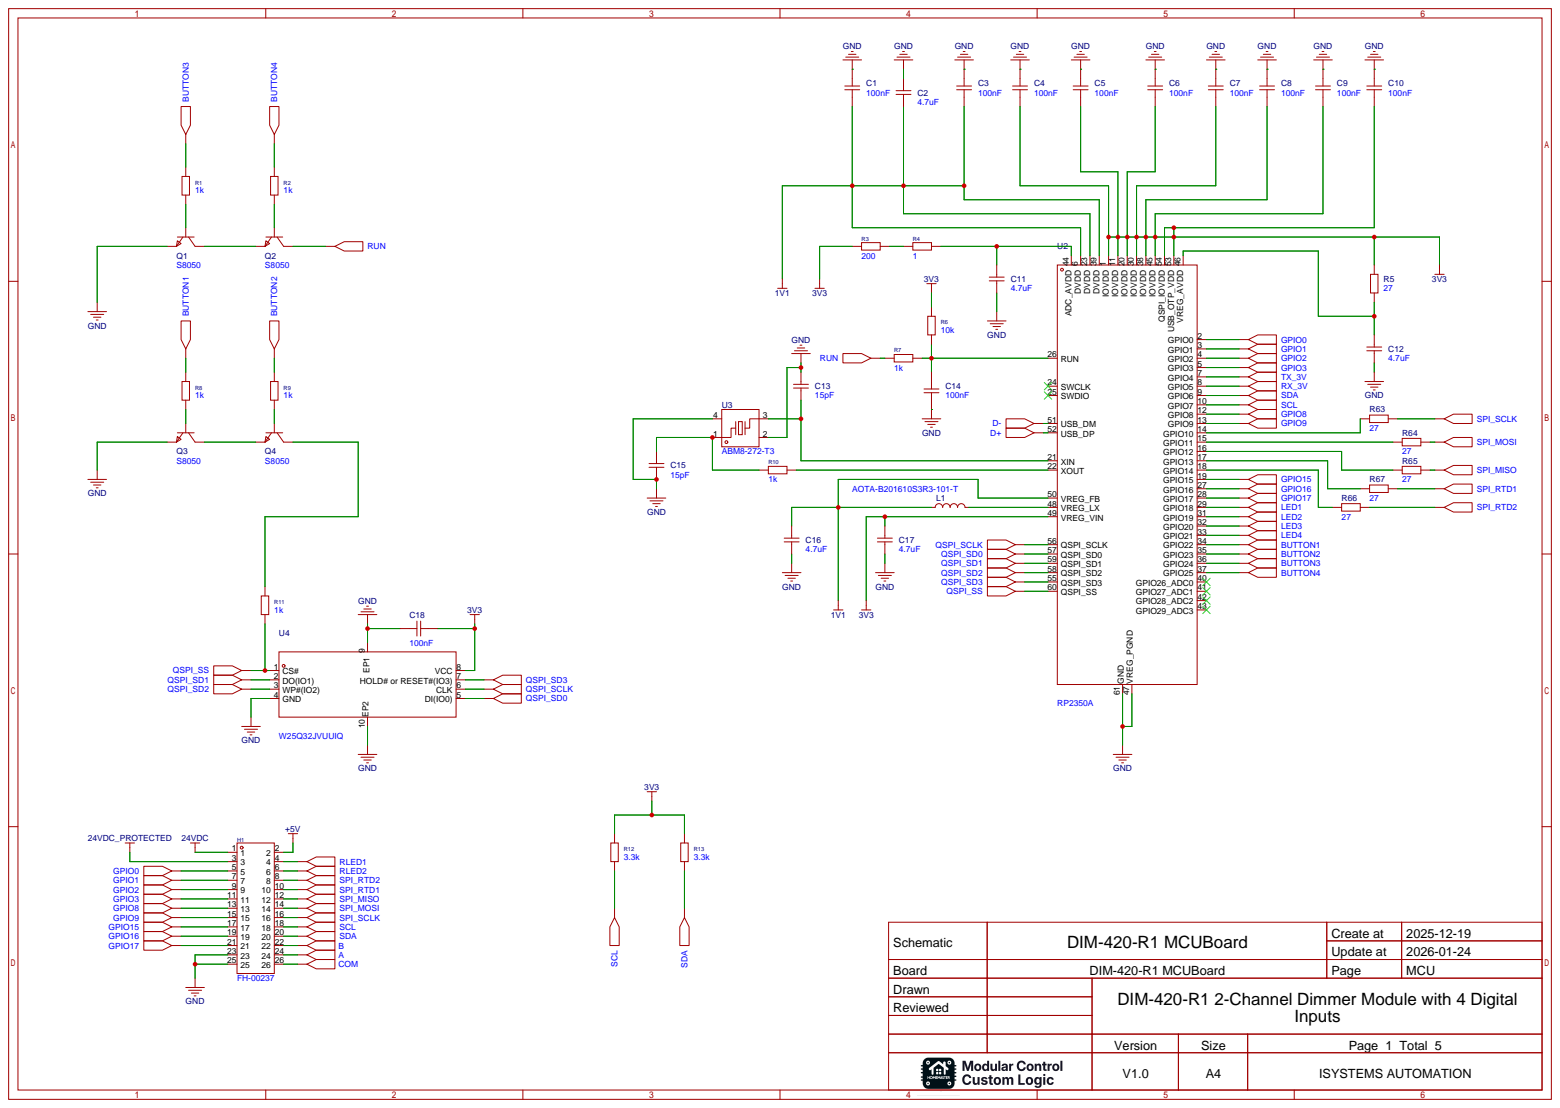
[picture p265: page 1]

Schematic | DIM-420-R1 MCUBoard | Create at | 2025-12-19

Update at | 2026-01-24

Board | DIM-420-R1 MCUBoard | Page | MCU
Drawn | | DIM-420-R1 2-Channel Dimmer Module with 4 Digital Inputs Reviewed

Version | Size | Page 1 Total 5
V1.0 | A4 | ISYSTEMS AUTOMATION

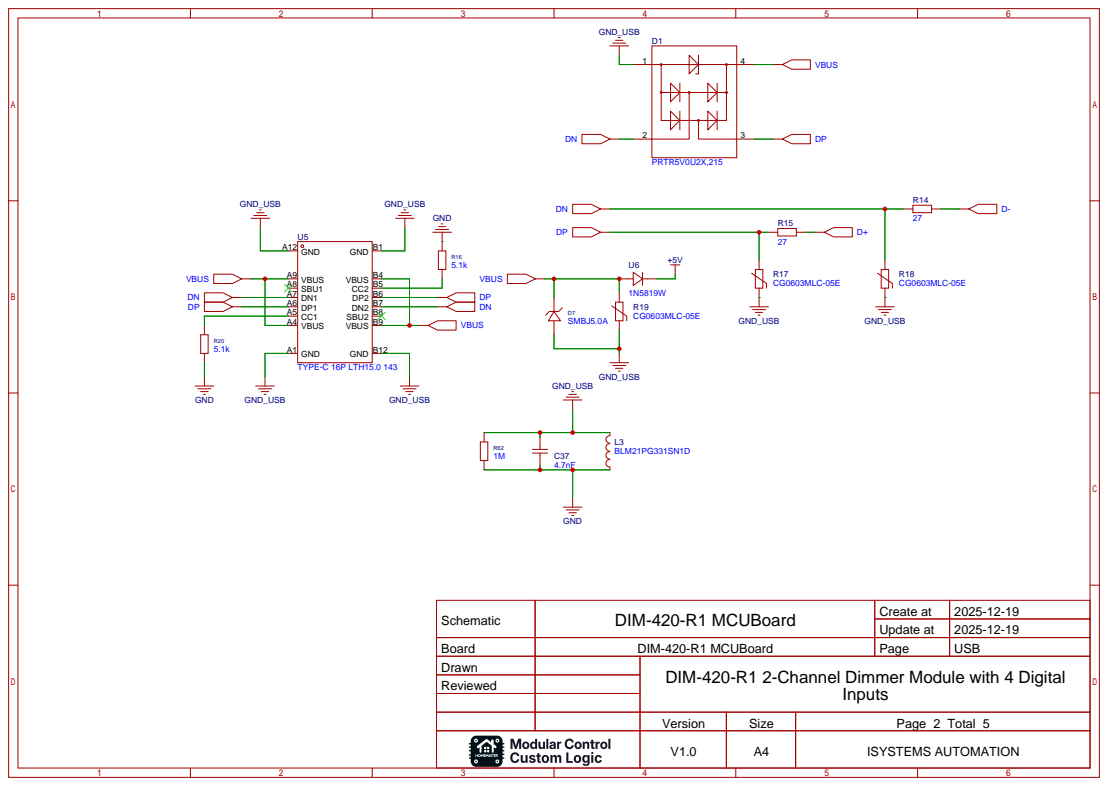
[picture p266: page 2]

Schematic | DIM-420-R1 MCUBoard | Create at | 2025-12-19

Update at | 2025-12-19

Board | DIM-420-R1 MCUBoard | Page | USB
Drawn | | DIM-420-R1 2-Channel Dimmer Module with 4 Digital Inputs Reviewed

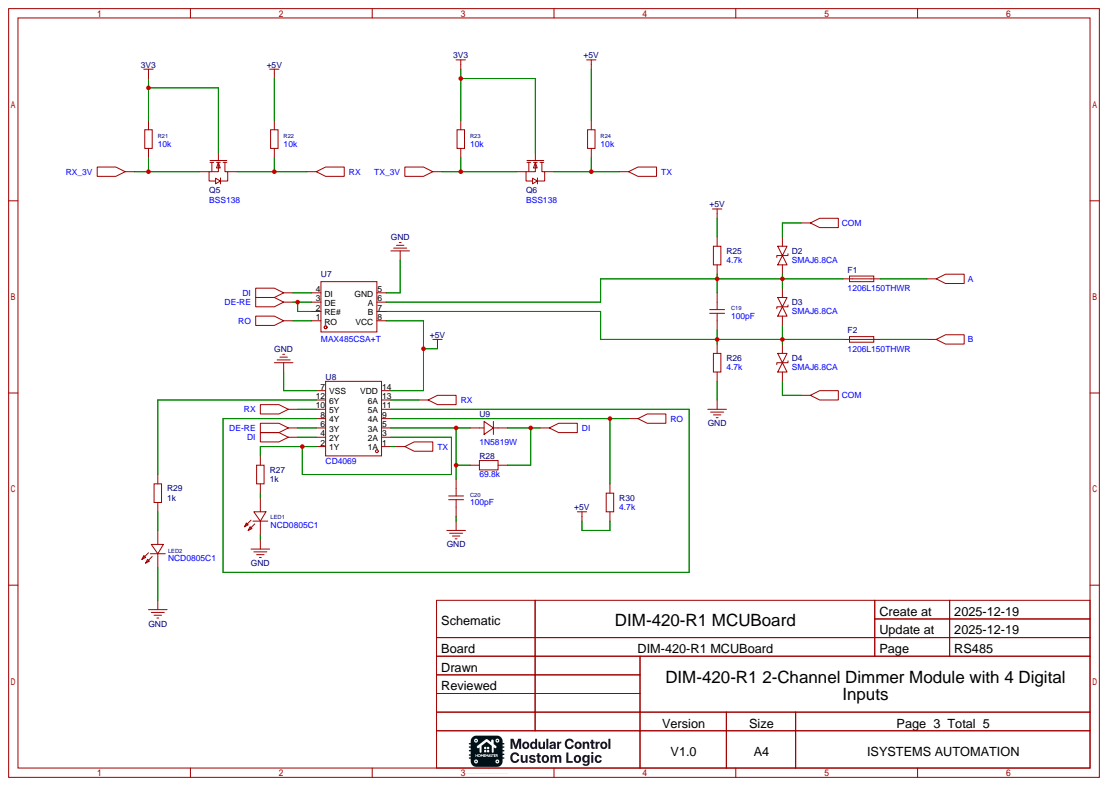
[picture p267: page 3]

Schematic | DIM-420-R1 MCUBoard | Create at | 2025-12-19

Update at | 2025-12-19

Board | DIM-420-R1 MCUBoard | Page | RS485
Drawn | | DIM-420-R1 2-Channel Dimmer Module with 4 Digital Inputs Reviewed

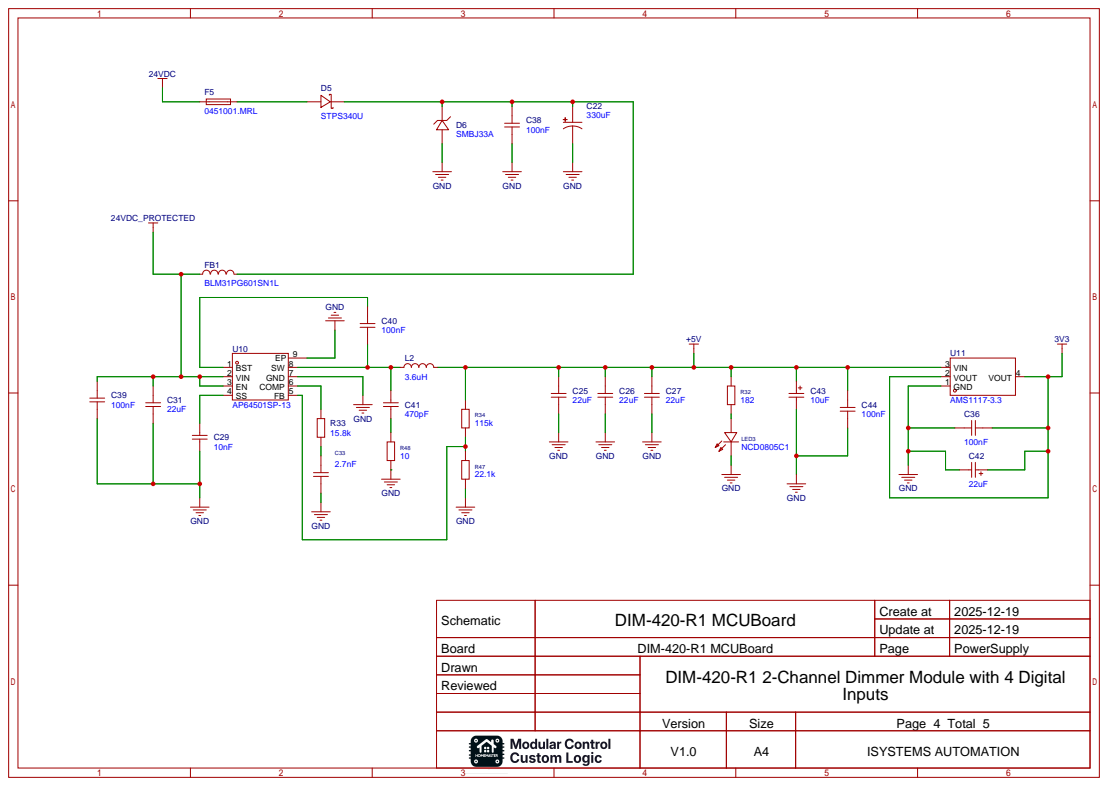
[picture p268: page 4]

Schematic | DIM-420-R1 MCUBoard | Create at | 2025-12-19

Update at | 2025-12-19

Board | DIM-420-R1 MCUBoard | Page | PowerSupply
Drawn | | DIM-420-R1 2-Channel Dimmer Module with 4 Digital Inputs Reviewed

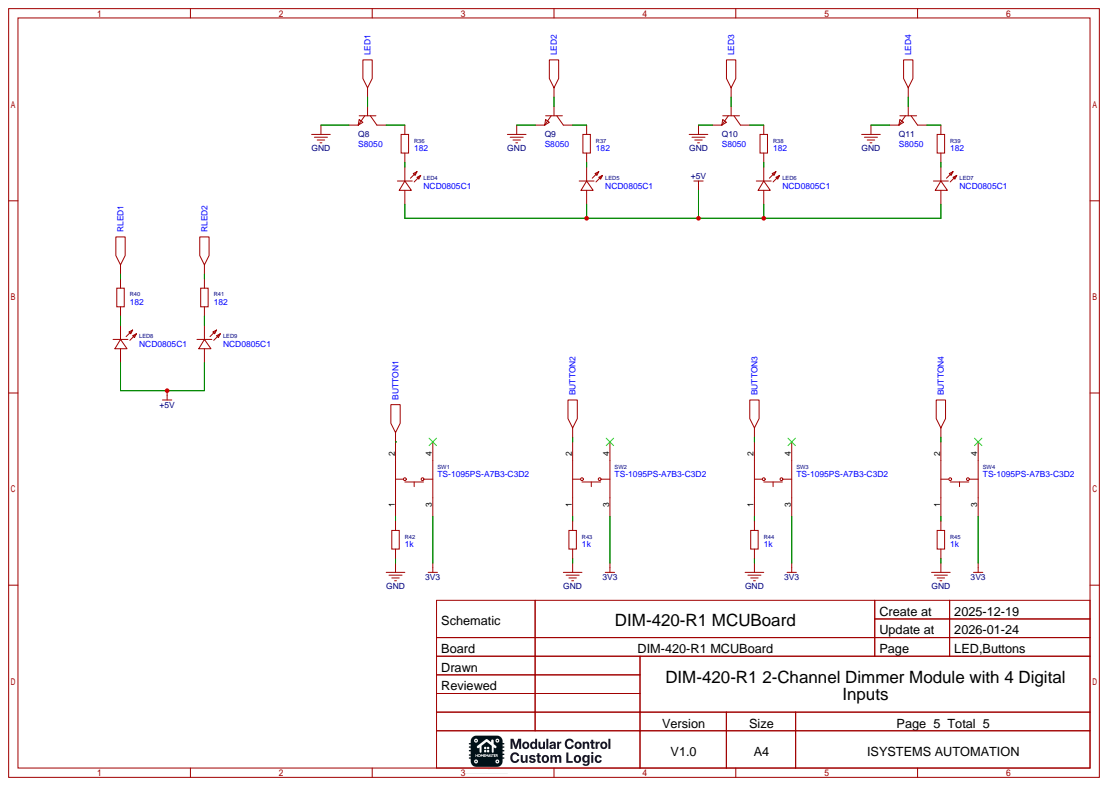
[picture p269: page 5]

Schematic | DIM-420-R1 MCUBoard | Create at | 2025-12-19

Update at | 2026-01-24

Board | DIM-420-R1 MCUBoard | Page | LED,Buttons
Drawn | | DIM-420-R1 2-Channel Dimmer Module with 4 Digital Inputs Reviewed
