isystemsautomation/HOMEMASTER/DIO-430-R1/Schematics/DIO-430-R1-RelayBoard.pdf

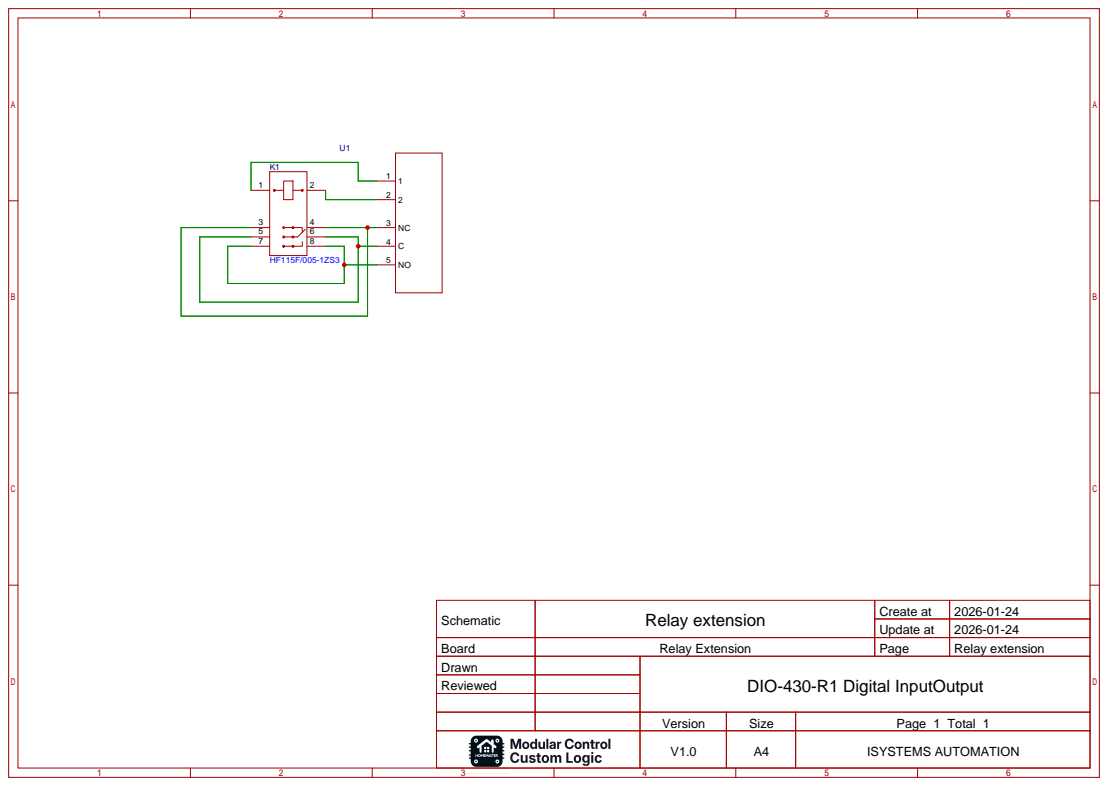
[picture p270: page 1]

Schematic | Relay extension | Create at | 2026-01-24

Update at | 2026-01-24

Board | Relay Extension | Page | Relay extension
Drawn | | DIO-430-R1 Digital InputOutput
Reviewed

Version | Size | Page 1 Total 1
V1.0 | A4 | ISYSTEMS AUTOMATION
