isystemsautomation/HOMEMASTER/ENM-223-R1/Schematics/ENM-223-R1-FieldBoard.pdf

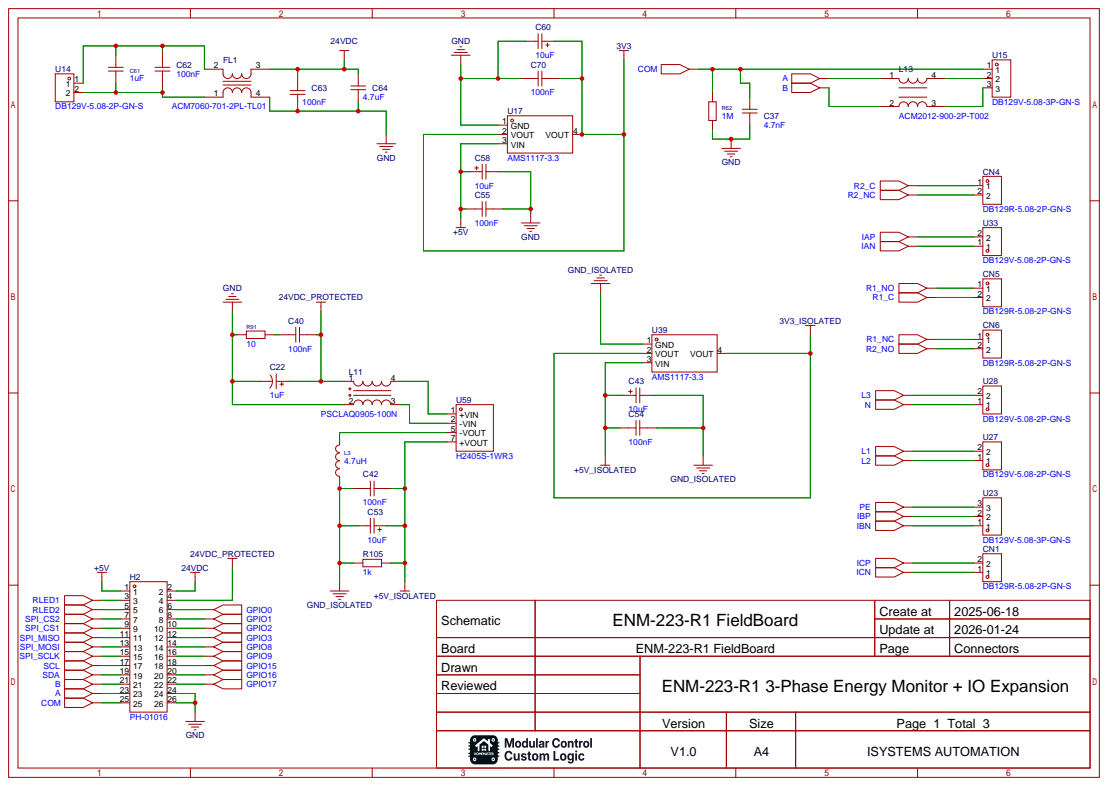
[picture p271: page 1]

Schematic | ENM-223-R1 FieldBoard | Create at | 2025-06-18

Update at | 2026-01-24

Board | ENM-223-R1 FieldBoard | Page | Connectors
Drawn | | ENM-223-R1 3-Phase Energy Monitor + IO Expansion
Reviewed

Version | Size | Page 1 Total 3
V1.0 | A4 | ISYSTEMS AUTOMATION

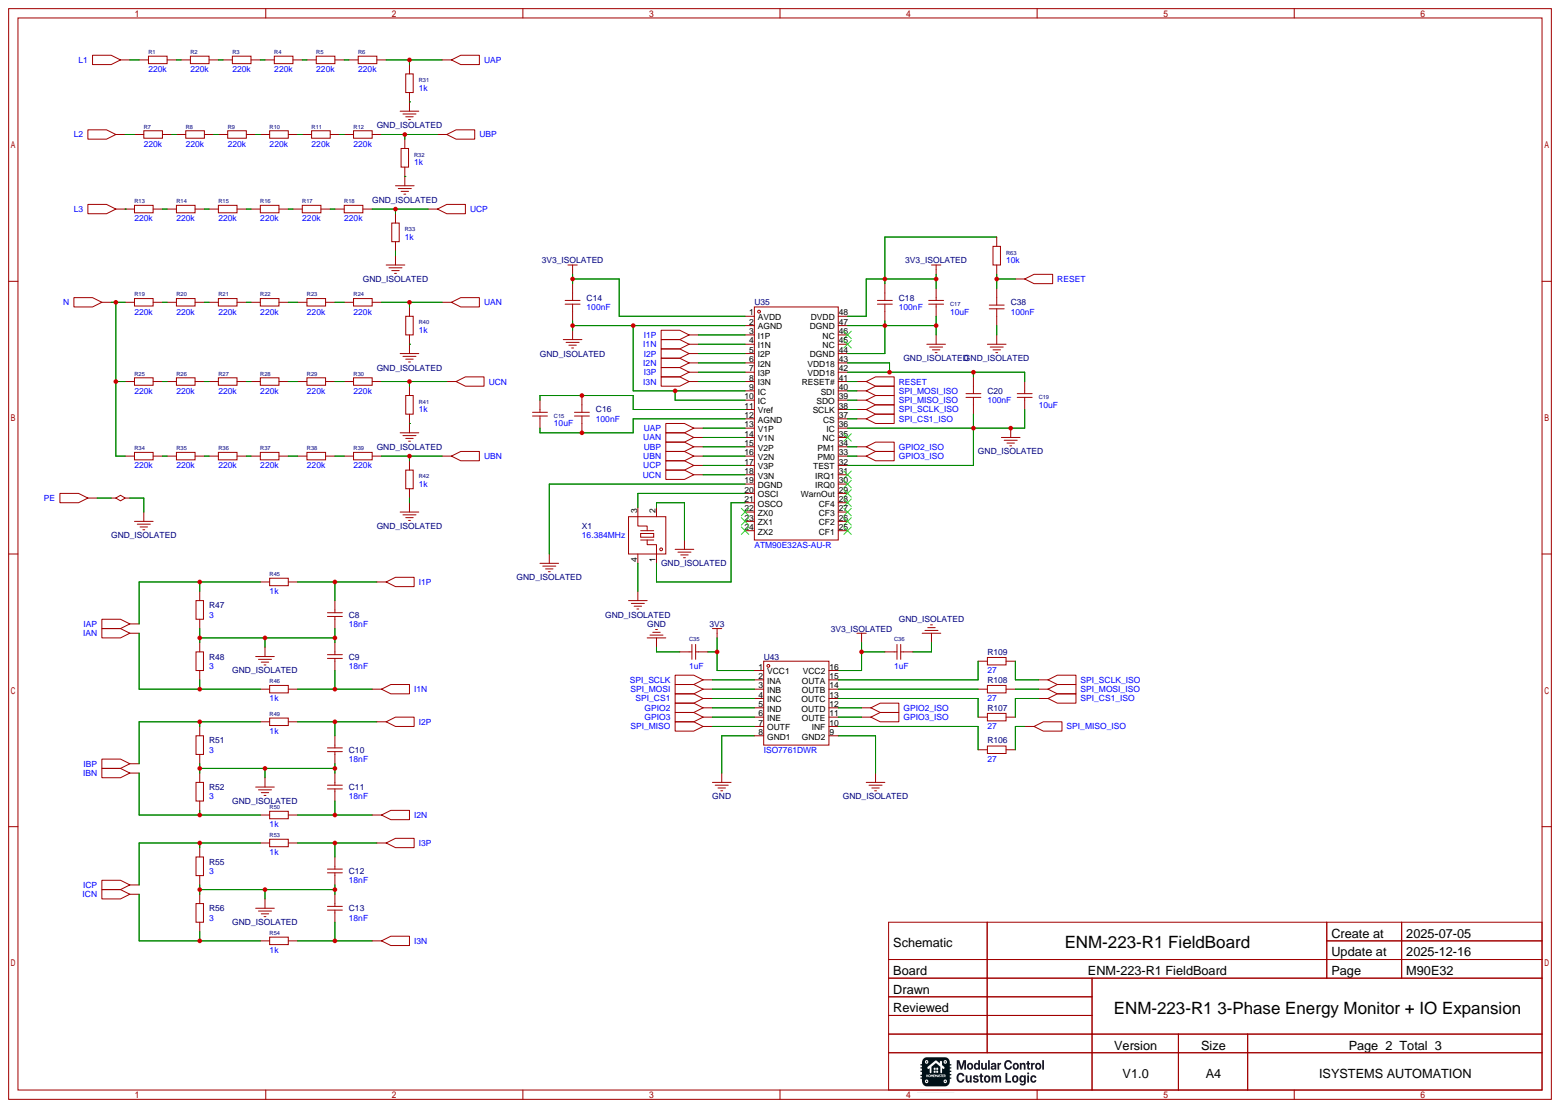
[picture p272: page 2]

Schematic | ENM-223-R1 FieldBoard | Create at | 2025-07-05

Update at | 2025-12-16

Board | ENM-223-R1 FieldBoard | Page | M90E32
Drawn | | ENM-223-R1 3-Phase Energy Monitor + IO Expansion
Reviewed

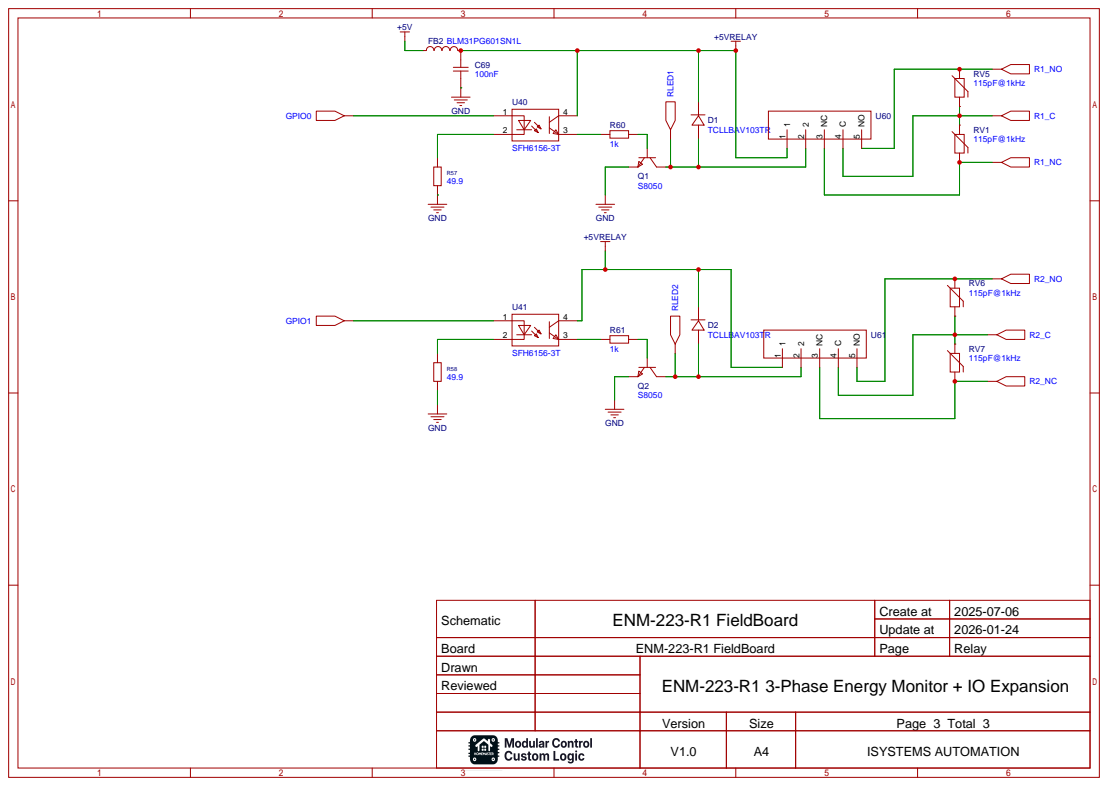
[picture p273: page 3]

Schematic | ENM-223-R1 FieldBoard | Create at | 2025-07-06

Update at | 2026-01-24

Board | ENM-223-R1 FieldBoard | Page | Relay
Drawn | | ENM-223-R1 3-Phase Energy Monitor + IO Expansion
Reviewed
