isystemsautomation/HOMEMASTER/ENM-223-R1/Schematics/ENM-223-R1-MCUBoard.pdf

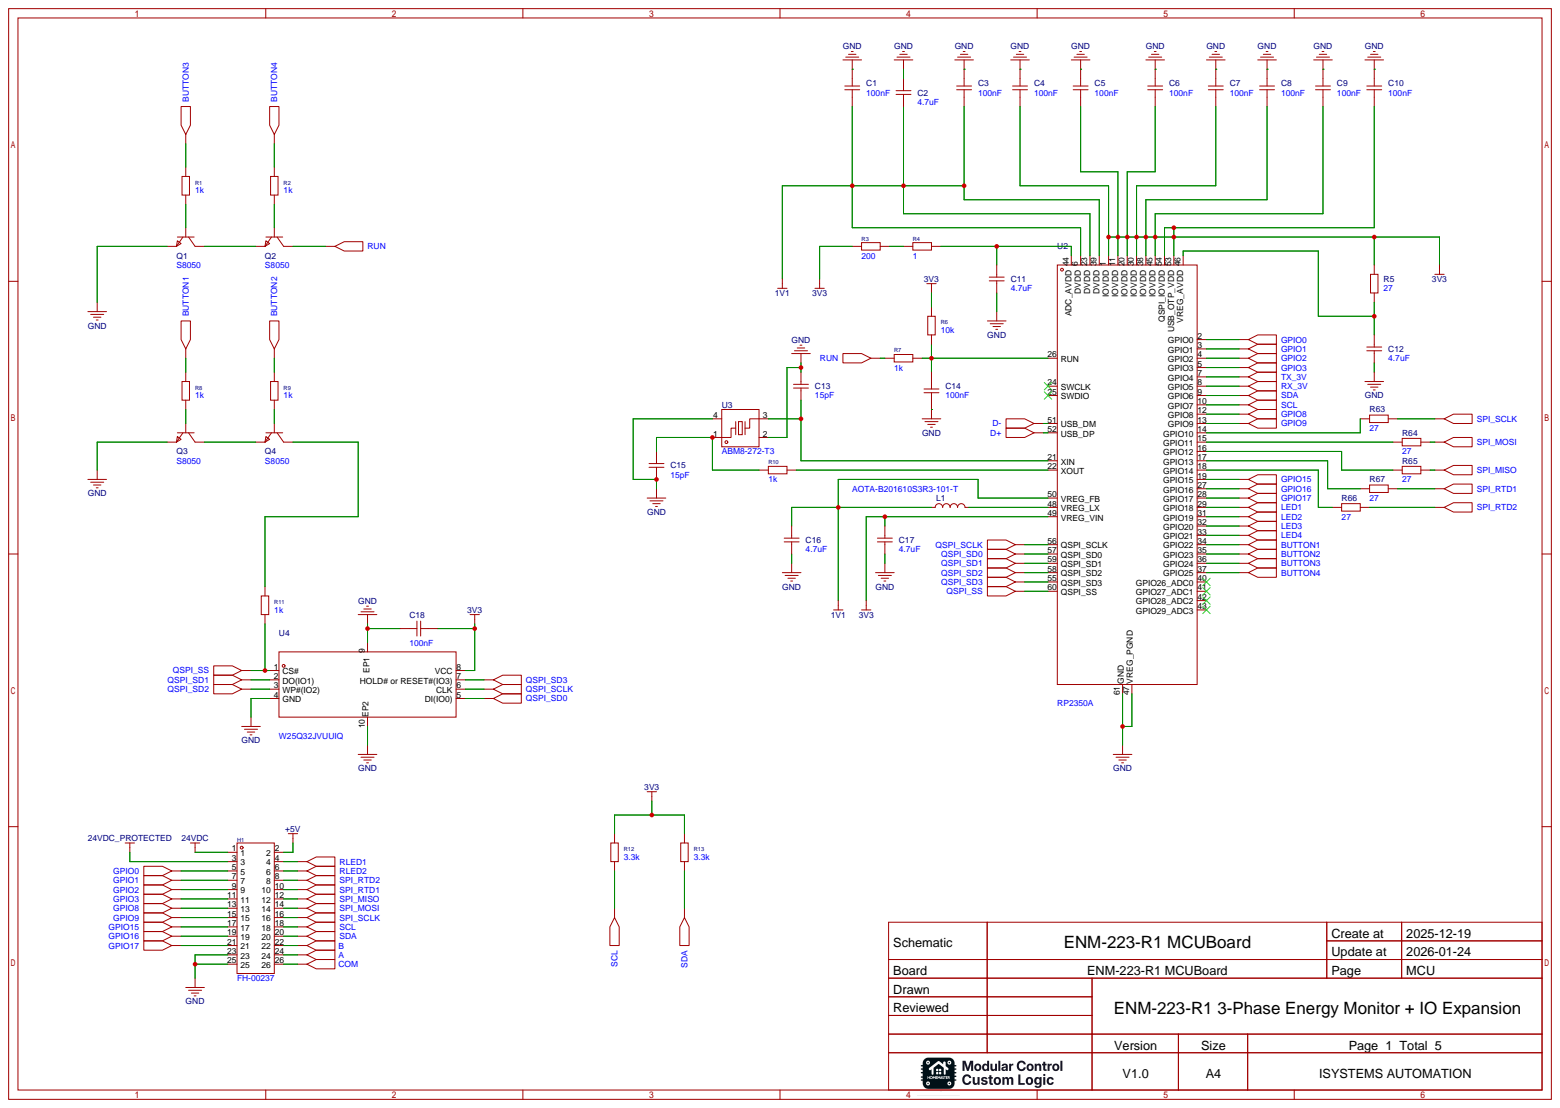
[picture p274: page 1]

Schematic | ENM-223-R1 MCUBoard | Create at | 2025-12-19

Update at | 2026-01-24

Board | ENM-223-R1 MCUBoard | Page | MCU
Drawn | | ENM-223-R1 3-Phase Energy Monitor + IO Expansion
Reviewed

Version | Size | Page 1 Total 5
V1.0 | A4 | ISYSTEMS AUTOMATION

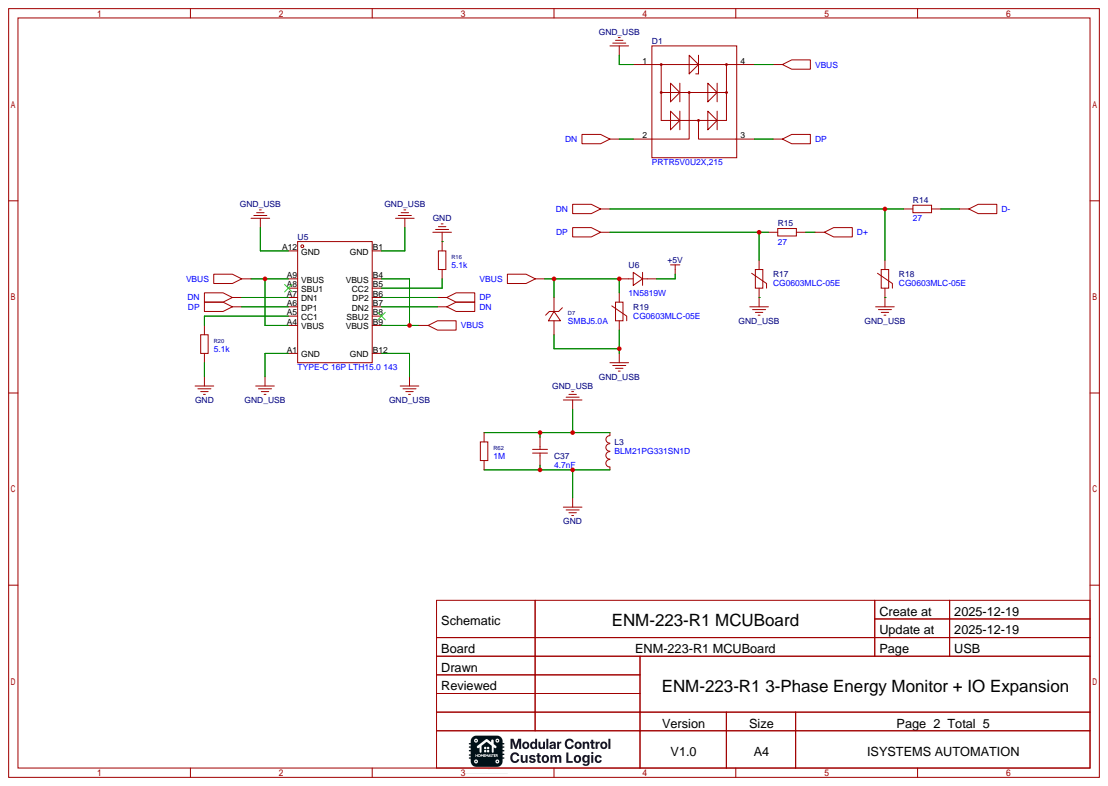
[picture p275: page 2]

Schematic | ENM-223-R1 MCUBoard | Create at | 2025-12-19

Update at | 2025-12-19

Board | ENM-223-R1 MCUBoard | Page | USB
Drawn | | ENM-223-R1 3-Phase Energy Monitor + IO Expansion
Reviewed

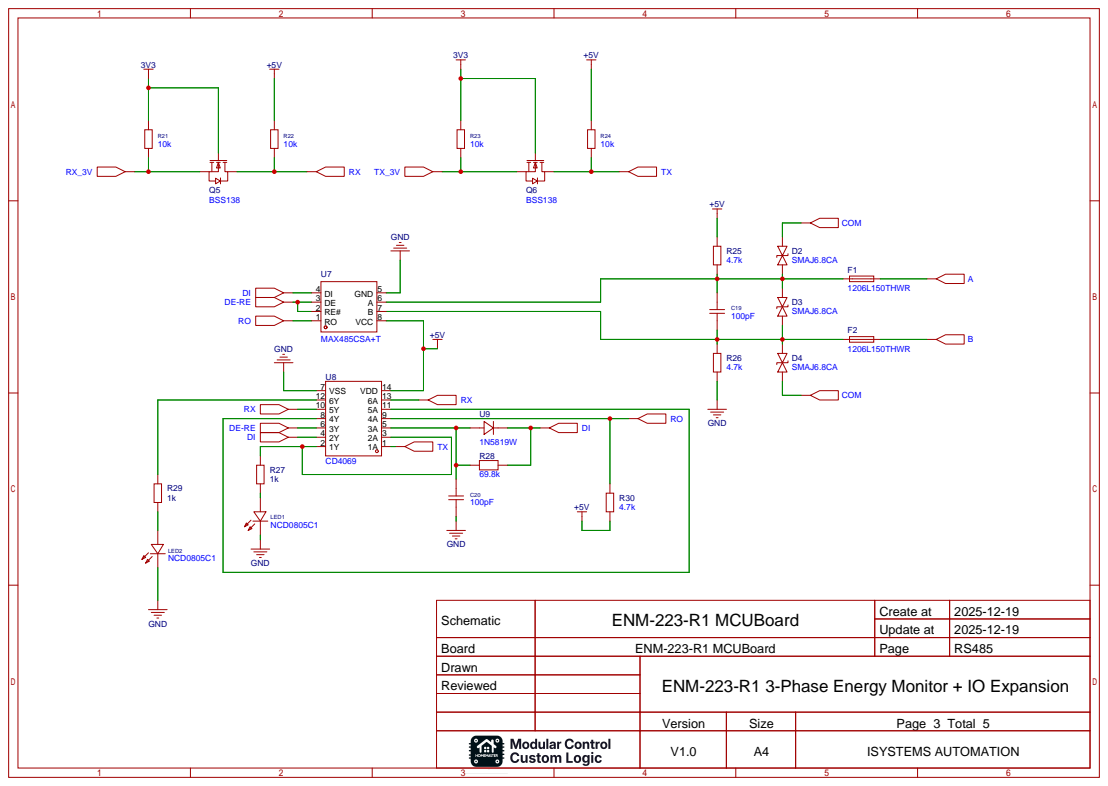
[picture p276: page 3]

Schematic | ENM-223-R1 MCUBoard | Create at | 2025-12-19

Update at | 2025-12-19

Board | ENM-223-R1 MCUBoard | Page | RS485
Drawn | | ENM-223-R1 3-Phase Energy Monitor + IO Expansion
Reviewed

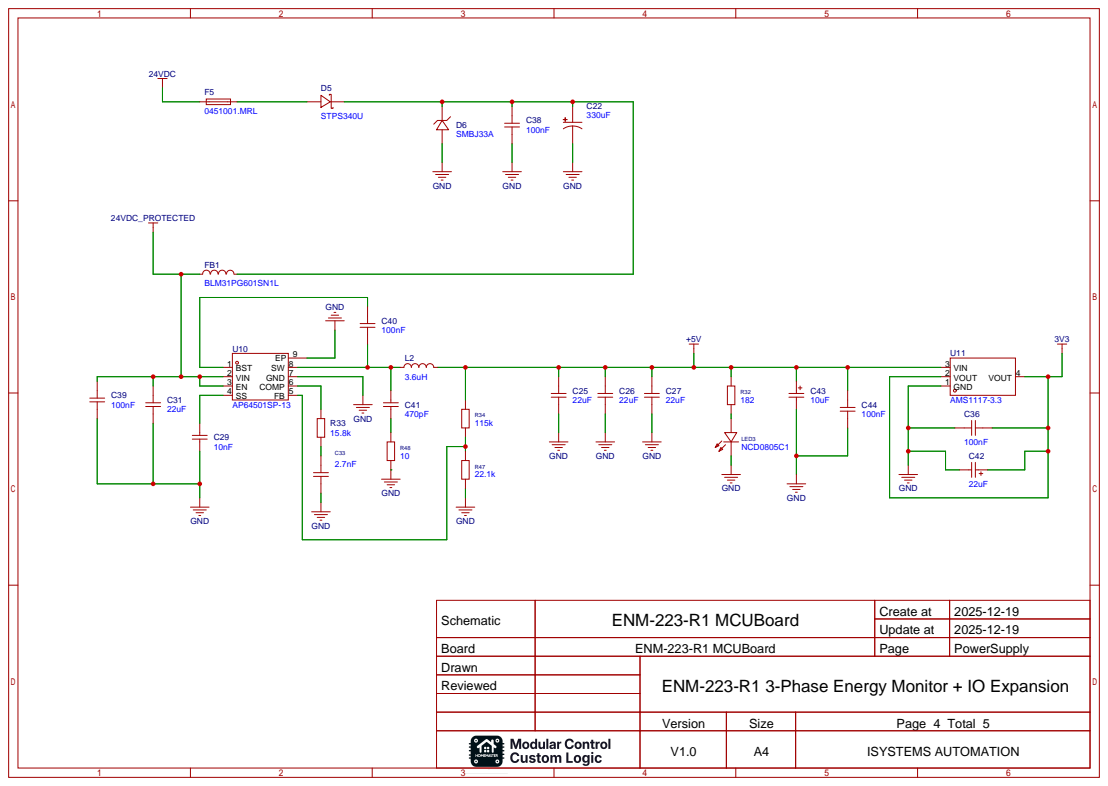
[picture p277: page 4]

Schematic | ENM-223-R1 MCUBoard | Create at | 2025-12-19

Update at | 2025-12-19

Board | ENM-223-R1 MCUBoard | Page | PowerSupply
Drawn | | ENM-223-R1 3-Phase Energy Monitor + IO Expansion
Reviewed

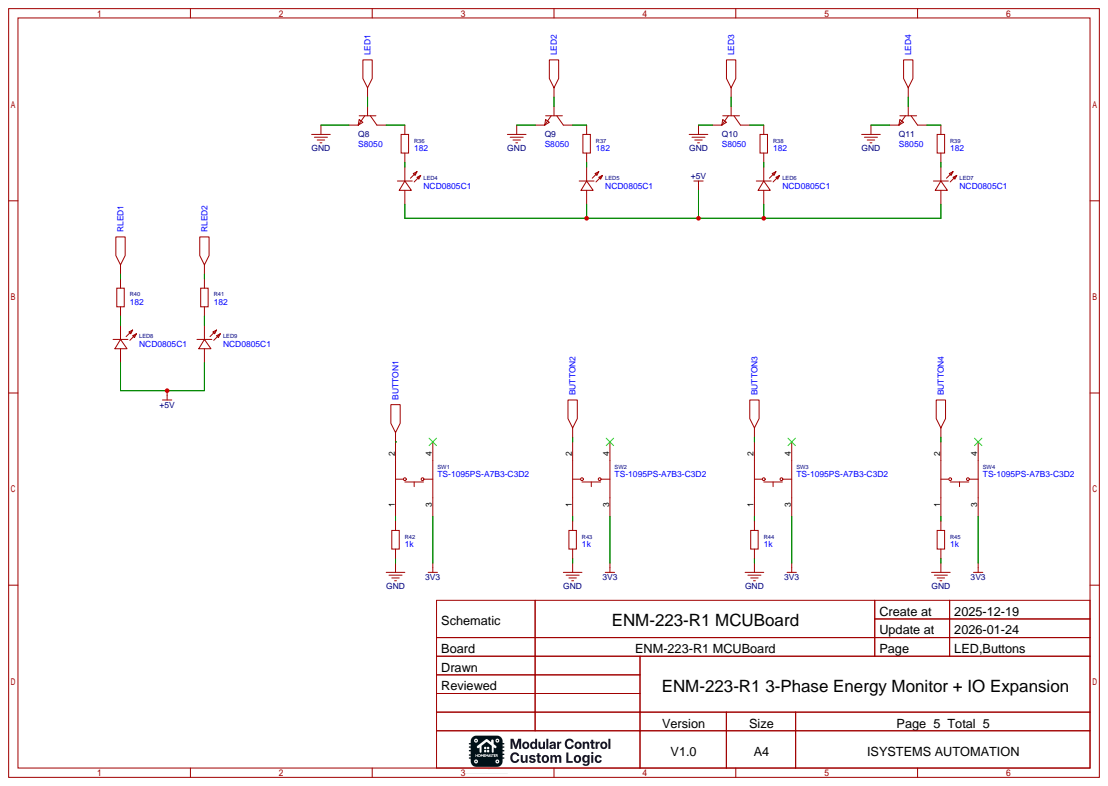
[picture p278: page 5]

Schematic | ENM-223-R1 MCUBoard | Create at | 2025-12-19

Update at | 2026-01-24

Board | ENM-223-R1 MCUBoard | Page | LED,Buttons
Drawn | | ENM-223-R1 3-Phase Energy Monitor + IO Expansion
Reviewed
