isystemsautomation/HOMEMASTER/RGB-621-R1/Schematics/RGB-621-R1-MCUBoard.pdf

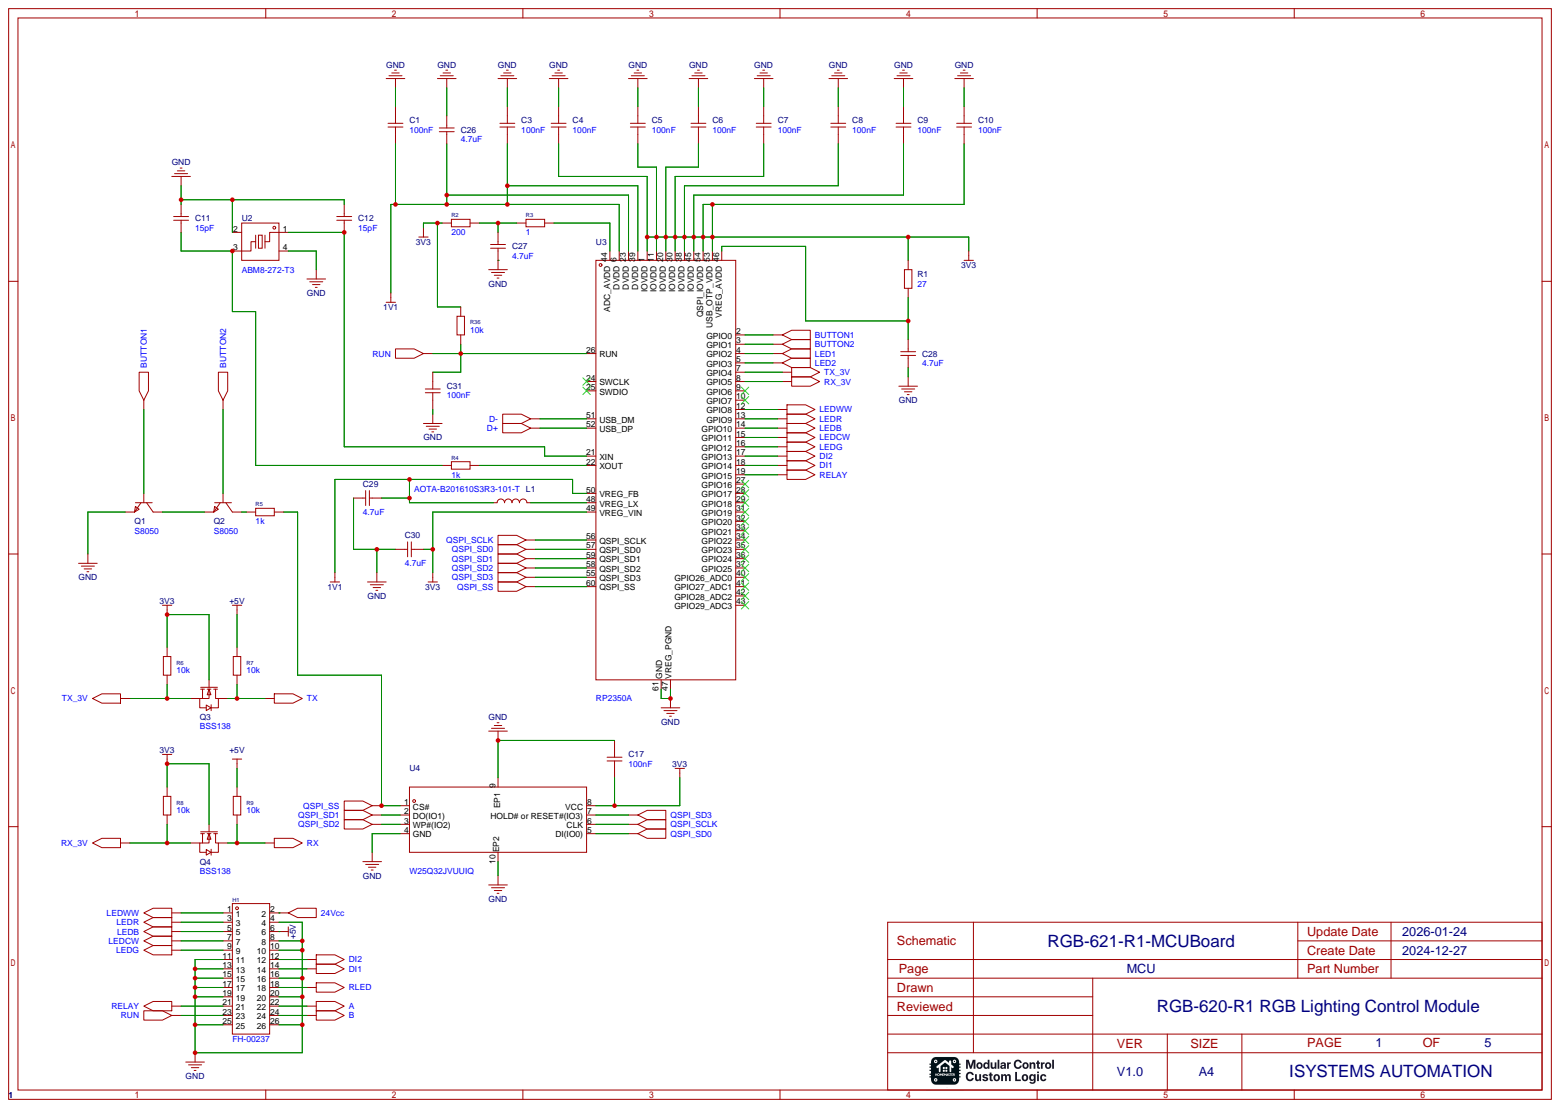
[picture p279: page 1]

MCU
RGB-620-R1 RGB Lighting Control Module

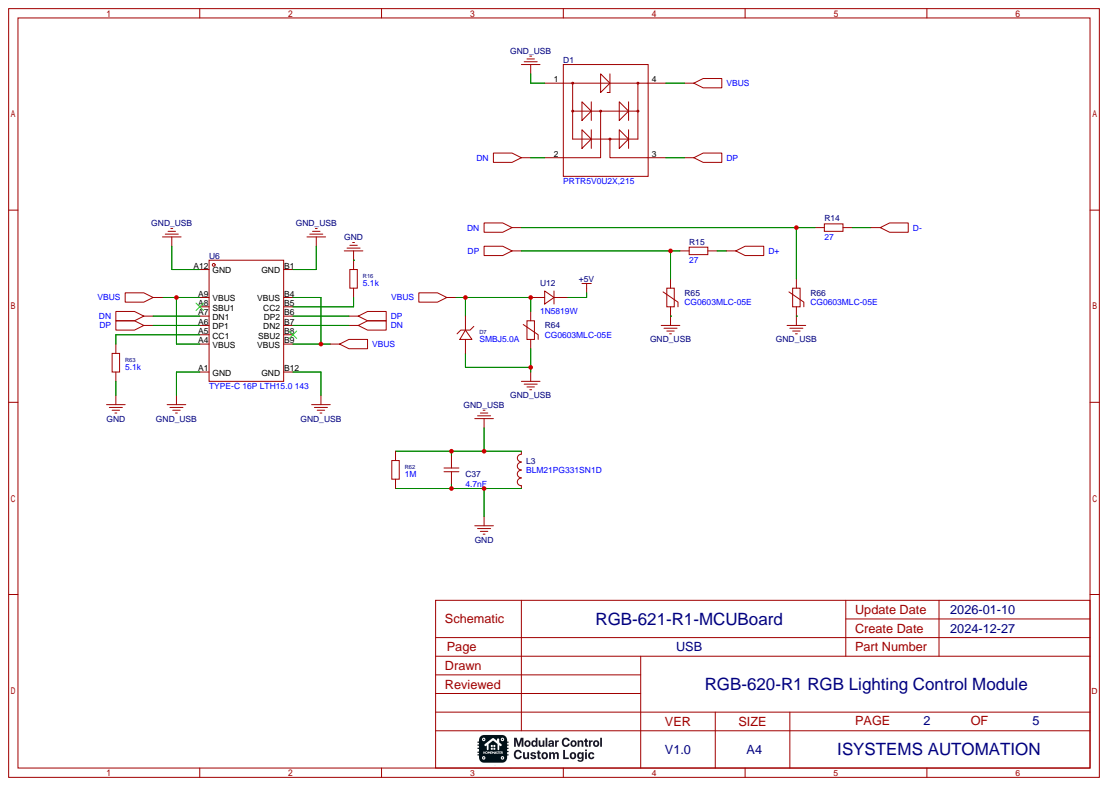
[picture p280: page 2]

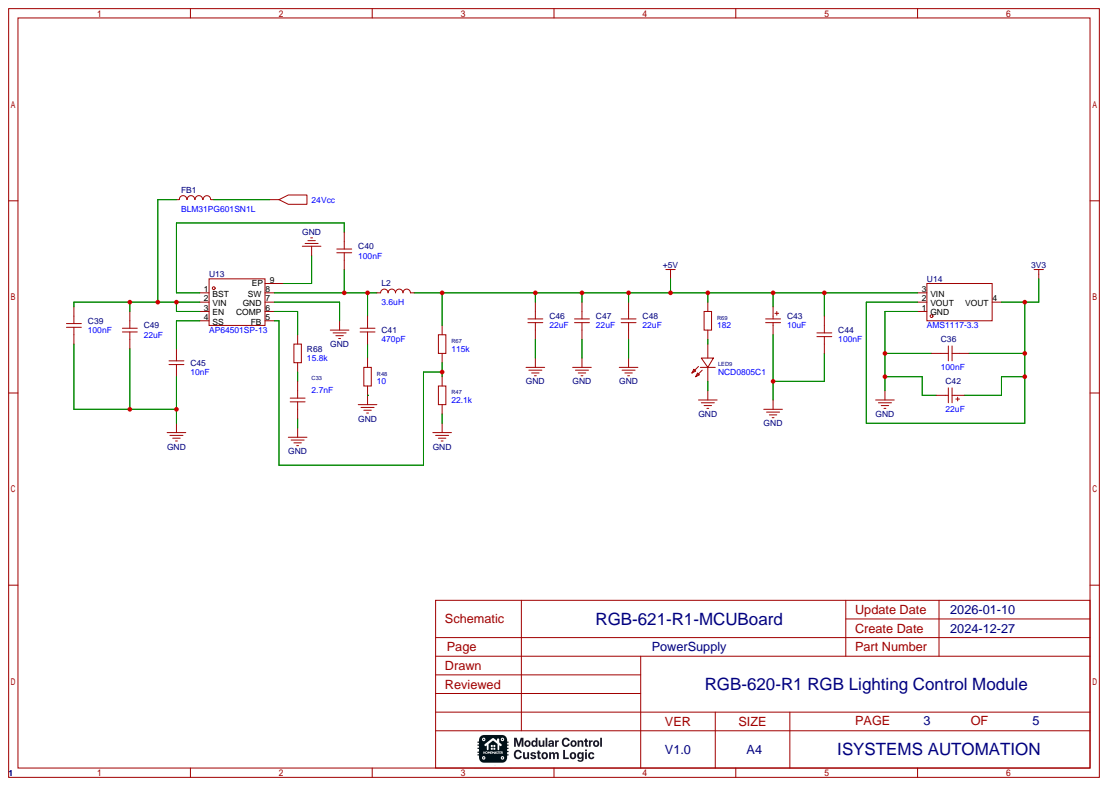
[picture p281: page 3]

PowerSupply
RGB-620-R1 RGB Lighting Control Module

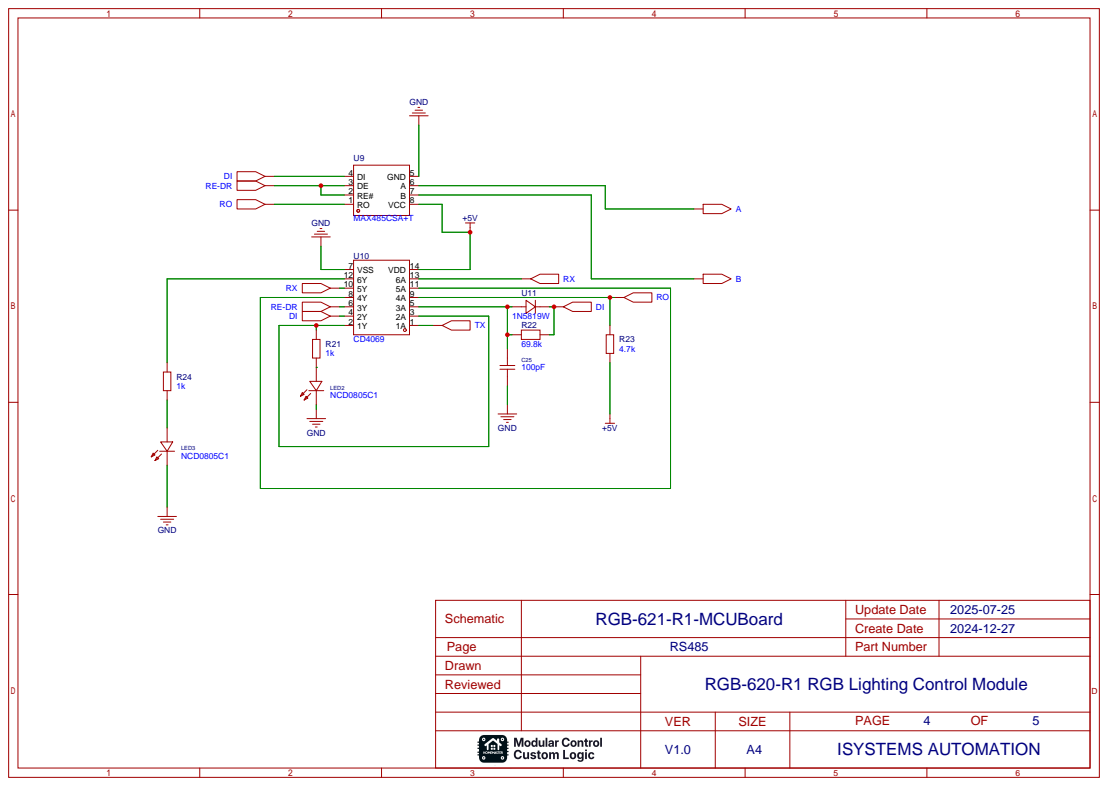
[picture p282: page 4]

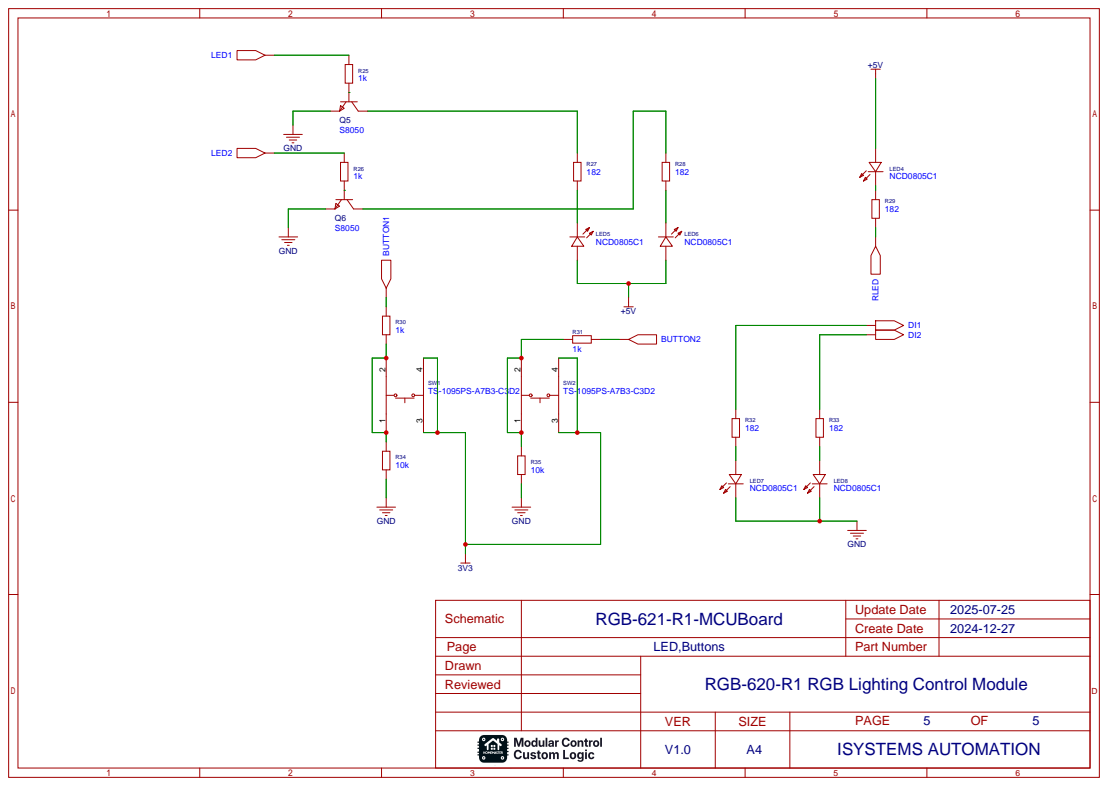
[picture p283: page 5]
