isystemsautomation/HOMEMASTER/STR-3221-R1/Schematics/SRT-3221-R1-FieldBoard.pdf

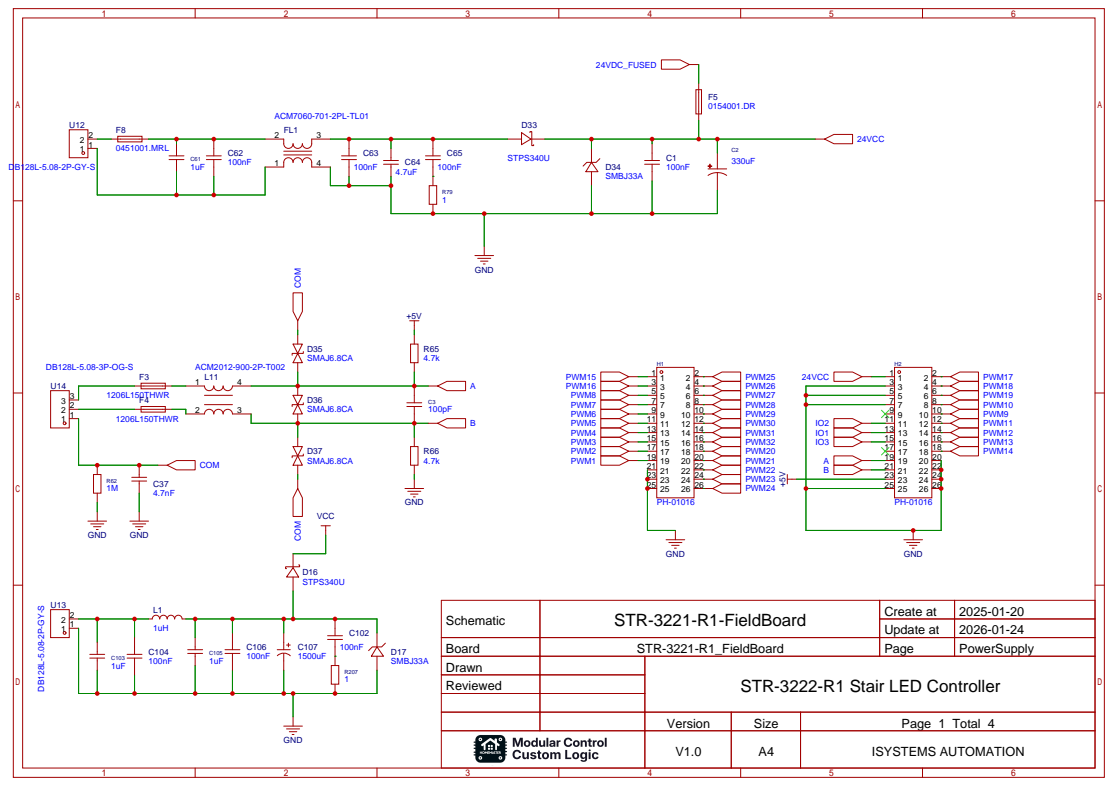
[picture p284: page 1]

Schematic | STR-3221-R1-FieldBoard | Create at | 2025-01-20

Update at | 2026-01-24

Board | STR-3221-R1_FieldBoard | Page | PowerSupply
Drawn | | STR-3222-R1 Stair LED Controller
Reviewed

Version | Size | Page 1 Total 4
V1.0 | A4 | ISYSTEMS AUTOMATION

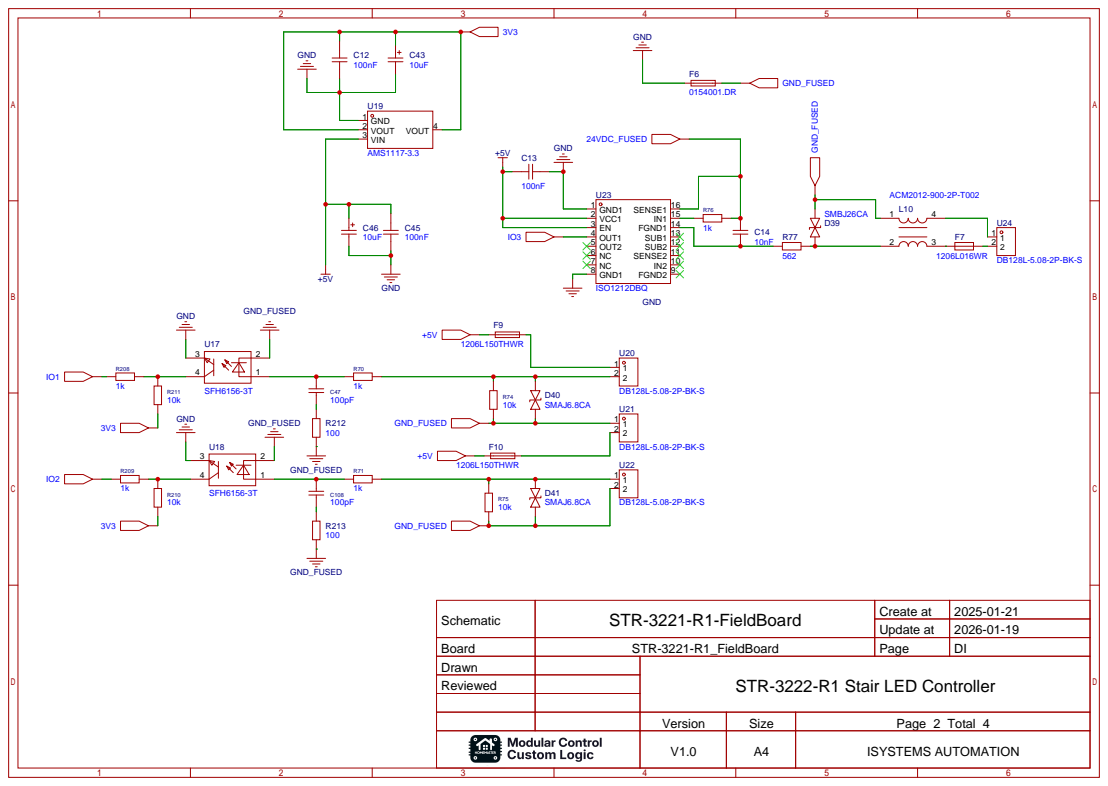
[picture p285: page 2]

Schematic | STR-3221-R1-FieldBoard | Create at | 2025-01-21

Update at | 2026-01-19

Board | STR-3221-R1_FieldBoard | Page | DI
Drawn | | STR-3222-R1 Stair LED Controller
Reviewed

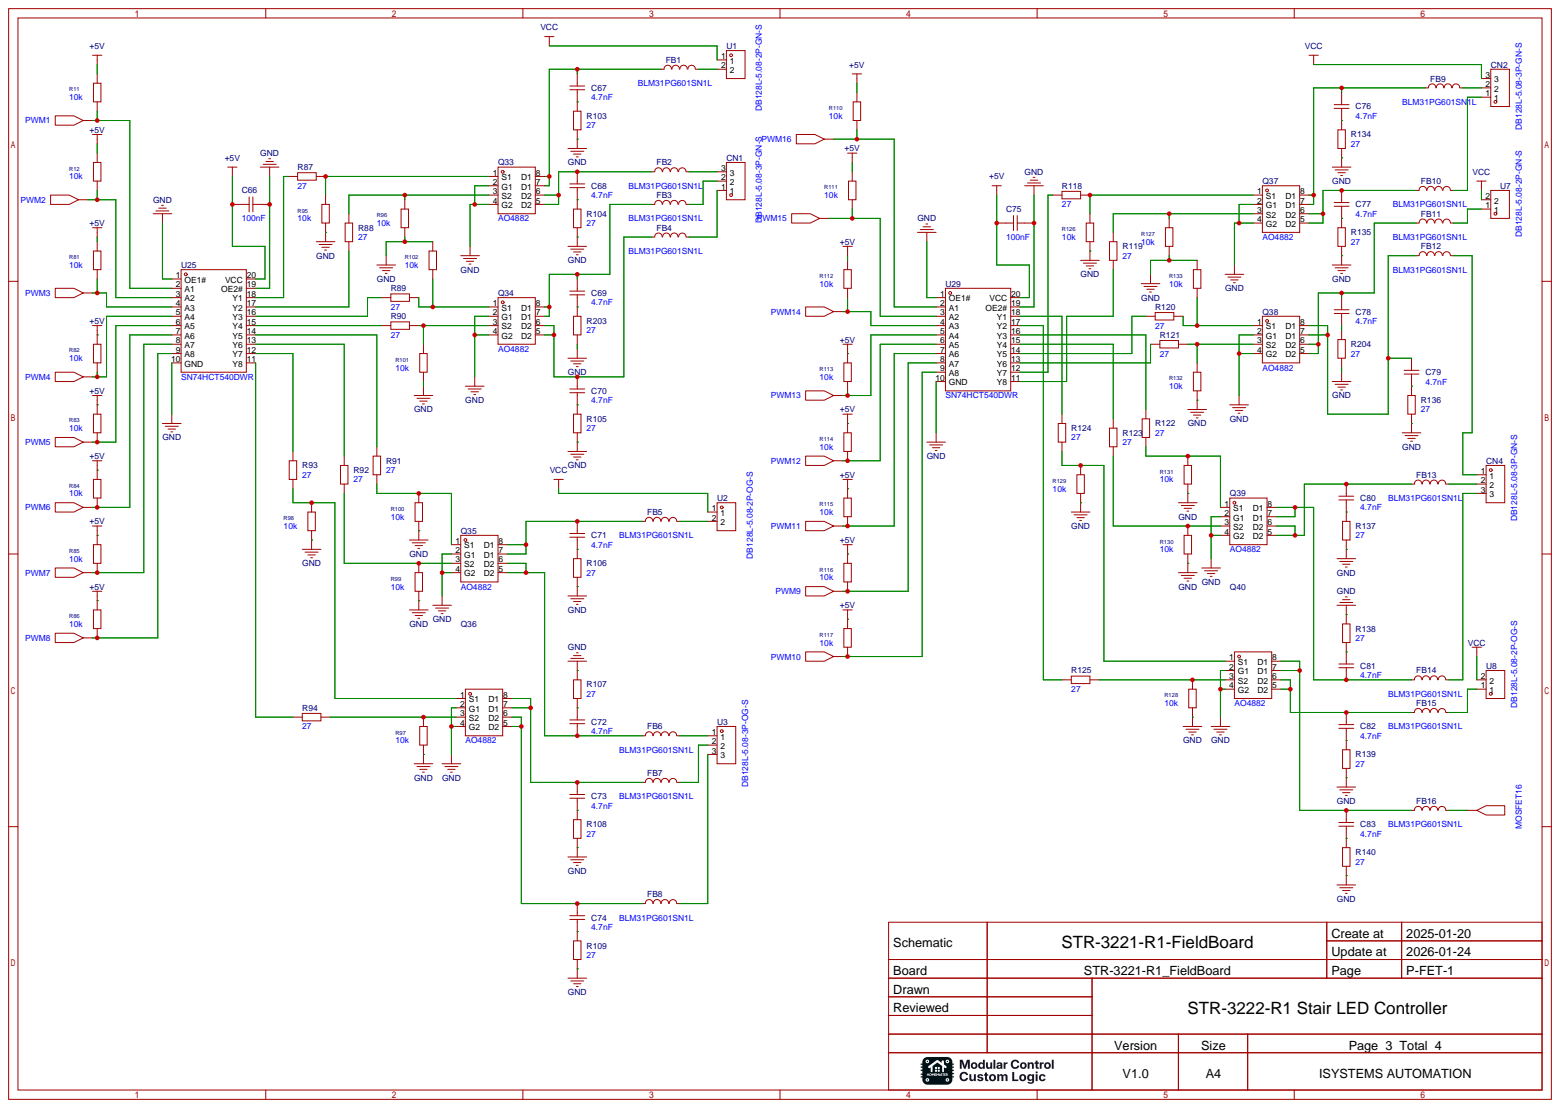
[picture p286: page 3]

Schematic | STR-3221-R1-FieldBoard | Create at | 2025-01-20

Update at | 2026-01-24

Board | STR-3221-R1_FieldBoard | Page | P-FET-1
Drawn | | STR-3222-R1 Stair LED Controller
Reviewed

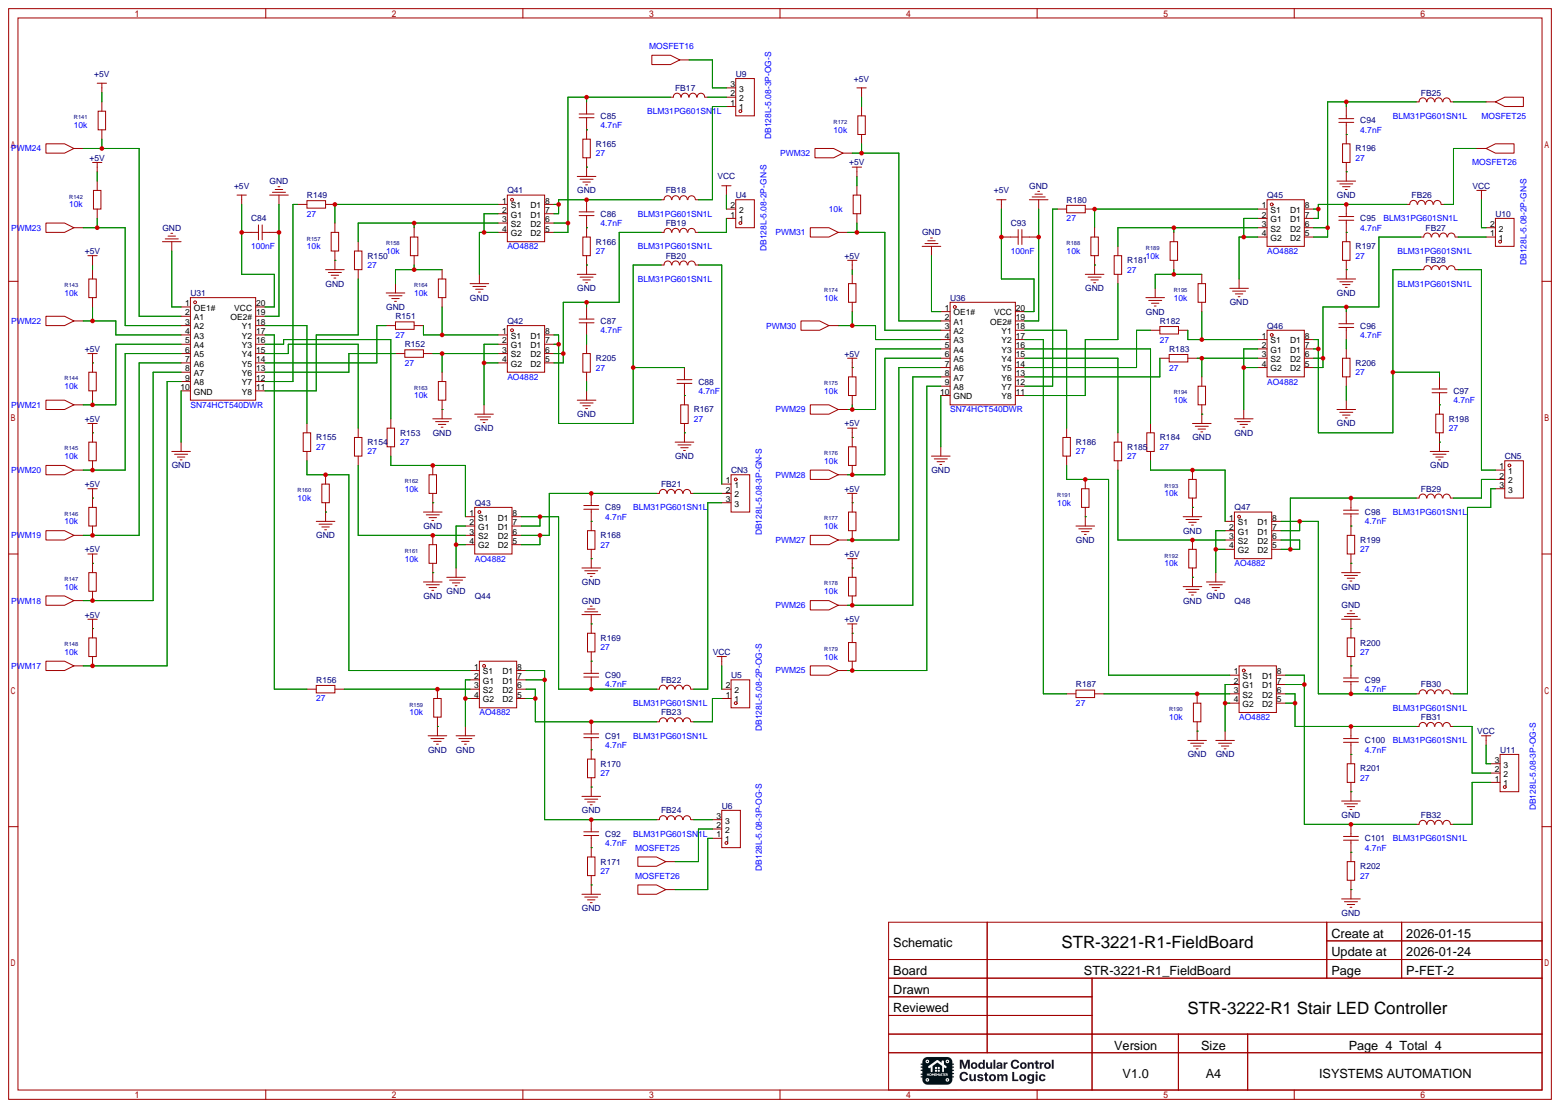
[picture p287: page 4]

Schematic | STR-3221-R1-FieldBoard | Create at | 2026-01-15

Update at | 2026-01-24

Board | STR-3221-R1_FieldBoard | Page | P-FET-2
Drawn | | STR-3222-R1 Stair LED Controller
Reviewed
