isystemsautomation/HOMEMASTER/STR-3221-R1/Schematics/SRT-3221-R1-MCUBoard.pdf

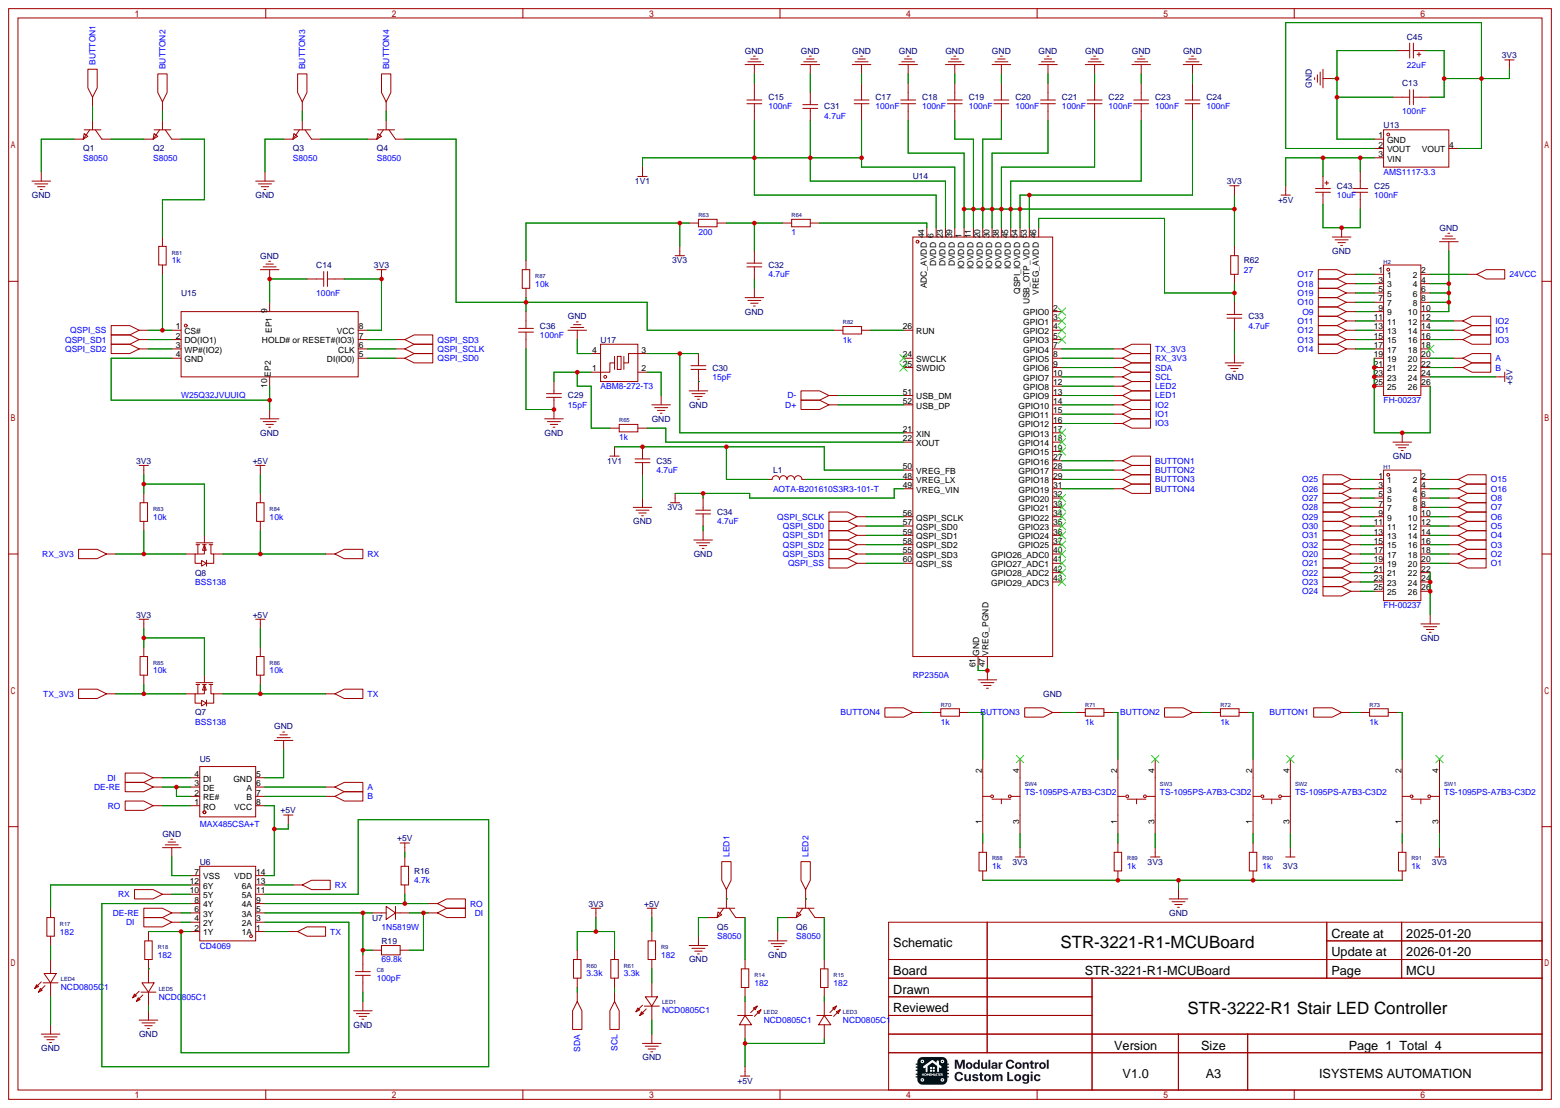
[picture p288: page 1]

Schematic | STR-3221-R1-MCUBoard | Create at | 2025-01-20

Update at | 2026-01-20

Board | STR-3221-R1-MCUBoard | Page | MCU
Drawn | | STR-3222-R1 Stair LED Controller
Reviewed

Version | Size | Page 1 Total 4
V1.0 | A3 | ISYSTEMS AUTOMATION

## LED9NCD⁰⁸⁰⁵C¹

## LED8NCD⁰⁸⁰⁵C¹

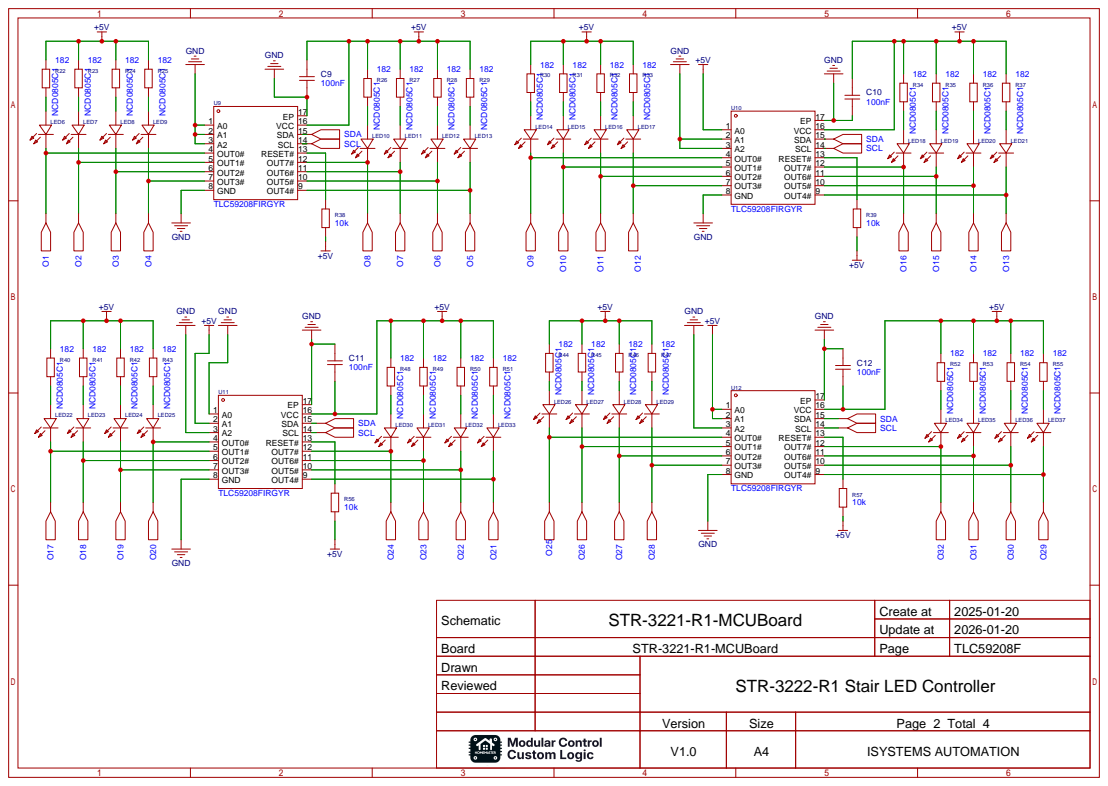
[picture p289: page 2]

OUT5# 10 OUT6# 11 OUT7# 12 RESET# 13 SCL 14 SDA 15 VCC 16 EP 17

Schematic | STR-3221-R1-MCUBoard | Create at | 2025-01-20

Update at | 2026-01-20

Board | STR-3221-R1-MCUBoard | Page | TLC59208F
Drawn | | STR-3222-R1 Stair LED Controller
Reviewed

Version | Size | Page 2 Total 4
V1.0 | A4 | ISYSTEMS AUTOMATION

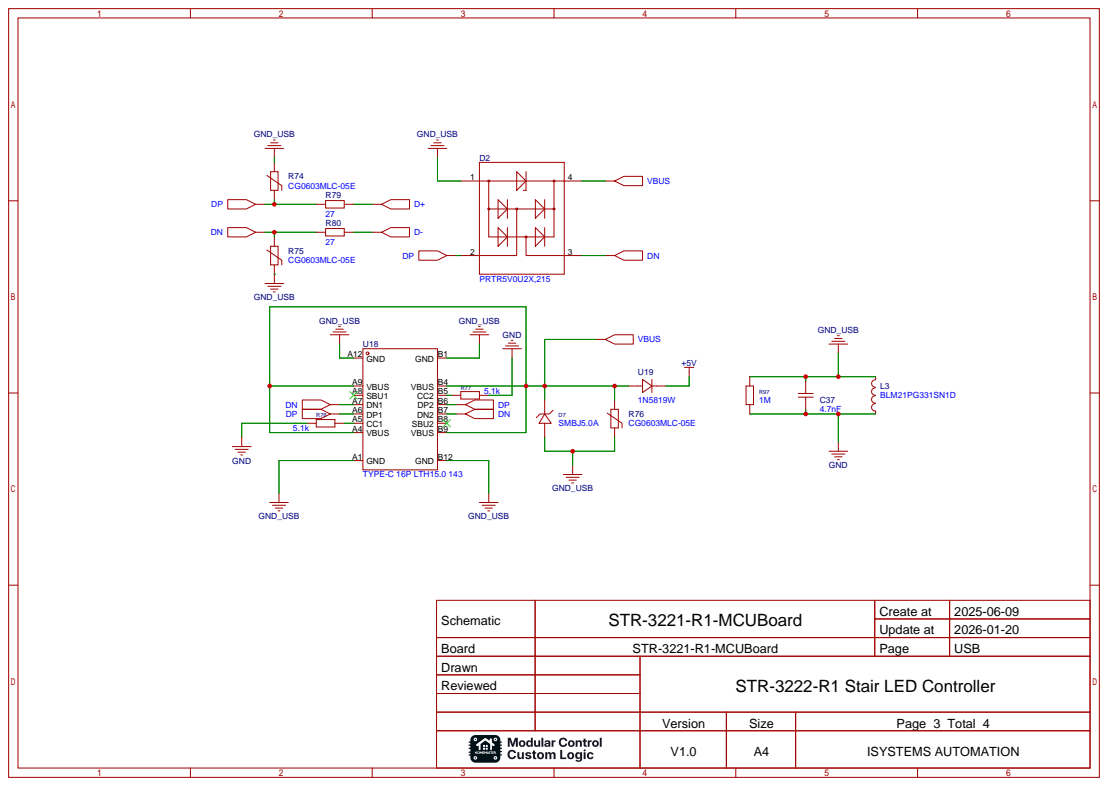
[picture p290: page 3]

Schematic | STR-3221-R1-MCUBoard | Create at | 2025-06-09

Update at | 2026-01-20

Board | STR-3221-R1-MCUBoard | Page | USB
Drawn | | STR-3222-R1 Stair LED Controller
Reviewed

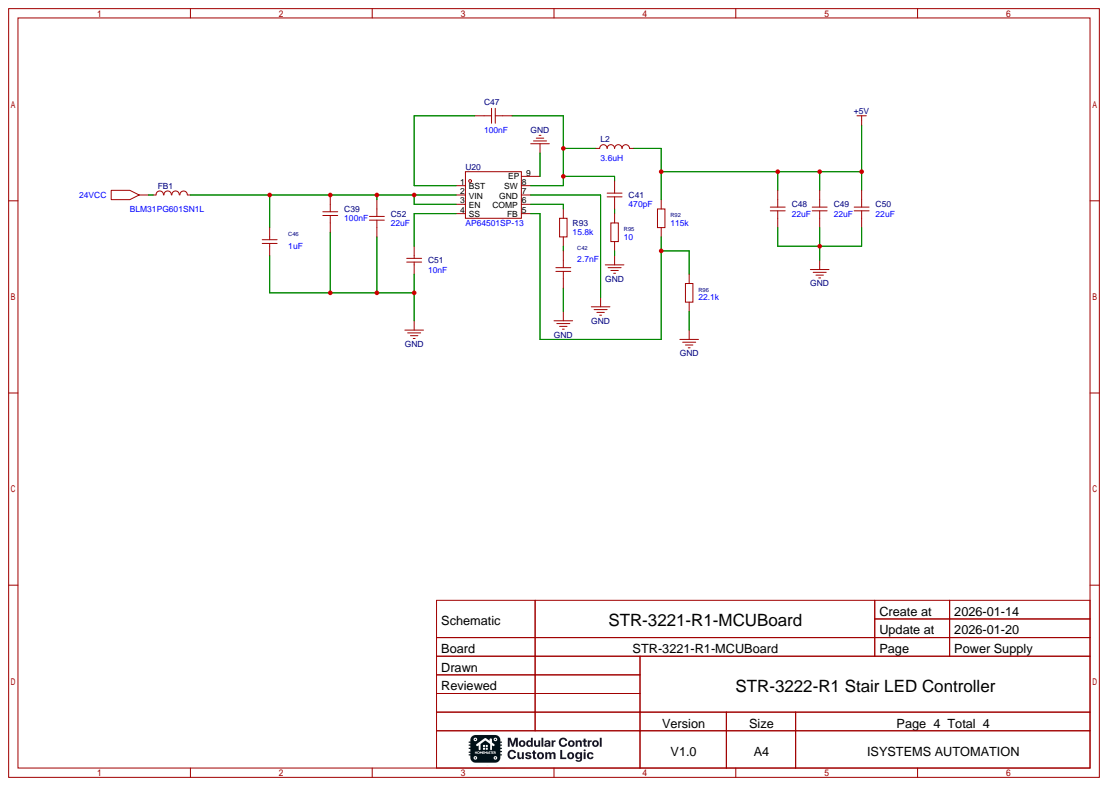
[picture p291: page 4]

Schematic | STR-3221-R1-MCUBoard | Create at | 2026-01-14

Update at | 2026-01-20

Board | STR-3221-R1-MCUBoard | Page | Power Supply
Drawn | | STR-3222-R1 Stair LED Controller
Reviewed
