isystemsautomation/HOMEMASTER/WLD-521-R1/Schematics/WLD-521-R1-FieldBoard.pdf

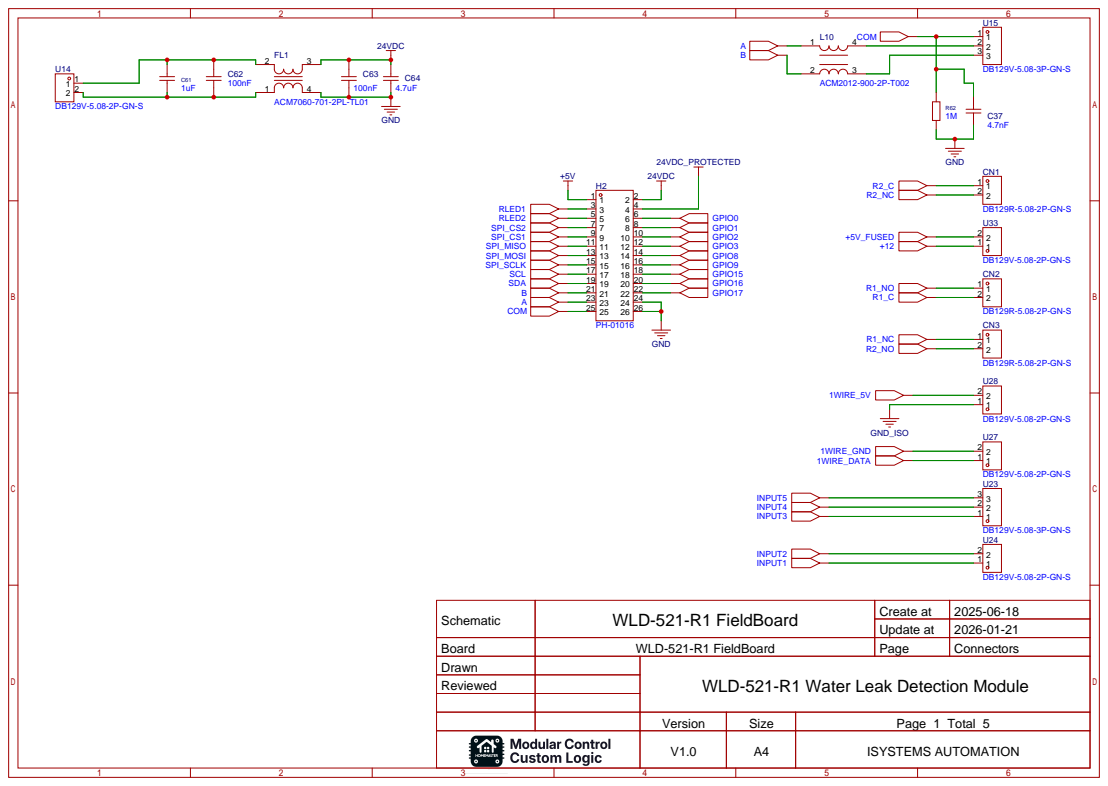
[picture p292: page 1]

Schematic | WLD-521-R1 FieldBoard | Create at | 2025-06-18

Update at | 2026-01-21

Board | WLD-521-R1 FieldBoard | Page | Connectors
Drawn | | WLD-521-R1 Water Leak Detection Module
Reviewed

Version | Size | Page 1 Total 5
V1.0 | A4 | ISYSTEMS AUTOMATION

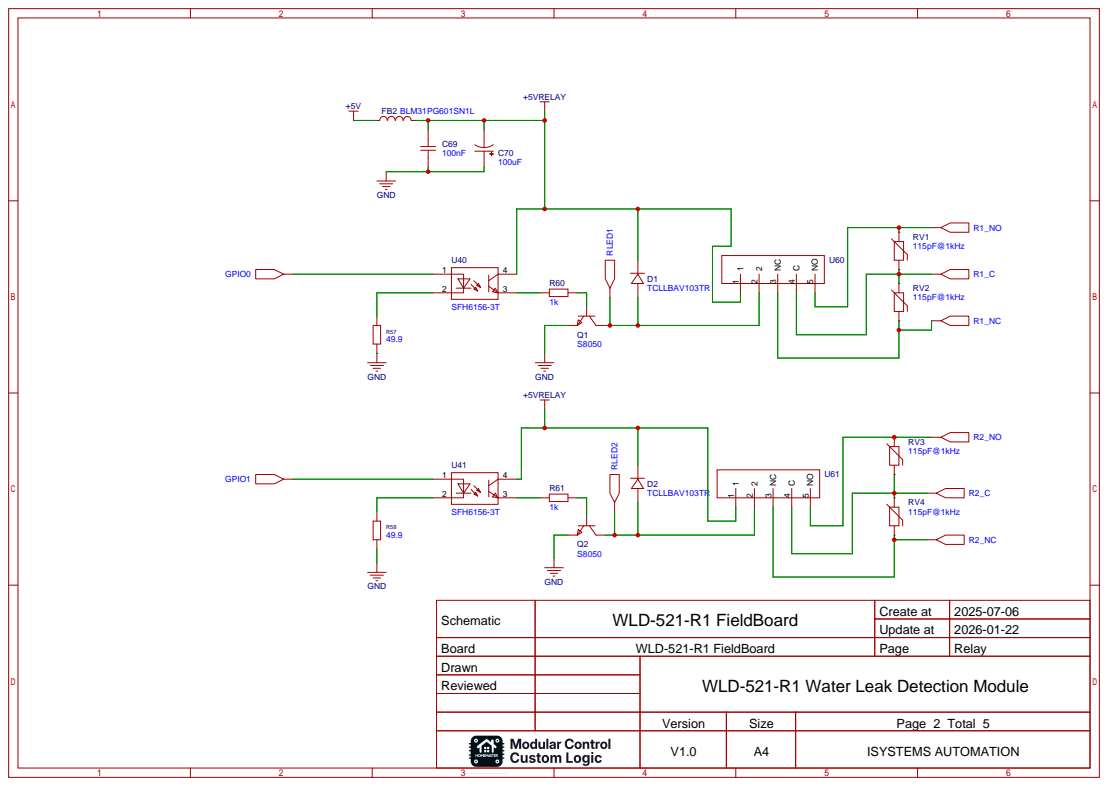
[picture p293: page 2]

Schematic | WLD-521-R1 FieldBoard | Create at | 2025-07-06

Update at | 2026-01-22

Board | WLD-521-R1 FieldBoard | Page | Relay
Drawn | | WLD-521-R1 Water Leak Detection Module
Reviewed

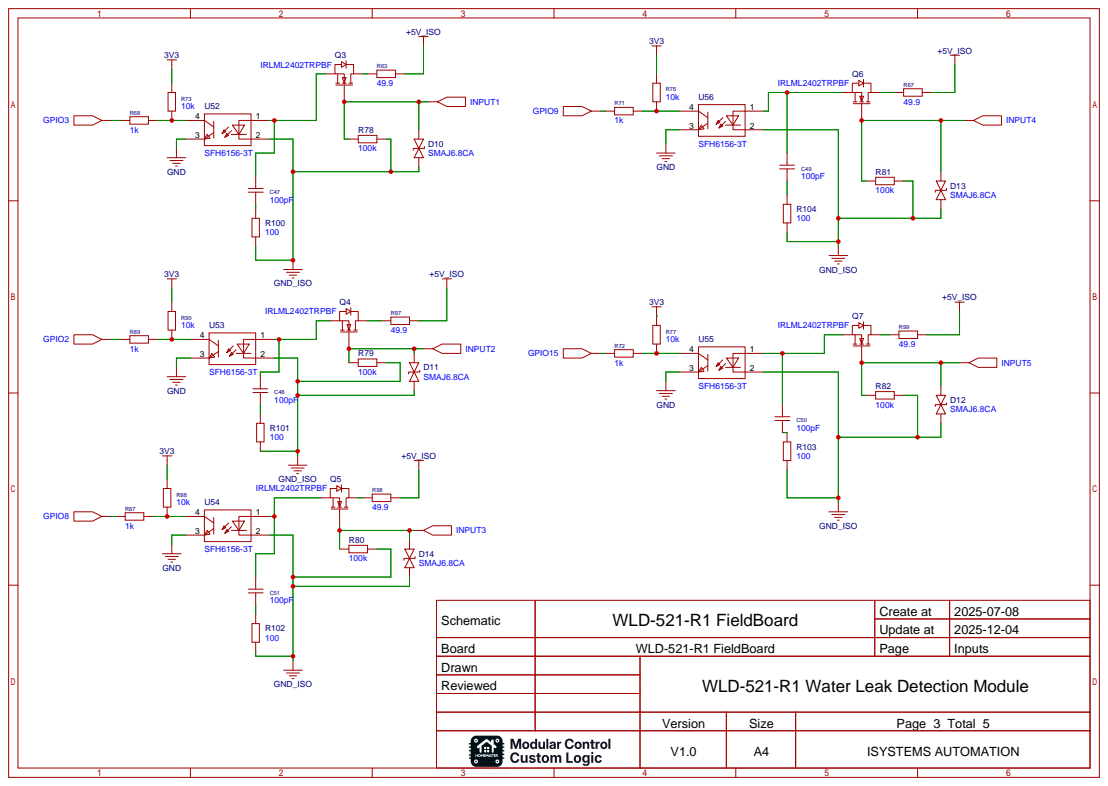
[picture p294: page 3]

Schematic | WLD-521-R1 FieldBoard | Create at | 2025-07-08

Update at | 2025-12-04

Board | WLD-521-R1 FieldBoard | Page | Inputs
Drawn | | WLD-521-R1 Water Leak Detection Module
Reviewed

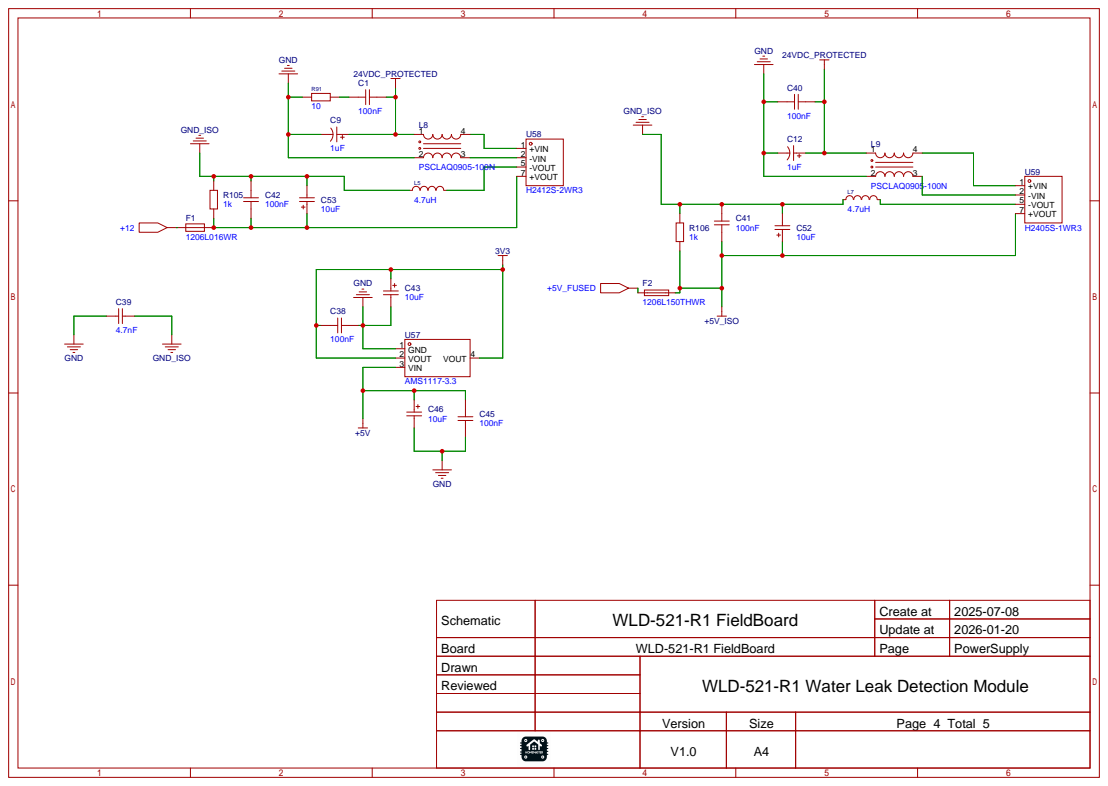
[picture p295: page 4]

Schematic | WLD-521-R1 FieldBoard | Create at | 2025-07-08

Update at | 2026-01-20

Board | WLD-521-R1 FieldBoard | Page | PowerSupply
Drawn | | WLD-521-R1 Water Leak Detection Module
Reviewed

Version | Size | Page 4 Total 5
V1.0 | A4

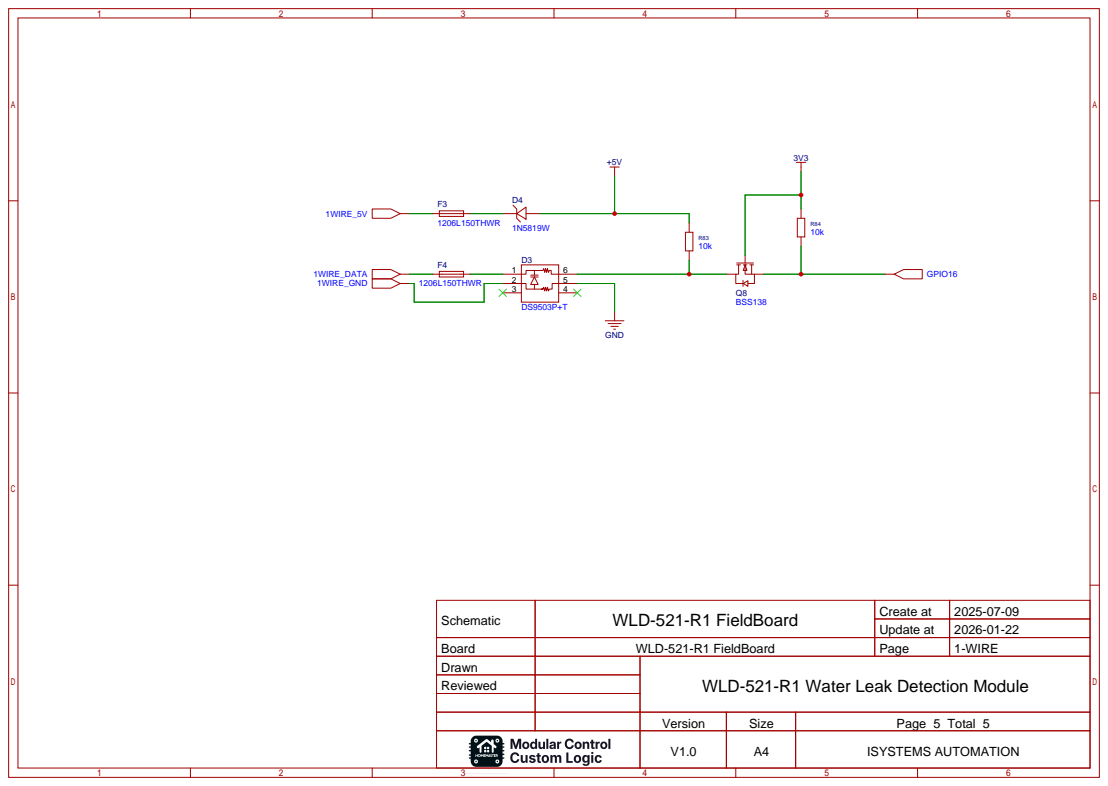
[picture p296: page 5]

Schematic | WLD-521-R1 FieldBoard | Create at | 2025-07-09

Update at | 2026-01-22

Board | WLD-521-R1 FieldBoard | Page | 1-WIRE
Drawn | | WLD-521-R1 Water Leak Detection Module
Reviewed
