isystemsautomation/HOMEMASTER/WLD-521-R1/Schematics/WLD-521-R1-MCUBoard.pdf

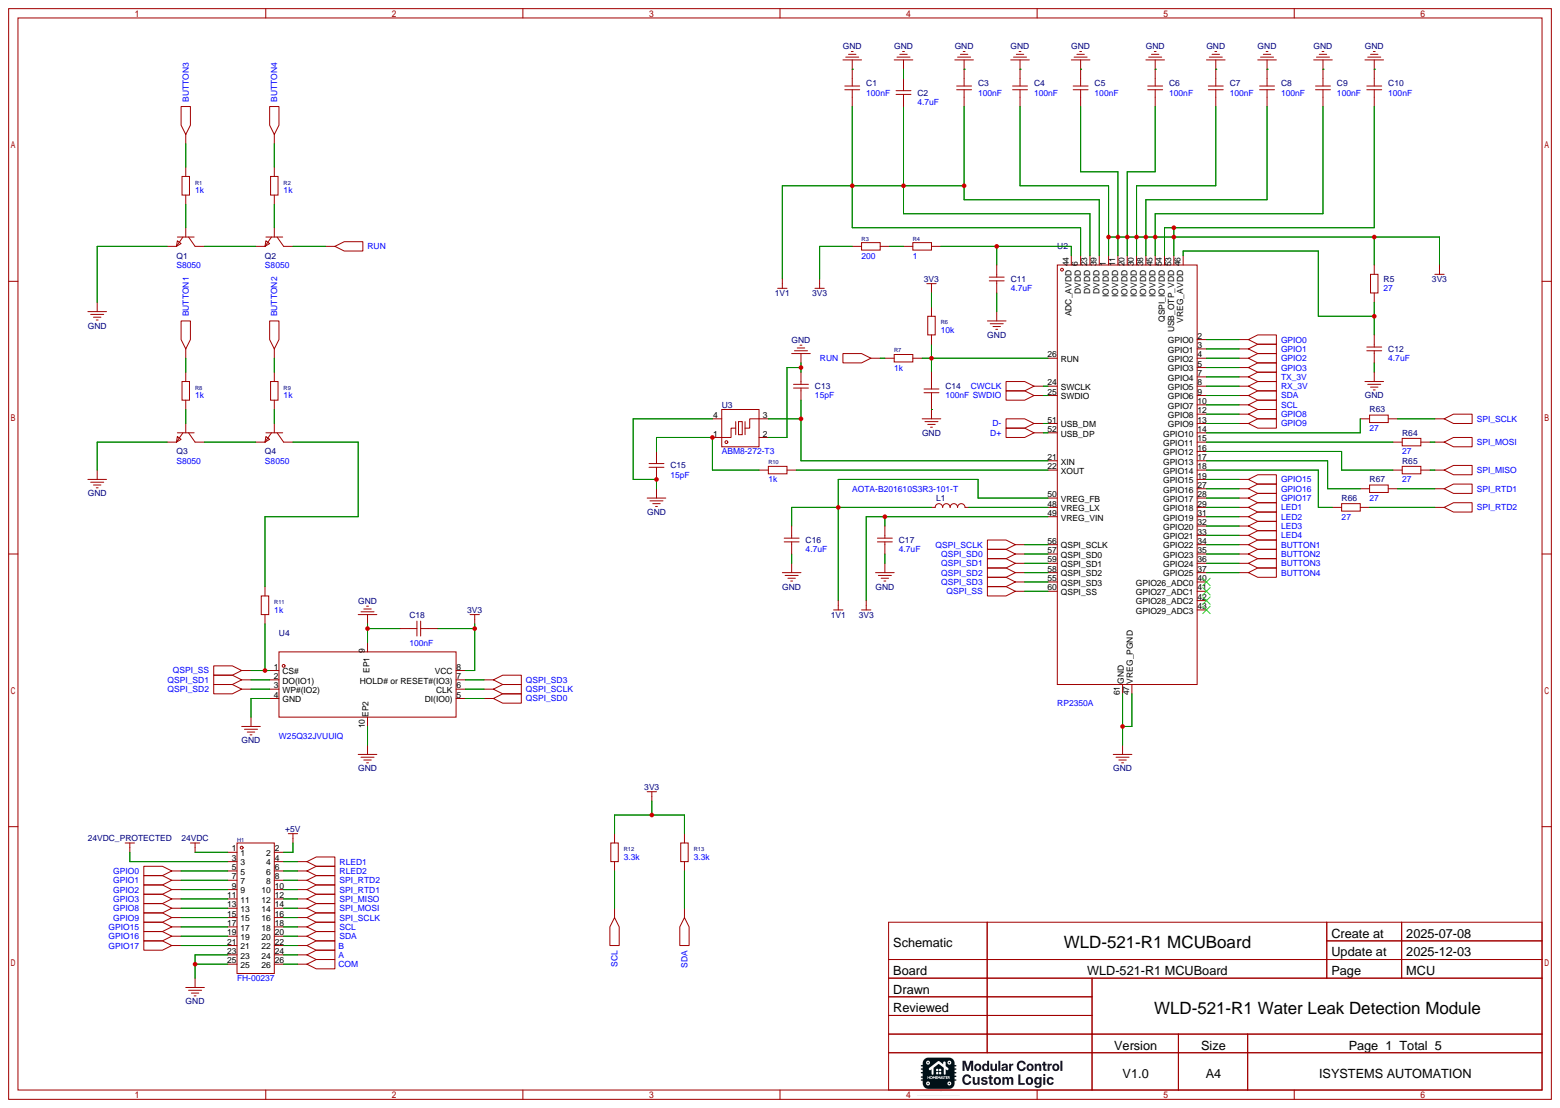
[picture p297: page 1]

Schematic | WLD-521-R1 MCUBoard | Create at | 2025-07-08

Update at | 2025-12-03

Board | WLD-521-R1 MCUBoard | Page | MCU
Drawn | | WLD-521-R1 Water Leak Detection Module
Reviewed

Version | Size | Page 1 Total 5
V1.0 | A4 | ISYSTEMS AUTOMATION

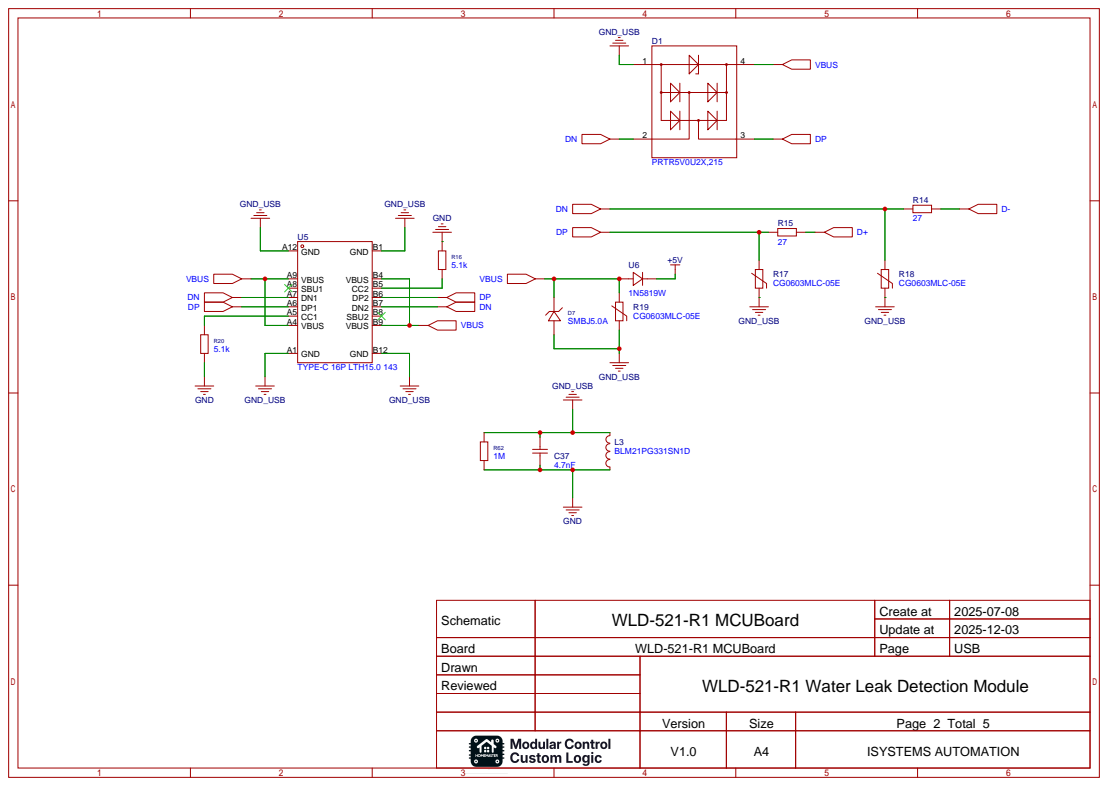
[picture p298: page 2]

Schematic | WLD-521-R1 MCUBoard | Create at | 2025-07-08

Update at | 2025-12-03

Board | WLD-521-R1 MCUBoard | Page | USB
Drawn | | WLD-521-R1 Water Leak Detection Module
Reviewed

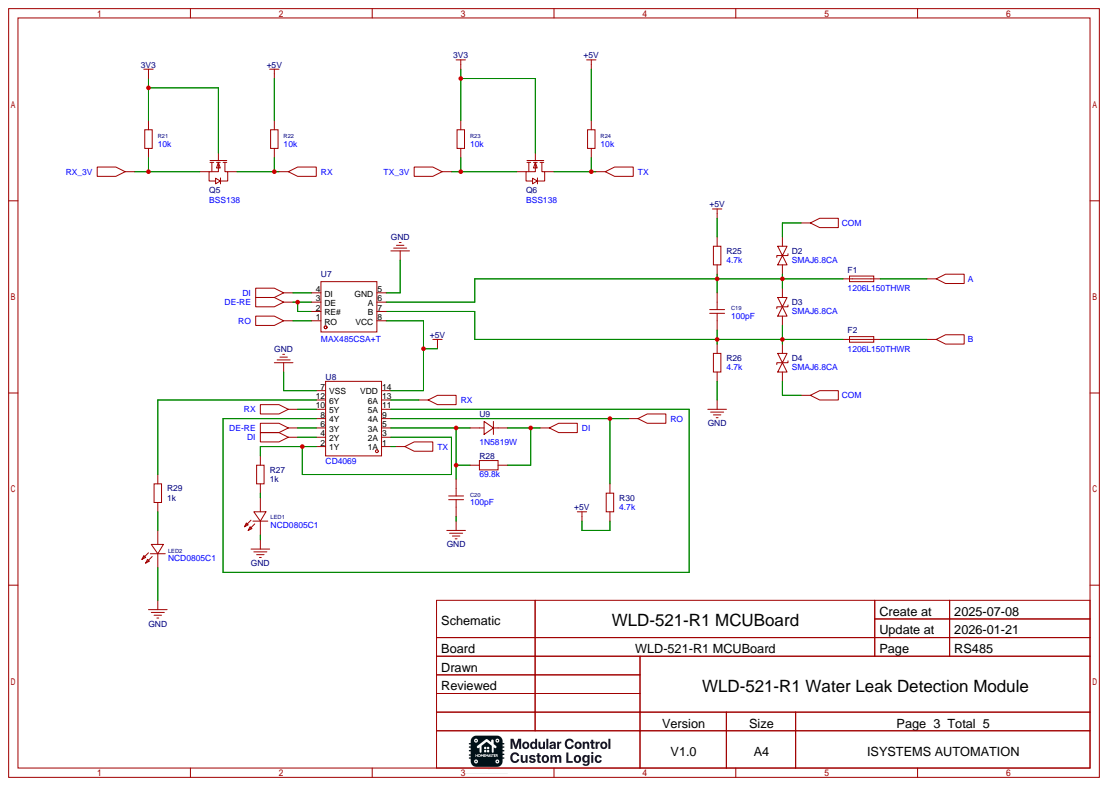
[picture p299: page 3]

Schematic | WLD-521-R1 MCUBoard | Create at | 2025-07-08

Update at | 2026-01-21

Board | WLD-521-R1 MCUBoard | Page | RS485
Drawn | | WLD-521-R1 Water Leak Detection Module
Reviewed

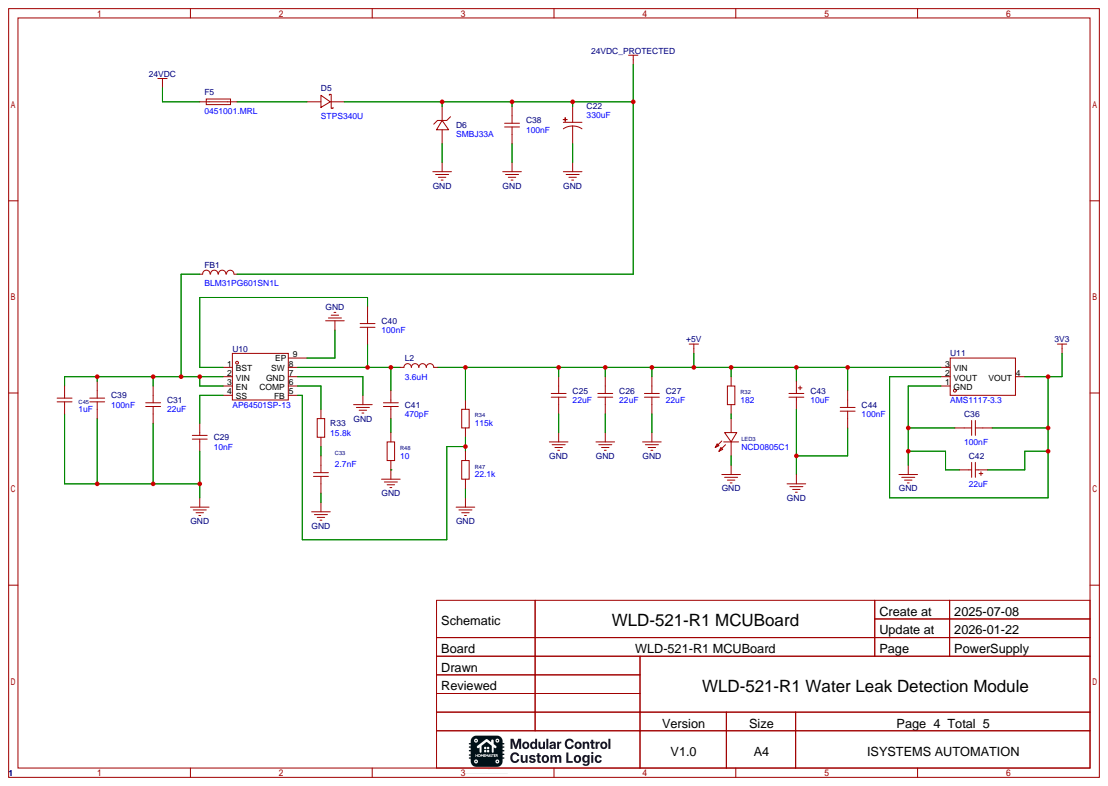
[picture p300: page 4]

Schematic | WLD-521-R1 MCUBoard | Create at | 2025-07-08

Update at | 2026-01-22

Board | WLD-521-R1 MCUBoard | Page | PowerSupply
Drawn | | WLD-521-R1 Water Leak Detection Module
Reviewed

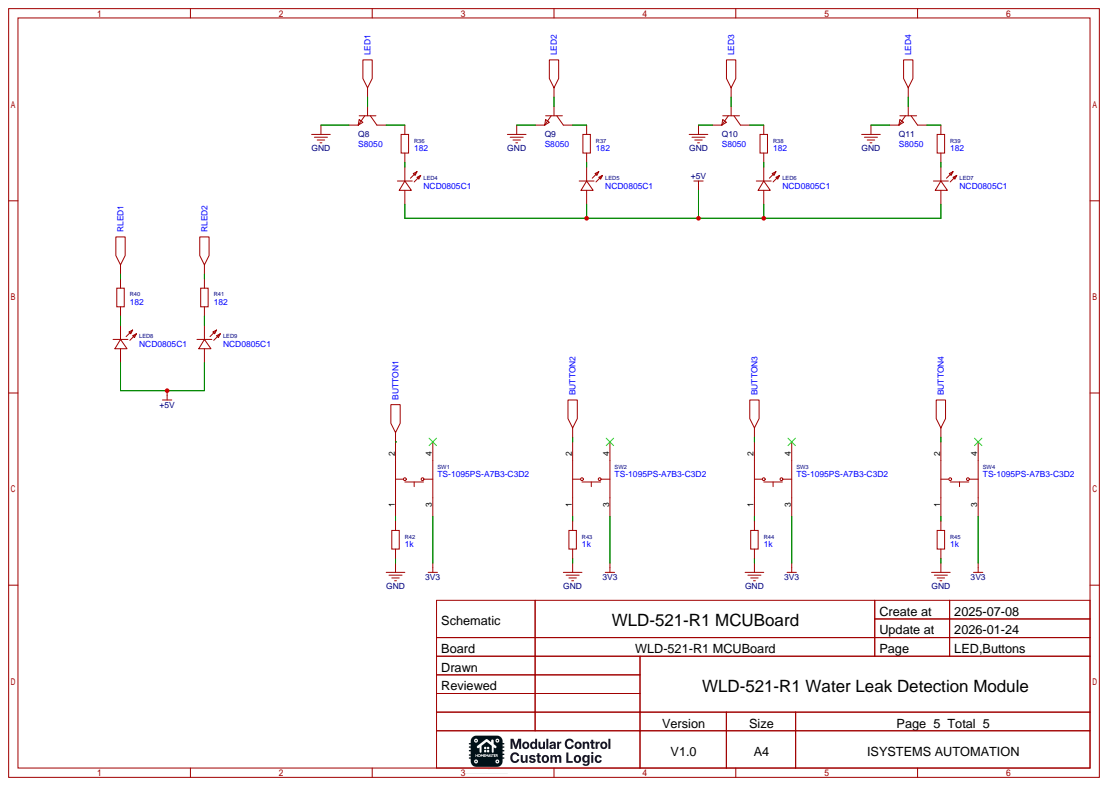
[picture p301: page 5]

Schematic | WLD-521-R1 MCUBoard | Create at | 2025-07-08

Update at | 2026-01-24

Board | WLD-521-R1 MCUBoard | Page | LED,Buttons
Drawn | | WLD-521-R1 Water Leak Detection Module
Reviewed
