isystemsautomation/HOMEMASTER/WLD-521-R1/Schematics/WLD-521-R1-RelayBoard.pdf

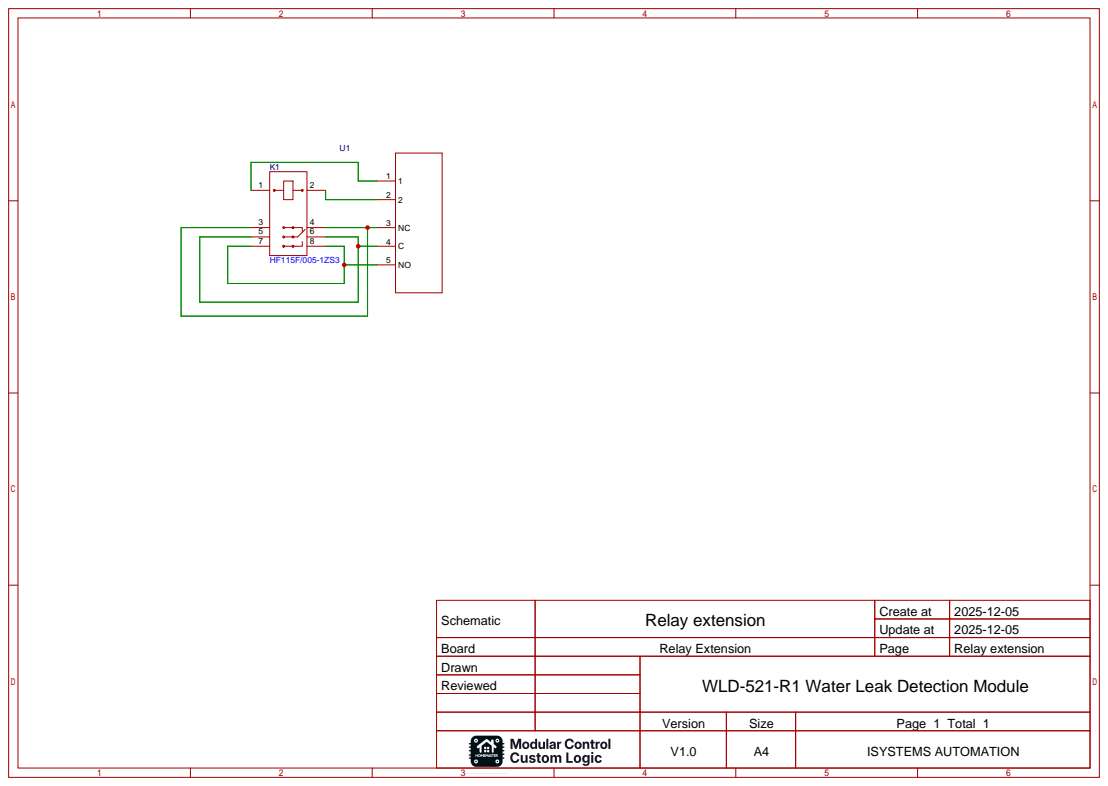
[picture p302: page 1]

Schematic | Relay extension | Create at | 2025-12-05

Update at | 2025-12-05

Board | Relay Extension | Page | Relay extension
Drawn | | WLD-521-R1 Water Leak Detection Module
Reviewed

Version | Size | Page 1 Total 1
V1.0 | A4 | ISYSTEMS AUTOMATION
