isystemsautomation/HOMEMASTER/DIM-420-R1/Schematics/DIM-420-R1-MOSFETBoard.pdf

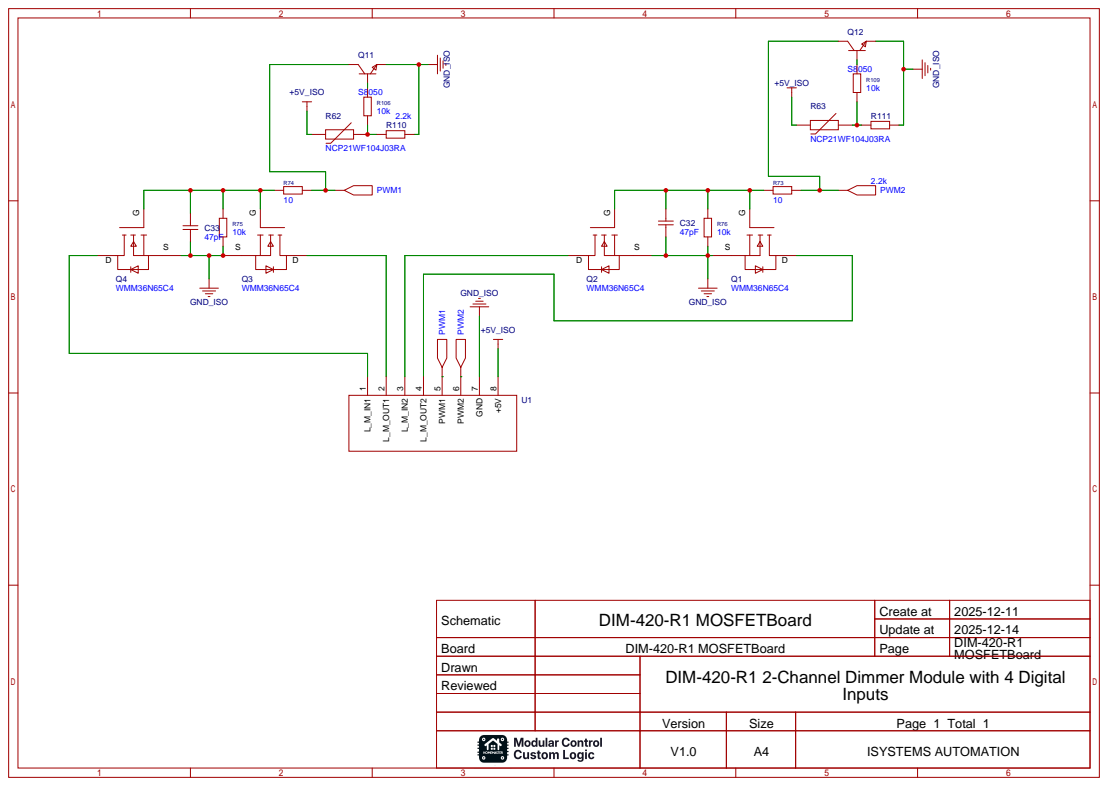
[picture p303: page 1]

Schematic | DIM-420-R1 MOSFETBoard | Create at | 2025-12-11
Board | DIM-420-R1 MOSFETBoard | Page | DIM-420-R1
Drawn | | DIM-420-R1 2-Channel Dimmer Module with 4 Digital Inputs Reviewed

Update at | 2025-12-14

Version | Size | Page 1 Total 1
V1.0 | A4 | ISYSTEMS AUTOMATION
