isystemsautomation/HOMEMASTER/RGB-621-R1/Schematics/RGB-621-R1-FieldBoard.pdf

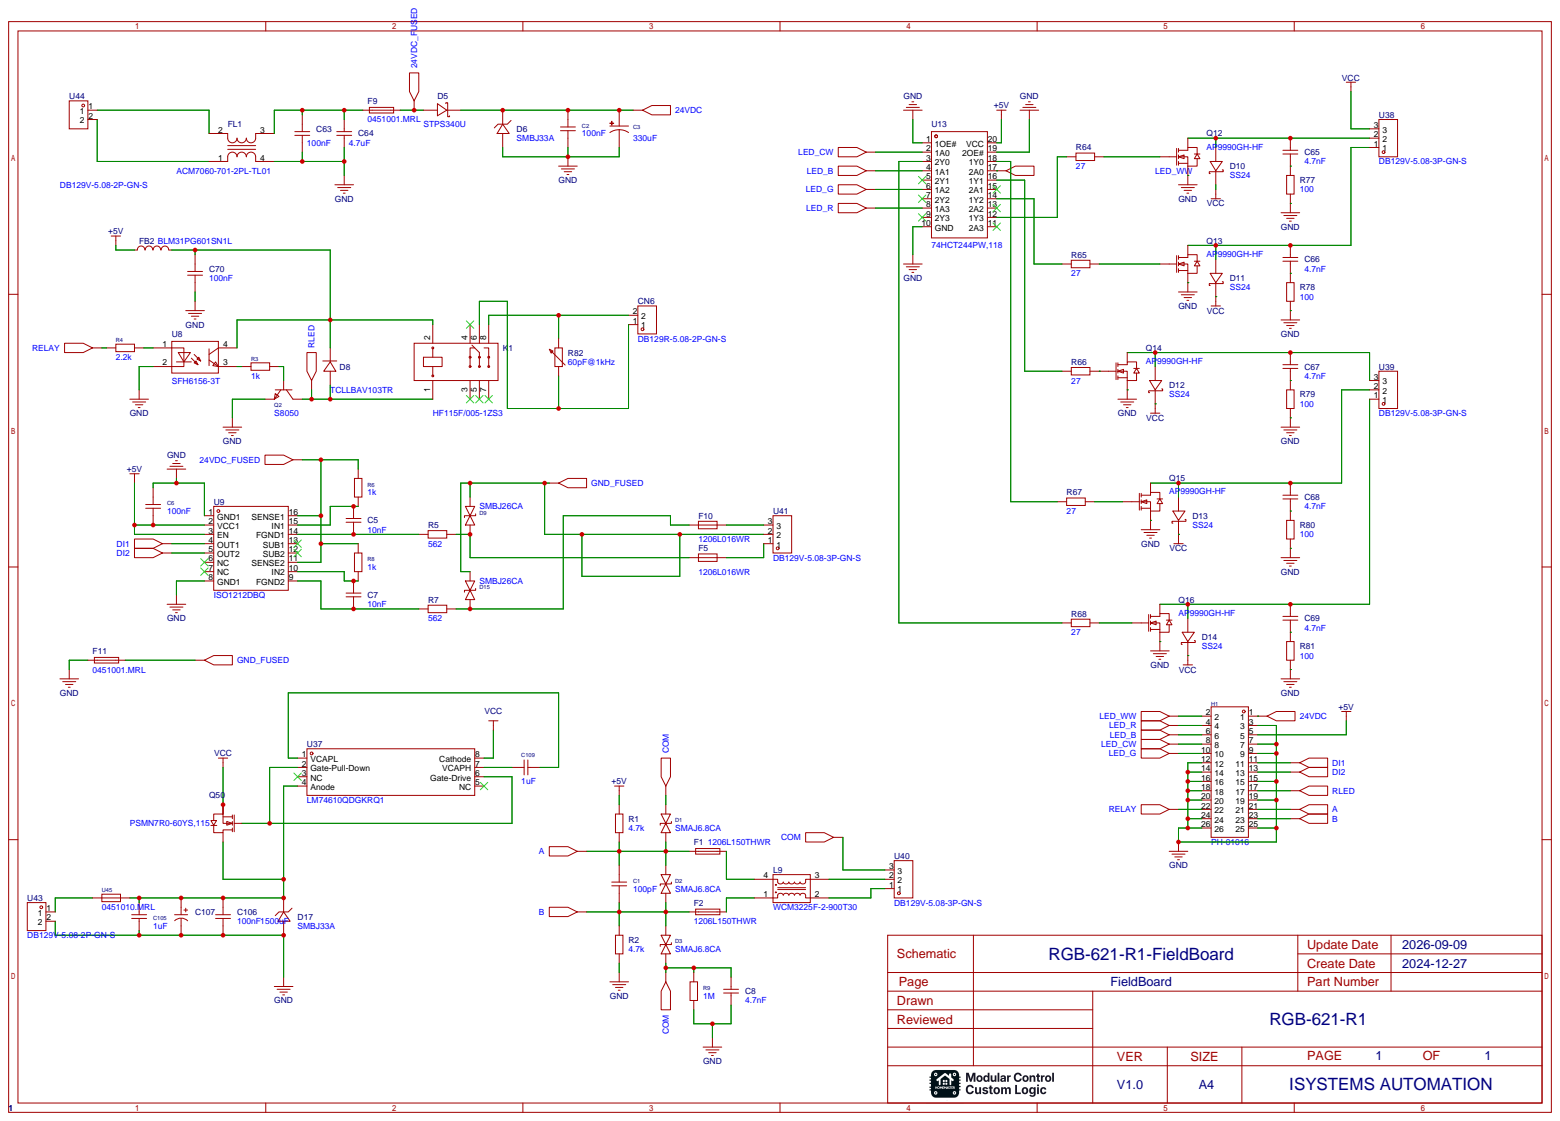
[picture p304: page 1]
