isystemsautomation/HOMEMASTER/DIO-430-R1/Schematics/DIO-430-R1-FieldBoard.pdf

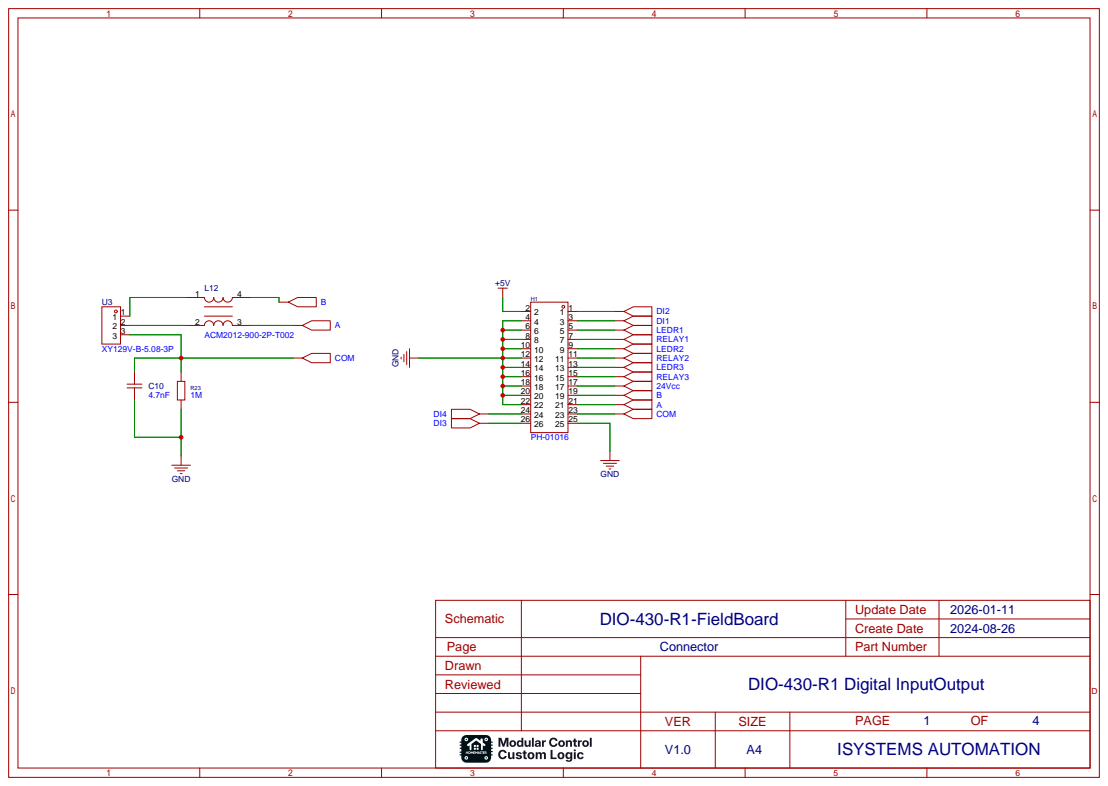
[picture p305: page 1]

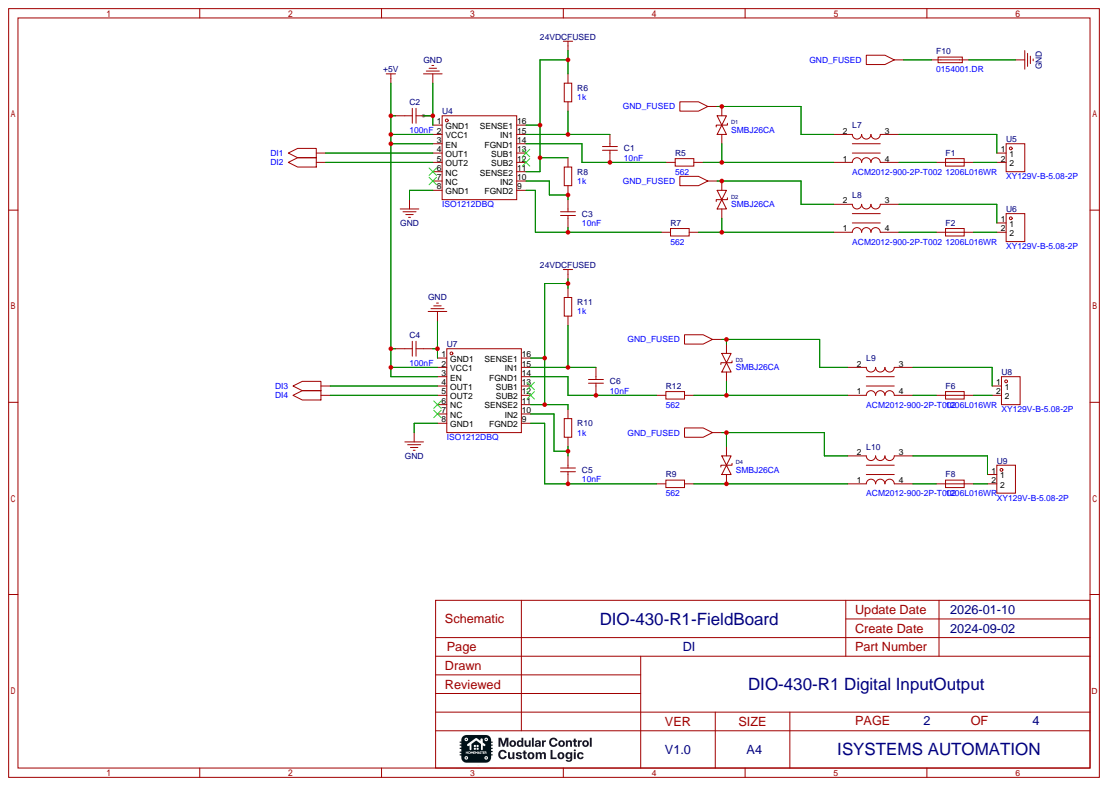
[picture p306: page 2]

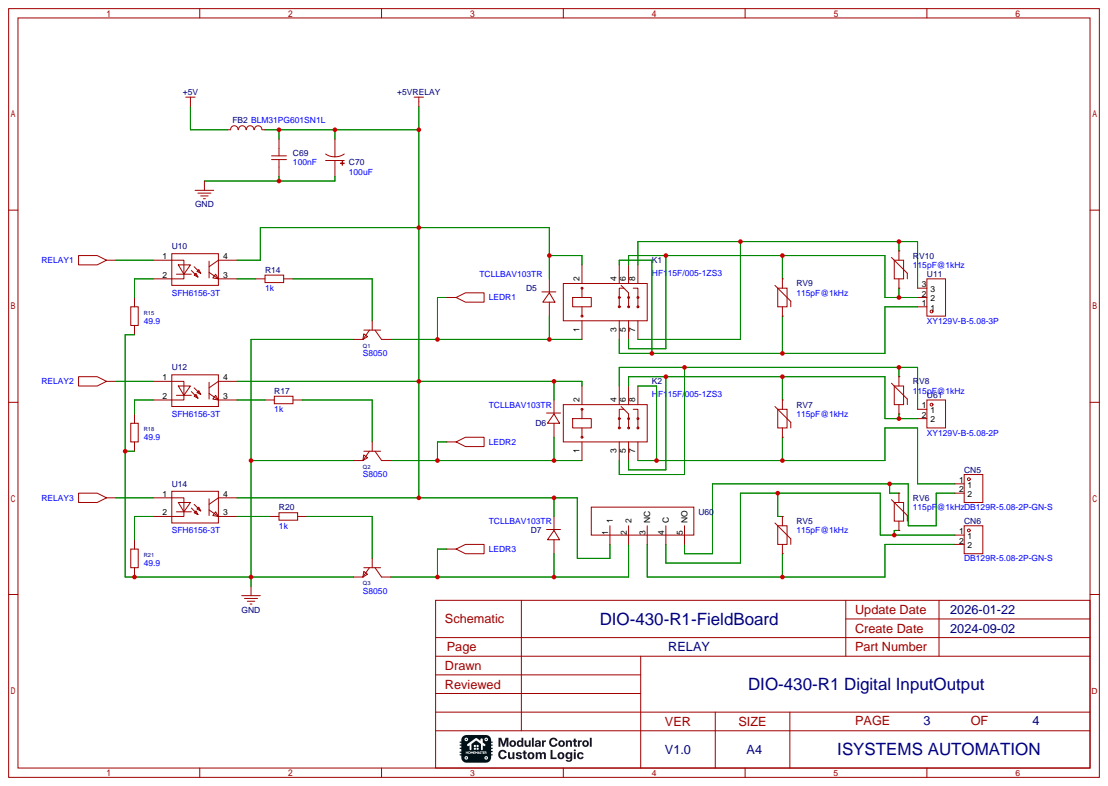
[picture p307: page 3]

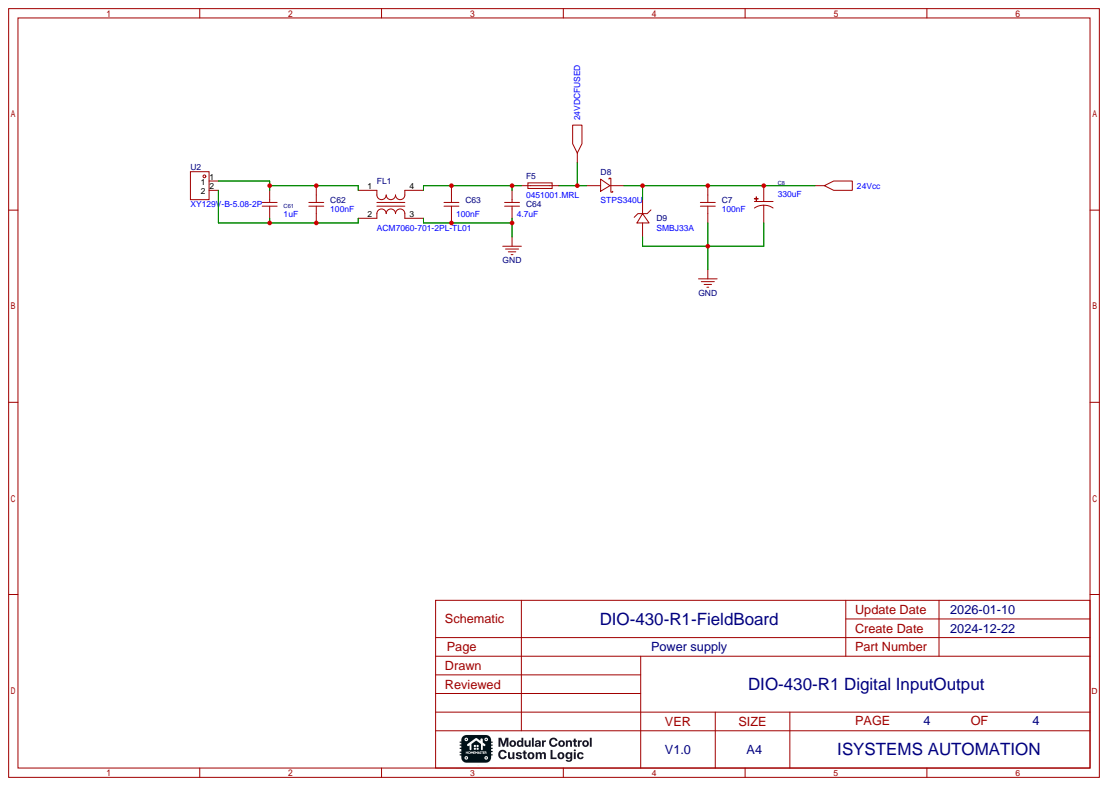
[picture p308: page 4]
