isystemsautomation/HOMEMASTER/DIO-430-R1/Schematics/DIO-430-R1-MCUBoard.pdf

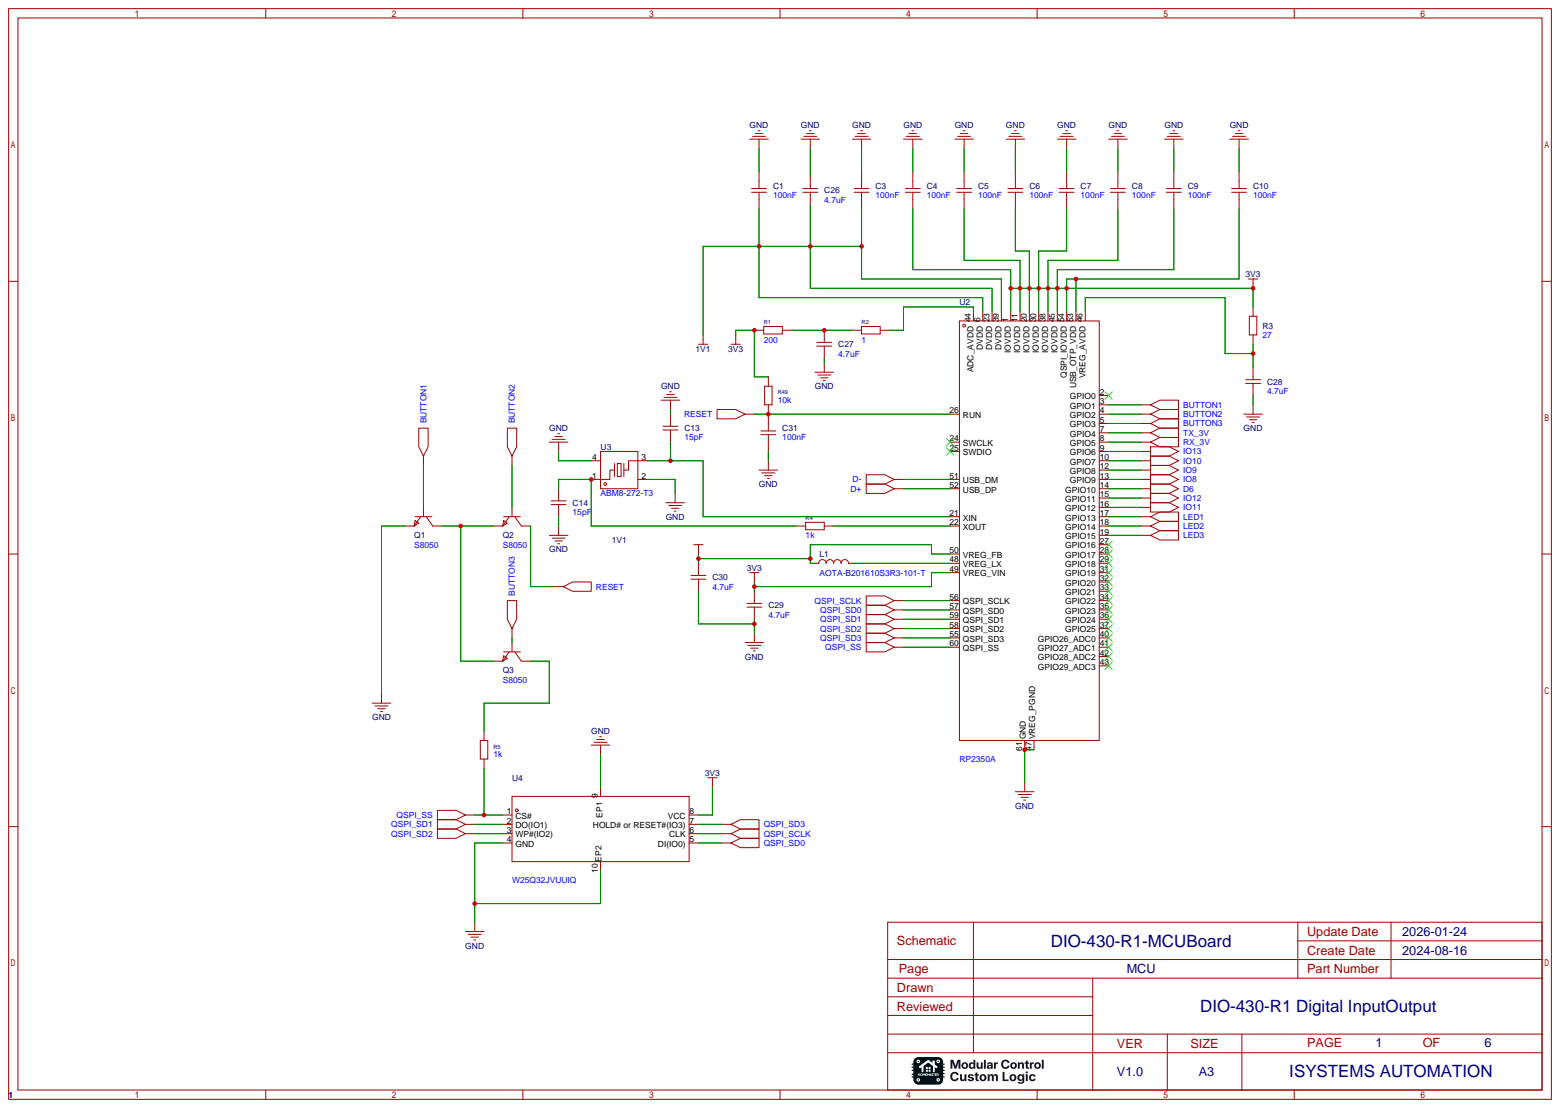
[picture p309: page 1]

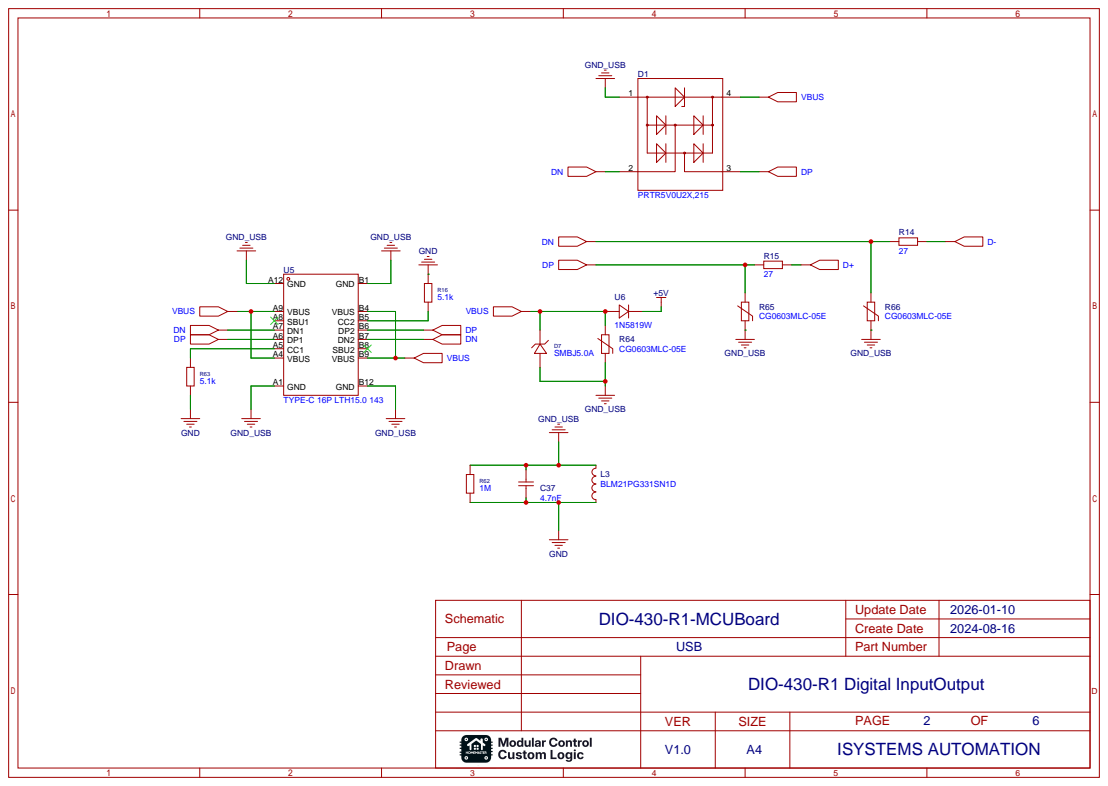
[picture p310: page 2]

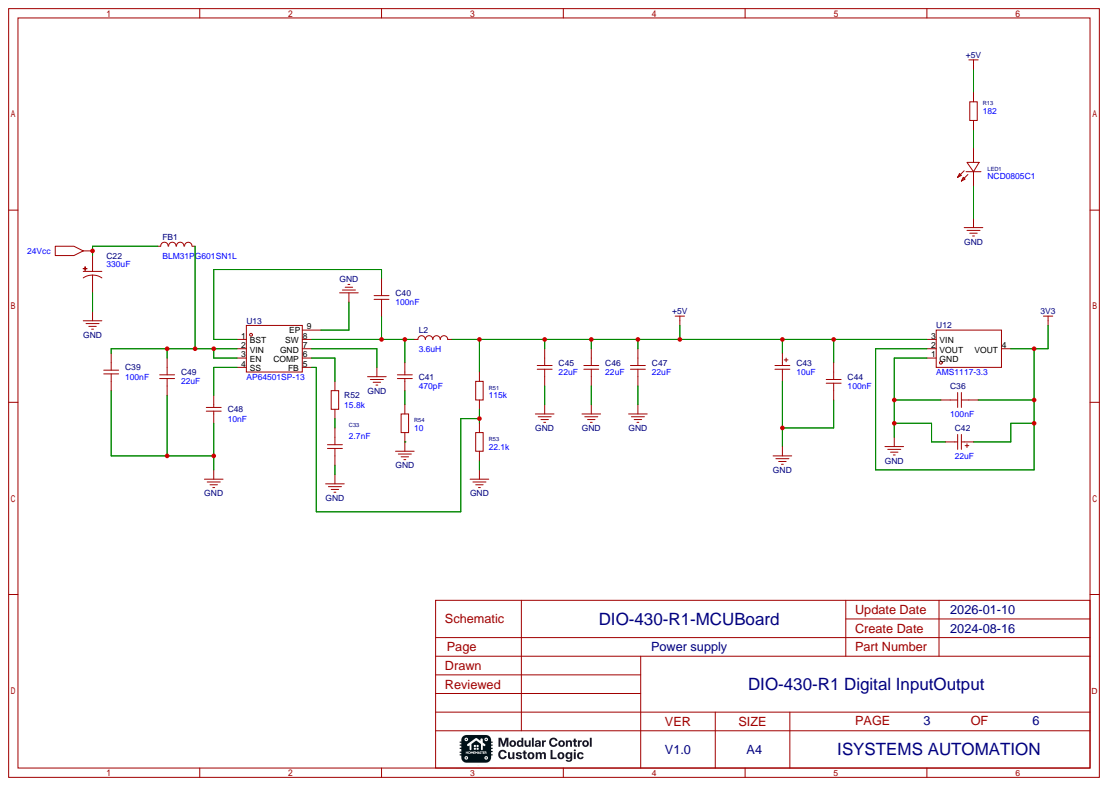
[picture p311: page 3]

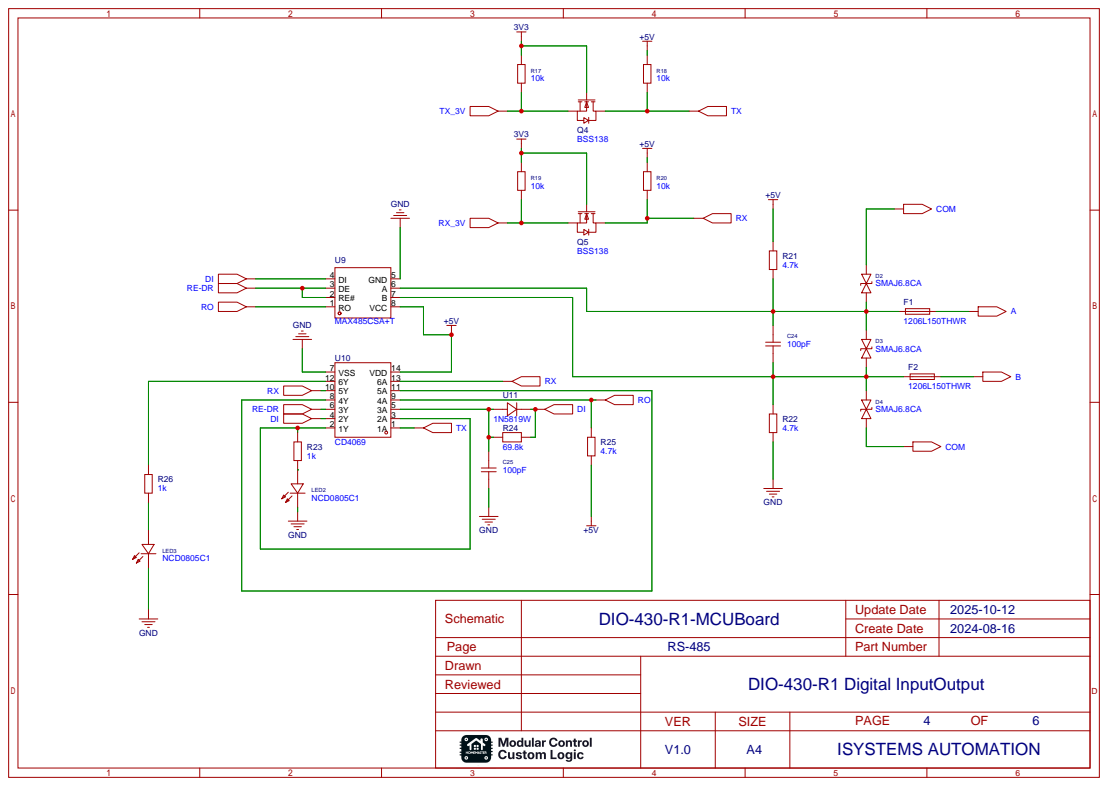
[picture p312: page 4]

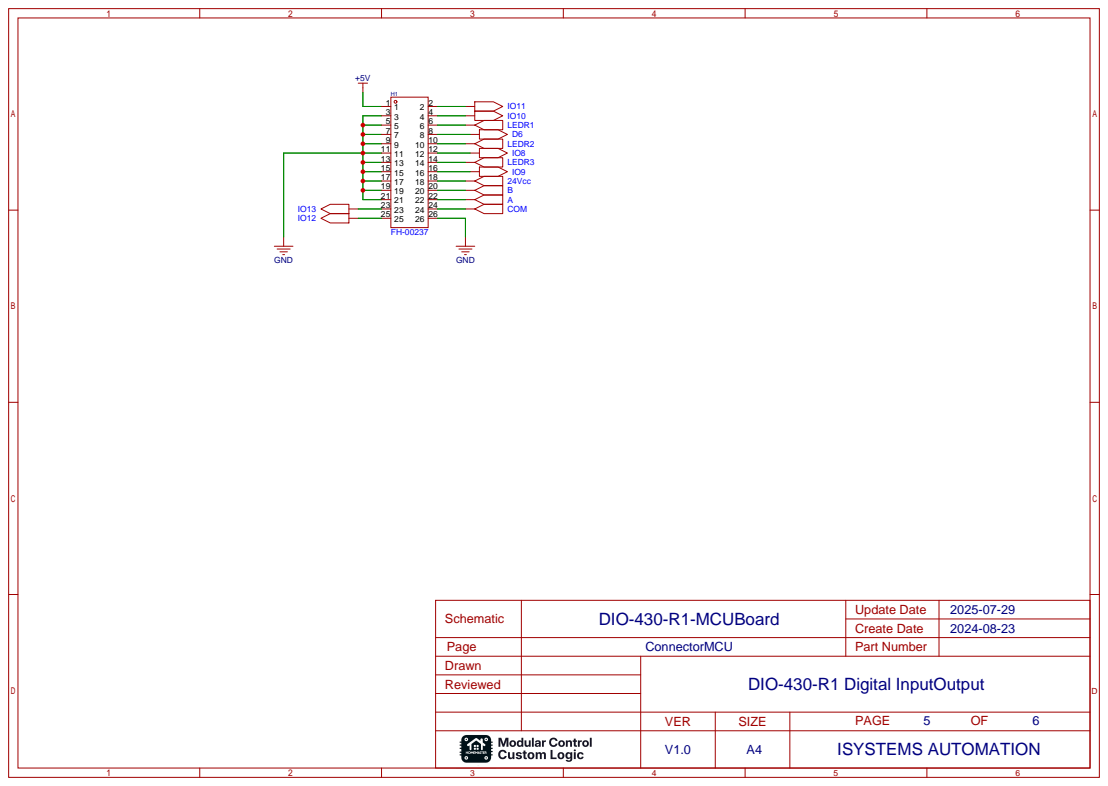
[picture p313: page 5]

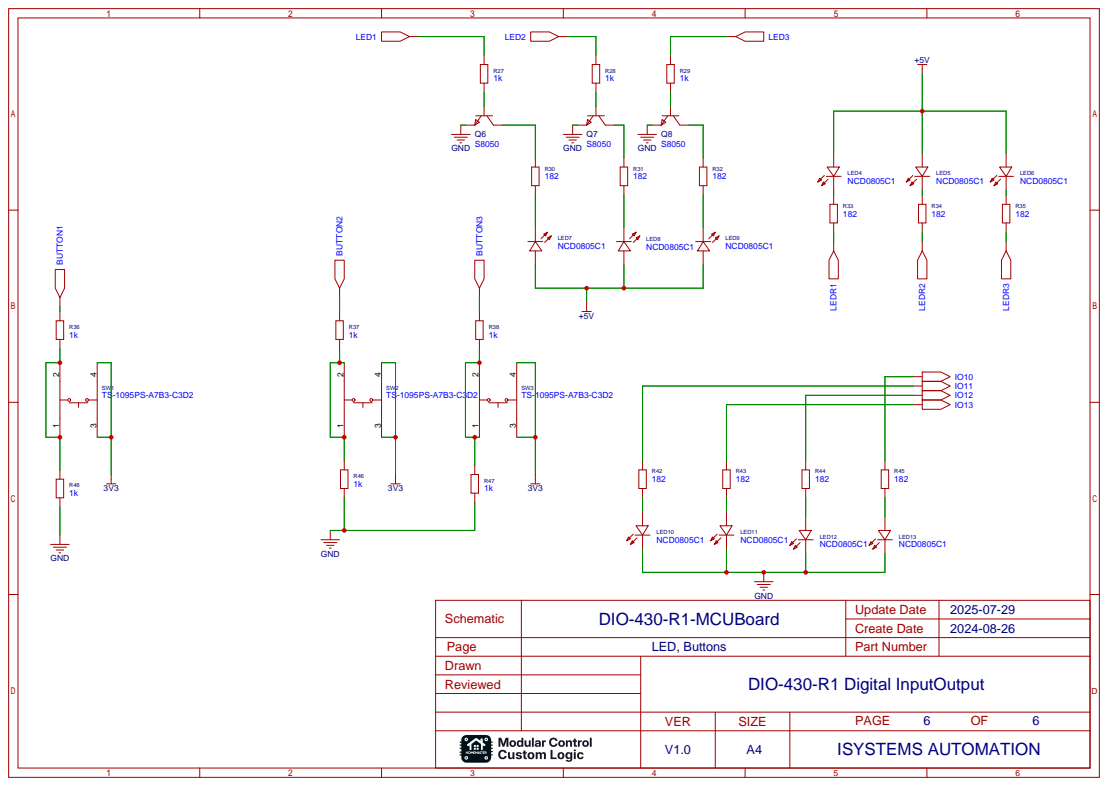
[picture p314: page 6]
