isystemsautomation/HOMEMASTER/OpenthermGateway/Schematic/MCUBoard.pdf

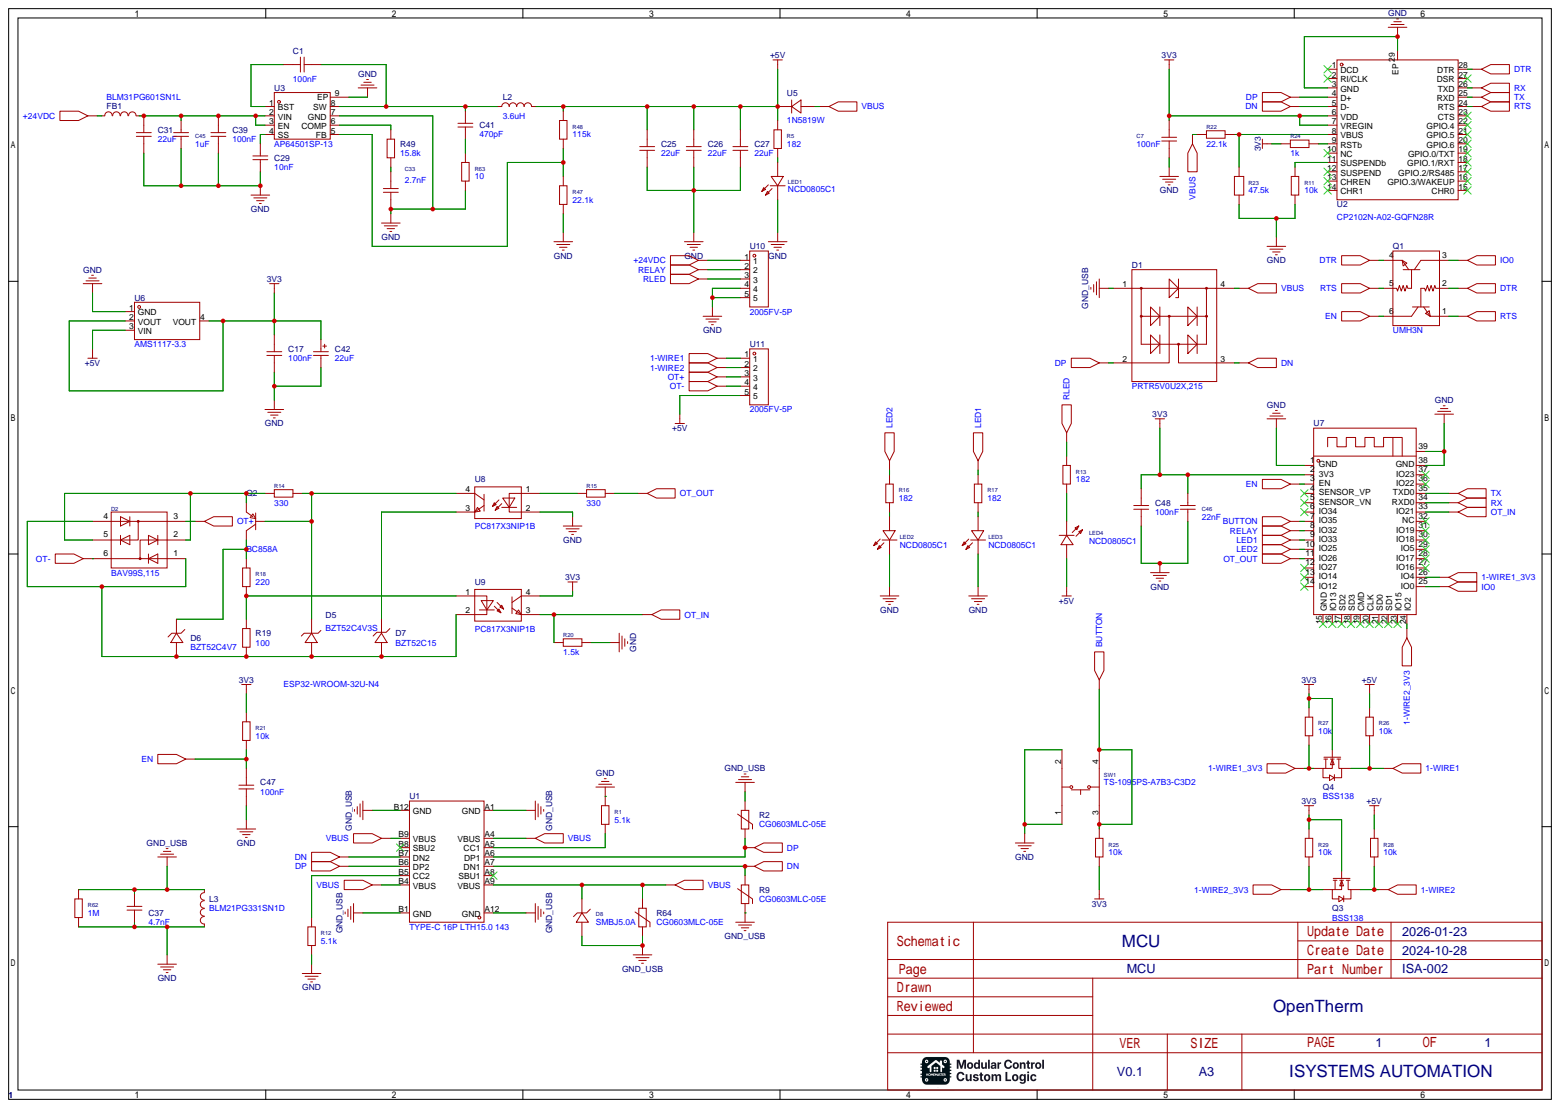
[picture p315: page 1]
