isystemsautomation/HOMEMASTER/AIO-422-R1/Firmware/default_aio_422_r1_plc/default_aio_422_r1_plc_full.yaml

modbus_controller:
  - id: ${aio_id}
    address: ${aio_address}
    modbus_id: modbus_bus
    update_interval: 3s
    allow_duplicate_commands: false

binary_sensor:
  # ---- Buttons (Discrete Inputs) ----
  - platform: modbus_controller
    modbus_controller_id: ${aio_id}
    name: "${aio_prefix} Button 1"
    address: 1
    register_type: discrete_input

  - platform: modbus_controller
    modbus_controller_id: ${aio_id}
    name: "${aio_prefix} Button 2"
    address: 2
    register_type: discrete_input

  - platform: modbus_controller
    modbus_controller_id: ${aio_id}
    name: "${aio_prefix} Button 3"
    address: 3
    register_type: discrete_input

  - platform: modbus_controller
    modbus_controller_id: ${aio_id}
    name: "${aio_prefix} Button 4"
    address: 4
    register_type: discrete_input

  # ---- LEDs (Discrete Inputs) ----
  - platform: modbus_controller
    modbus_controller_id: ${aio_id}
    name: "${aio_prefix} LED 1"
    address: 20
    register_type: discrete_input

  - platform: modbus_controller
    modbus_controller_id: ${aio_id}
    name: "${aio_prefix} LED 2"
    address: 21
    register_type: discrete_input

  - platform: modbus_controller
    modbus_controller_id: ${aio_id}
    name: "${aio_prefix} LED 3"
    address: 22
    register_type: discrete_input

  - platform: modbus_controller
    modbus_controller_id: ${aio_id}
    name: "${aio_prefix} LED 4"
    address: 23
    register_type: discrete_input


# ================= WRITEABLE Holding Registers =================
number:
  # ---- DAC outputs ----
  - platform: modbus_controller
    modbus_controller_id: ${aio_id}
    name: "${aio_prefix} AO0 Raw"
    address: 200
    register_type: holding
    value_type: U_WORD
    min_value: 0
    max_value: 4095
    step: 1
    mode: slider

  - platform: modbus_controller
    modbus_controller_id: ${aio_id}
    name: "${aio_prefix} AO1 Raw"
    address: 201
    register_type: holding
    value_type: U_WORD
    min_value: 0
    max_value: 4095
    step: 1
    mode: slider

  # ---- Global Modbus Setpoints: SP1..SP4 (S_WORD) @ 300..303 ----
  - platform: modbus_controller
    modbus_controller_id: ${aio_id}
    name: "${aio_prefix} SP1 (Modbus) Raw"
    id: aio_1_sp1_modbus_raw
    address: 300
    register_type: holding
    value_type: S_WORD
    step: 1
    mode: box

  - platform: modbus_controller
    modbus_controller_id: ${aio_id}
    name: "${aio_prefix} SP2 (Modbus) Raw"
    address: 301
    register_type: holding
    value_type: S_WORD
    step: 1
    mode: box

  - platform: modbus_controller
    modbus_controller_id: ${aio_id}
    name: "${aio_prefix} SP3 (Modbus) Raw"
    address: 302
    register_type: holding
    value_type: S_WORD
    step: 1
    mode: box
    disabled_by_default: true

  - platform: modbus_controller
    modbus_controller_id: ${aio_id}
    name: "${aio_prefix} SP4 (Modbus) Raw"
    address: 303
    register_type: holding
    value_type: S_WORD
    step: 1
    mode: box
    disabled_by_default: true

  # ---- PID Enable 310..313 (0/1) ----
  - platform: modbus_controller
    modbus_controller_id: ${aio_id}
    name: "${aio_prefix} PID1 Enable"
    address: 310
    register_type: holding
    value_type: U_WORD
    min_value: 0
    max_value: 1
    step: 1
    mode: box

  - platform: modbus_controller
    modbus_controller_id: ${aio_id}
    name: "${aio_prefix} PID2 Enable"
    address: 311
    register_type: holding
    value_type: U_WORD
    min_value: 0
    max_value: 1
    step: 1
    mode: box

  - platform: modbus_controller
    modbus_controller_id: ${aio_id}
    name: "${aio_prefix} PID3 Enable"
    address: 312
    register_type: holding
    value_type: U_WORD
    min_value: 0
    max_value: 1
    step: 1
    mode: box
    disabled_by_default: true

  - platform: modbus_controller
    modbus_controller_id: ${aio_id}
    name: "${aio_prefix} PID4 Enable"
    address: 313
    register_type: holding
    value_type: U_WORD
    min_value: 0
    max_value: 1
    step: 1
    mode: box
    disabled_by_default: true

  # ---- PID gains RAW (x100): Kp 350..353, Ki 360..363, Kd 370..373 ----
  - platform: modbus_controller
    modbus_controller_id: ${aio_id}
    name: "${aio_prefix} PID1 Kp x100"
    address: 350
    register_type: holding
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
    disabled_by_default: true

  - platform: modbus_controller
    modbus_controller_id: ${aio_id}
    name: "${aio_prefix} PID4 Kd"
    address: 373
    register_type: holding
    value_type: S_WORD
    accuracy_decimals: 2
    filters: [ multiply: 0.01 ]
    disabled_by_default: true
