isystemsautomation/HOMEMASTER/ENM-223-R1/Firmware/default_enm_223_r1/atm90e32.h

#pragma once
#include <Arduino.h>
#include <SPI.h>

// RP2350-focused ATM90E32 driver (SPI, no external libs)
// - Uses SPI transactions
// - Assumes CS is active-low by default
// - PM0/PM1 are MCU outputs into ATM (per your schematic)

struct M90PhaseCal {
  uint16_t Ugain;
  uint16_t Igain;
  int16_t  Uoffset;
  int16_t  Ioffset;
};

struct M90DiagRegs {
  uint16_t EMMState0;
  uint16_t EMMState1;
  uint16_t EMMIntState0;
  uint16_t EMMIntState1;
  uint16_t CRCErrStatus;
  uint16_t LastSPIData;
};

class ATM90E32 {
public:
  ATM90E32(SPIClass &spi, uint8_t pinCS, uint8_t pinPM0, uint8_t pinPM1,
           uint32_t spiHz = 200000, uint8_t spiMode = SPI_MODE0,
           bool csActiveHigh = false)
  : spi_(spi), cs_(pinCS), pm0_(pinPM0), pm1_(pinPM1),
    spiHz_(spiHz), spiMode_(spiMode), csActiveHigh_(csActiveHigh) {}

  void begin(uint16_t lineHz, uint8_t sumAbs, uint16_t ucal, const M90PhaseCal cal[3]);
  void applyCalibration(const M90PhaseCal cal[3]);

  // Live helpers (scales chosen to match typical UI: V in 0.01, A in 0.001)
  double readUrmsA_V(); double readUrmsB_V(); double readUrmsC_V();
  double readIrmsA_A(); double readIrmsB_A(); double readIrmsC_A();

  int16_t  readPFmeanA(); int16_t readPFmeanB(); int16_t readPFmeanC(); int16_t readPFmeanT();
  int16_t  readPAngleA(); int16_t readPAngleB(); int16_t readPAngleC();
  uint16_t readFreq_x100();
  int16_t  readTempC();

  // Energy counters (raw chip counts)
  uint16_t rdAP_A(); uint16_t rdAP_B(); uint16_t rdAP_C(); uint16_t rdAP_T();
  uint16_t rdAN_A(); uint16_t rdAN_B(); uint16_t rdAN_C(); uint16_t rdAN_T();
  uint16_t rdRP_A(); uint16_t rdRP_B(); uint16_t rdRP_C(); uint16_t rdRP_T();
  uint16_t rdRN_A(); uint16_t rdRN_B(); uint16_t rdRN_C(); uint16_t rdRN_T();
  uint16_t rdSA_A(); uint16_t rdSA_B(); uint16_t rdSA_C(); uint16_t rdSA_T();

  M90DiagRegs readDiag();

  // Config currently applied
  uint16_t lineHz() const { return lineHz_; }
  uint8_t  sumAbs() const { return sumAbs_; }
  uint16_t ucal()   const { return ucal_; }

private:
  uint16_t xfer(uint8_t rw, uint16_t reg, uint16_t val);
  inline void csAssert()  { digitalWrite(cs_, csActiveHigh_ ? HIGH : LOW);  }
  inline void csRelease() { digitalWrite(cs_, csActiveHigh_ ? LOW  : HIGH); }
  inline uint16_t read16(uint16_t reg) { return xfer(1, reg, 0xFFFF); }
  inline void     write16(uint16_t reg, uint16_t val) { (void)xfer(0, reg, val); }

  double readRmsLike(uint16_t regH, uint16_t regLSB, double sH, double sLb);

  uint16_t lineHz_ = 50;
  uint8_t  sumAbs_ = 1;
  uint16_t ucal_   = 25256;

  SPIClass &spi_;
  uint8_t cs_, pm0_, pm1_;
  uint32_t spiHz_;
  uint8_t  spiMode_;
  bool     csActiveHigh_;
};
