isystemsautomation/HOMEMASTER/(commit log)

2025-04-15 Schematics update
2025-07-26 MiniPLC update schematics
2025-07-26 MicroPLC update Schematics
2025-07-26 OpenTherm update Schematics
2025-07-31 addin button state
2025-10-03 гзвфку
2025-10-13 update schematics
2026-01-17 wld update
    [ConfigToolPage_original_backup.txt]
2026-01-28 update power supply
2026-09-09 RGB-621-R1: update FieldBoard schematic PDF; add logo assets
2026-09-09 RGB-621-R1 v0.2.0: deterministic PWM slice phase alignment at boot
    Spread slices 4/5/6 to 0°, 120°, 240° once after 12-bit PWM init to cut
    in-phase LED PS ripple; runtime analogWrite only updates channel levels.
2026-09-09 RGB-621-R1: document 10 A shared LED PS limit (module and per channel)
    Replace superseded per-channel and shipping-board wording with the 10 A fuse
    design limit, ideal-diode LED path, and binding terminal/thermal constraints.
2026-09-09 Manuals: republish all module datasheets from source docx
    RGB-621-R1: 10 A shared LED PS limit, ideal-diode protection, DB129V
    terminals; other modules re-exported from Nextcloud Word sources.
2026-09-09 RGB-621-R1 datasheet: align dimensions, power, humidity and terminals
    Match README/ePRJ: 52.5×90.6×67.3 mm, 1.85/3.0 W logic power, ≤95 % RH,
    bottom-row +/R/G/B/CW/WW/COM/A/B order, 0.25 kg net weight.
2026-09-09 STR-3221-R1: correct defaults to addr 3 / 19200, add command coils, fix LED count and pin map
2026-09-10 Add partner-kit reseller content pack (2026.09).
    Eleven modules with WebP images, rewritten descriptions, specs CSV,
    DoC and datasheets from Manuals/, plus downloadable ZIP archive.
    [index.csv, specs.csv]
