isystemsautomation/HOMEMASTER/(notices)

Notices in the files:
ALM-173-R1/README.md:
License: GPLv3 / CERN-OHL-W
STR-3221-R1/README.md:
License: MIT / CERN-OHL-W
README.md:
License: CERN-OHL-W v2 + GPLv3 + MIT
